Kageni-wq/kicad/README.md

# kicad
Kicad footprint and symbol library
