Kageni-wq/kicad/3dmodels/SDCL1V2010-1R0N-R.STEP

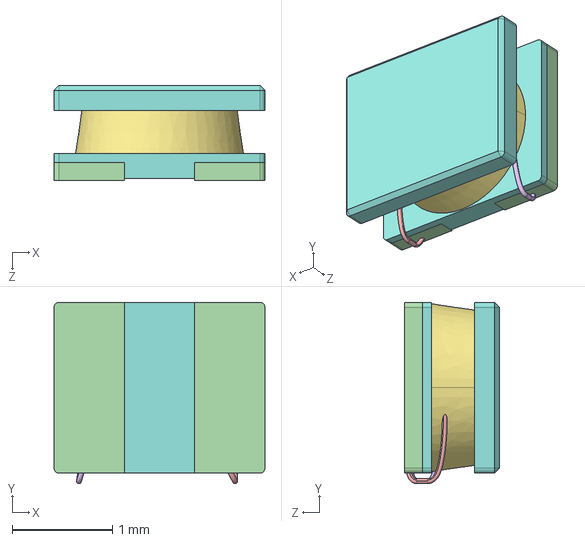
[picture p5: CAD file, 2026-09-29]
3dmodels/SDCL1V2010-1R0N-R.STEP
2.10 x 1.80 x 0.95 mm
