Kageni-wq/kicad/3dmodels/FH34SRJ-30S-0.5SH_50_.step

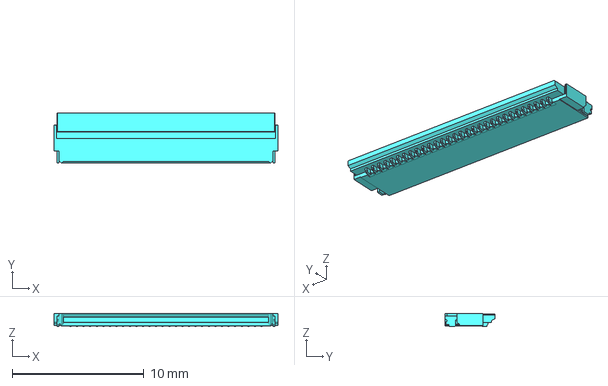
[picture p6: CAD file, 2026-08-24]
3dmodels/FH34SRJ-30S-0.5SH_50_.step
17.0 x 3.80 x 1.00 mm
