Kageni-wq/kicad/3dmodels/OK14F024.STEP

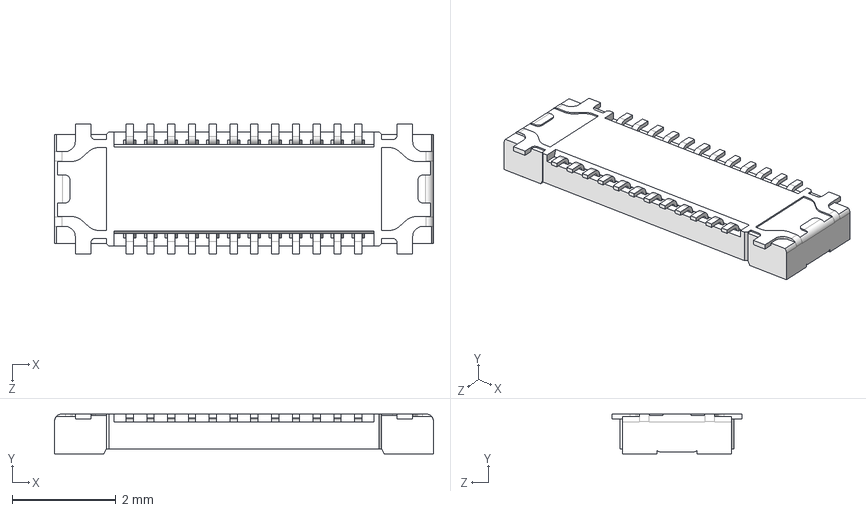
[picture p7: CAD file, 2026-08-16]
3dmodels/OK14F024.STEP
7.30 x 0.77 x 2.50 mm
