Kageni-wq/kicad/3dmodels/WS2812C_2020.STEP

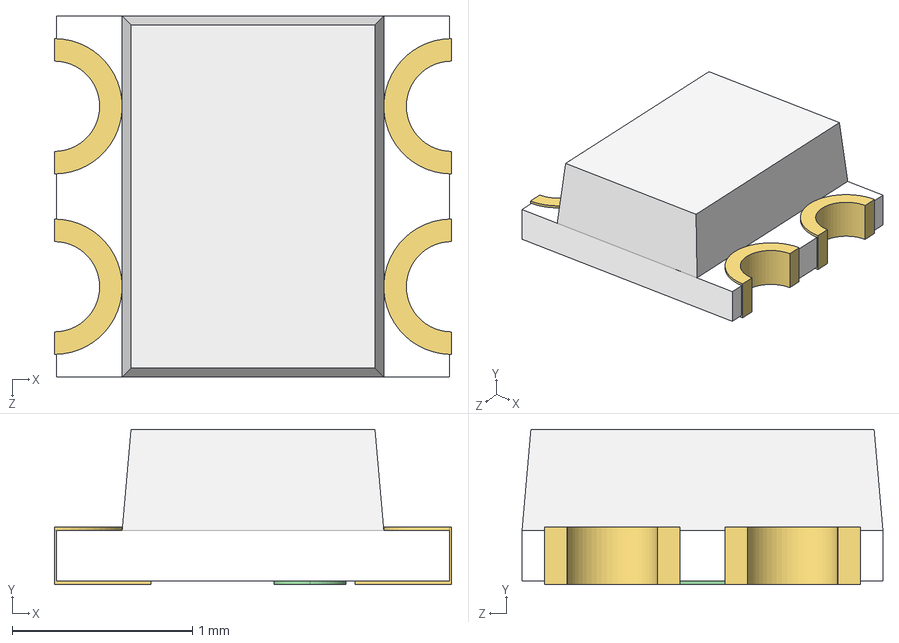
[picture p8: CAD file, 2026-08-13]
3dmodels/WS2812C_2020.STEP
2.20 x 0.86 x 2.00 mm
