Kageni-wq/kicad/3dmodels/C402_L.step

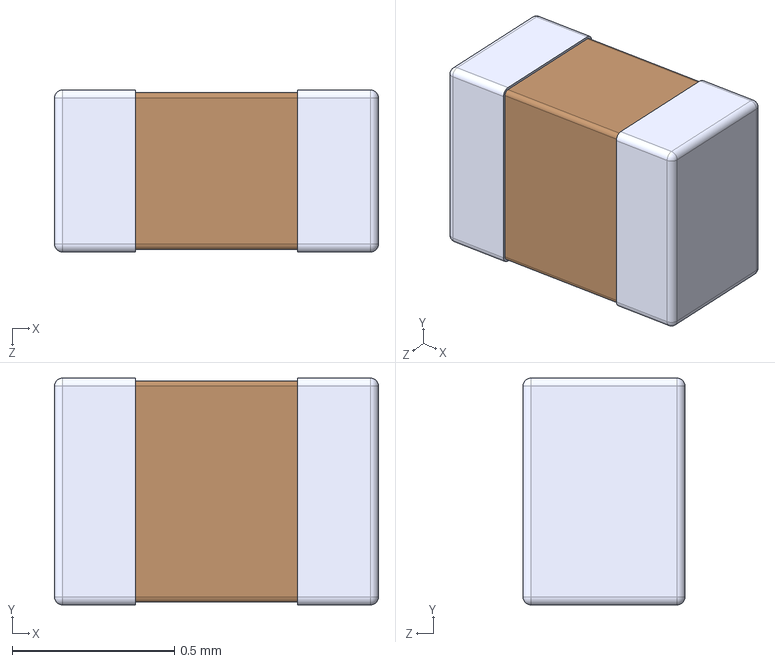
[picture p9: CAD file, 2026-08-11]
3dmodels/C402_L.step
1.00 x 0.7 x 0.5 mm
