Kageni-wq/kicad/3dmodels/C_0603_S.step

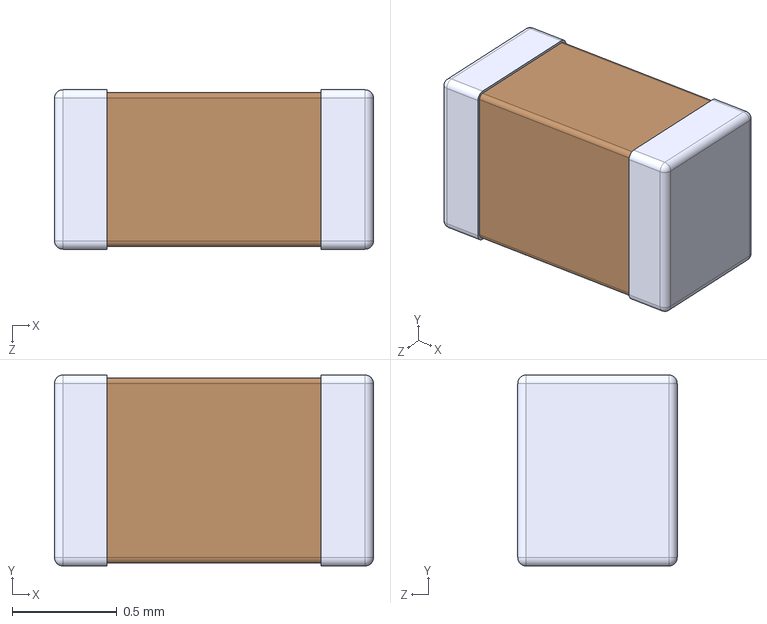
[picture p10: CAD file, 2026-08-11]
3dmodels/C_0603_S.step
1.52 x 0.91 x 0.76 mm
