Kageni-wq/kicad/3dmodels/TCK107AG_LF.step

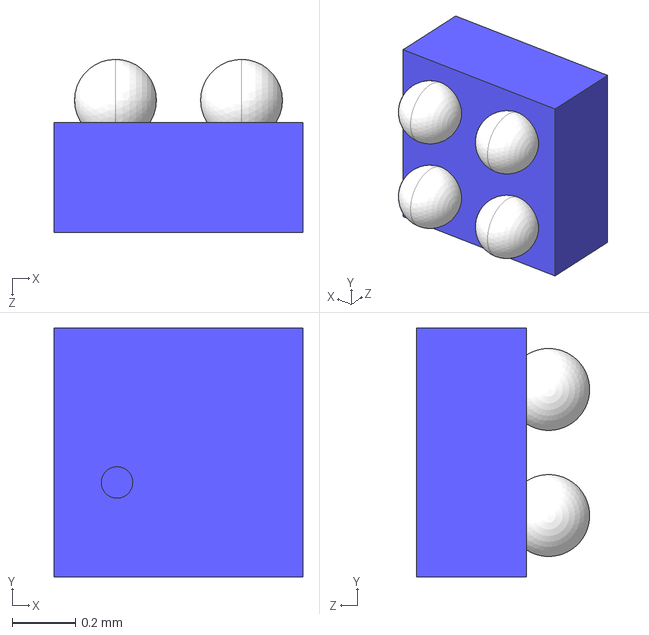
[picture p11: CAD file, 2026-08-06]
3dmodels/TCK107AG_LF.step
0.79 x 0.79 x 0.55 mm
