Kageni-wq/kicad/3dmodels/led_0603.STEP

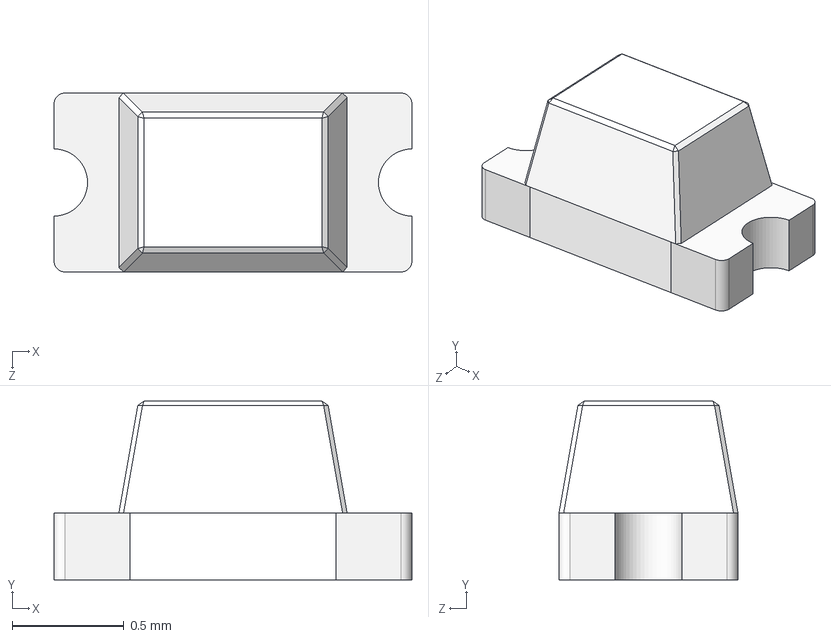
[picture p13: CAD file, 2026-07-25]
3dmodels/led_0603.STEP
1.60 x 0.8 x 0.8 mm
