Kageni-wq/kicad/3dmodels/DF40C-24DP-0.4V_51_.step

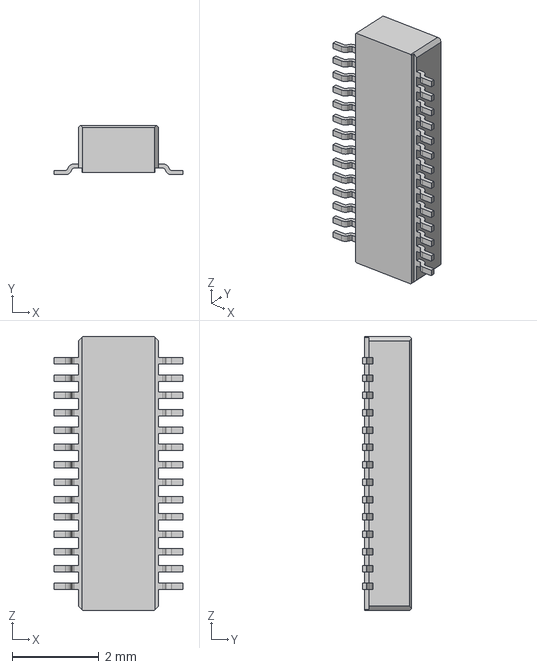
[picture p14: CAD file, 2026-07-19]
3dmodels/DF40C-24DP-0.4V_51_.step
2.97 x 1.14 x 6.32 mm
