Kageni-wq/kicad/3dmodels/810-22-003-40-001101.stp

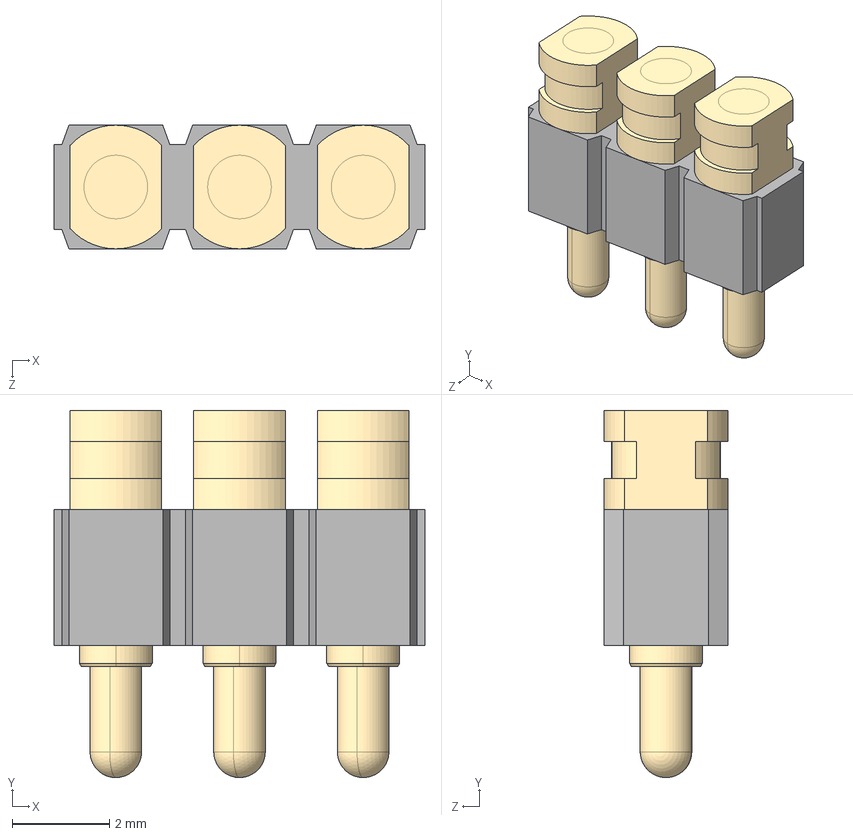
[picture p15: CAD file, 2026-07-19]
3dmodels/810-22-003-40-001101.stp
7.62 x 7.54 x 2.54 mm
P3XX-18-010-00-090000_P303-18-010-00-090000
0916_default x 3
