Kageni-wq/kicad/3dmodels/854-22-003-40-001101.stp

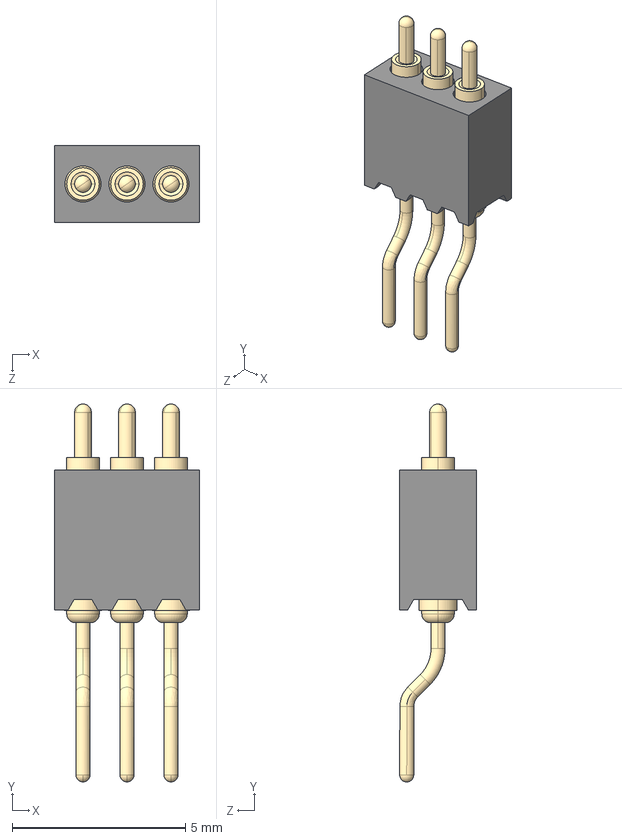
[picture p16: CAD file, 2026-07-19]
3dmodels/854-22-003-40-001101.stp
4.19 x 10.9 x 2.21 mm
P8XX-18-013-02-000000_P803-18-013-02-000000
0985-2_default x 3
