Kageni-wq/kicad/3dmodels/NVT4858_NXP.step

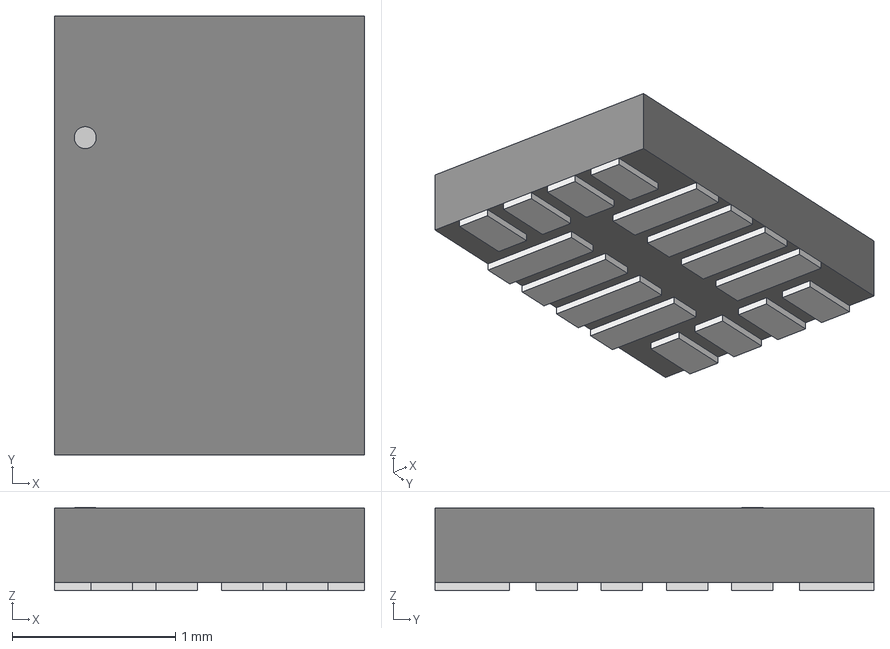
[picture p17: CAD file, 2026-07-13]
3dmodels/NVT4858_NXP.step
1.90 x 2.69 x 0.511 mm
