Kageni-wq/kicad/3dmodels/817-22-004-30-001101.step

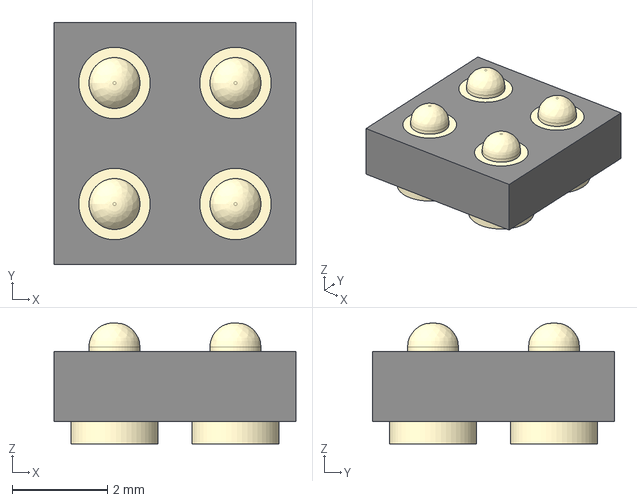
[picture p18: CAD file, 2026-07-09]
3dmodels/817-22-004-30-001101.step
5.08 x 5.08 x 2.54 mm
