Kageni-wq/kicad/3dmodels/DF40C-20DS-0.4V_51_.step

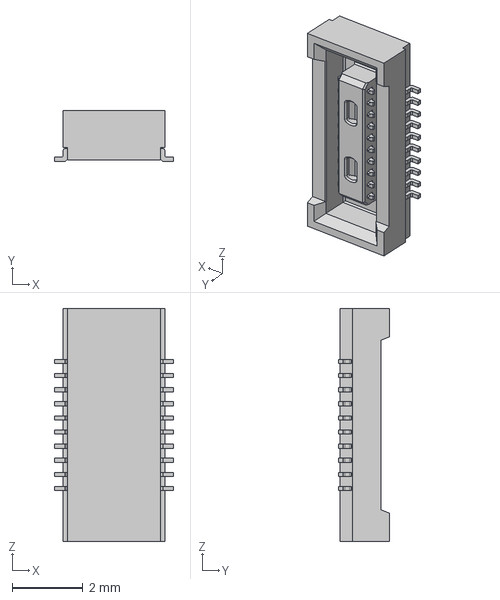
[picture p19: CAD file, 2026-07-08]
3dmodels/DF40C-20DS-0.4V_51_.step
3.38 x 1.45 x 6.60 mm
