Kageni-wq/kicad/3dmodels/DF40C-20DP-0.4V_51_.step

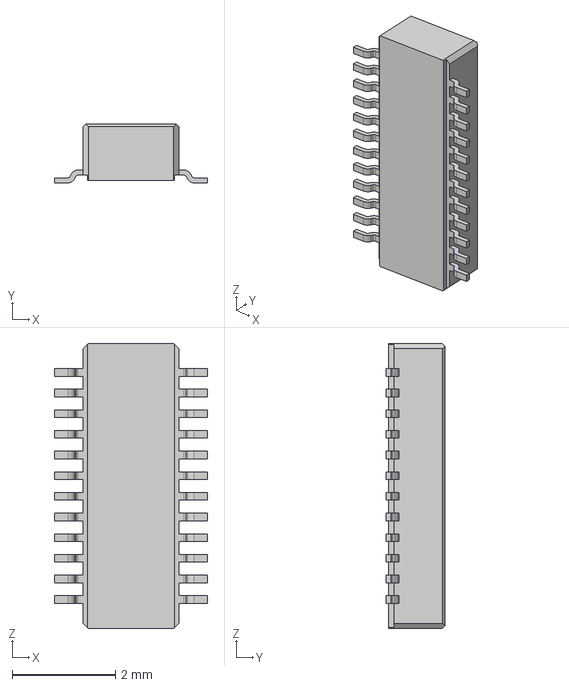
[picture p20: CAD file, 2026-07-08]
3dmodels/DF40C-20DP-0.4V_51_.step
2.97 x 1.14 x 5.52 mm
