Kageni-wq/kicad/3dmodels/WT02V40V.stp

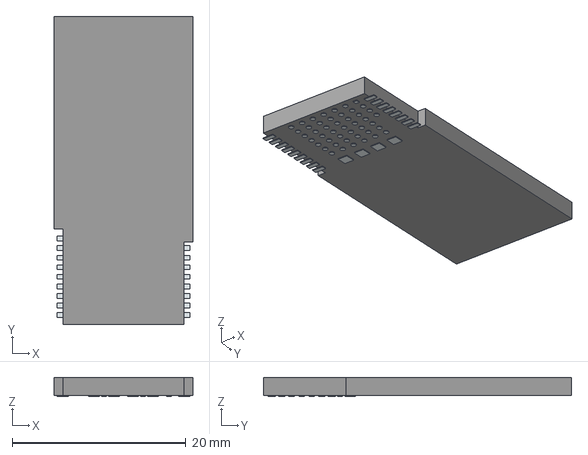
[picture p21: CAD file, 2026-07-07]
3dmodels/WT02V40V.stp
16.0 x 35.5 x 2.20 mm
Pins
