Kageni-wq/kicad/3dmodels/LQM2MPN2R2NG0L.step

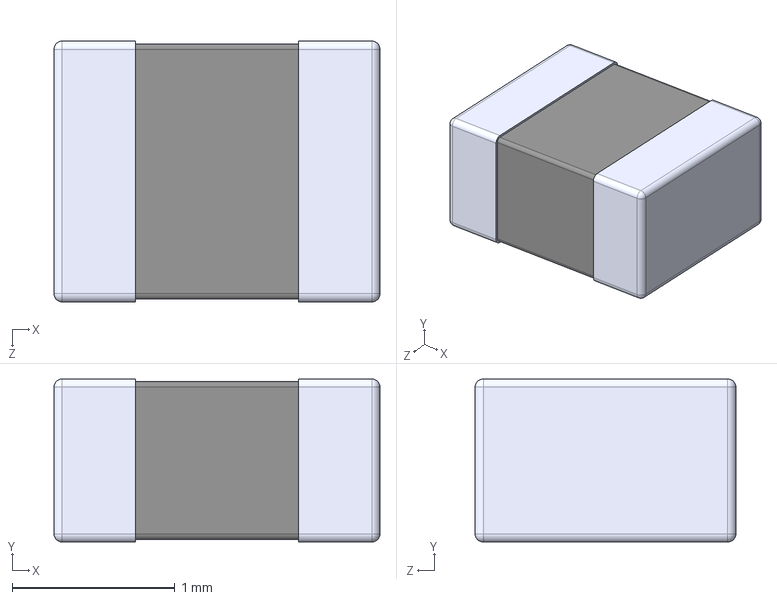
[picture p22: CAD file, 2026-07-03]
3dmodels/LQM2MPN2R2NG0L.step
2.00 x 1.00 x 1.60 mm
