Kageni-wq/kicad/3dmodels/SIT1532AC-J5-DCC-32.768E.step

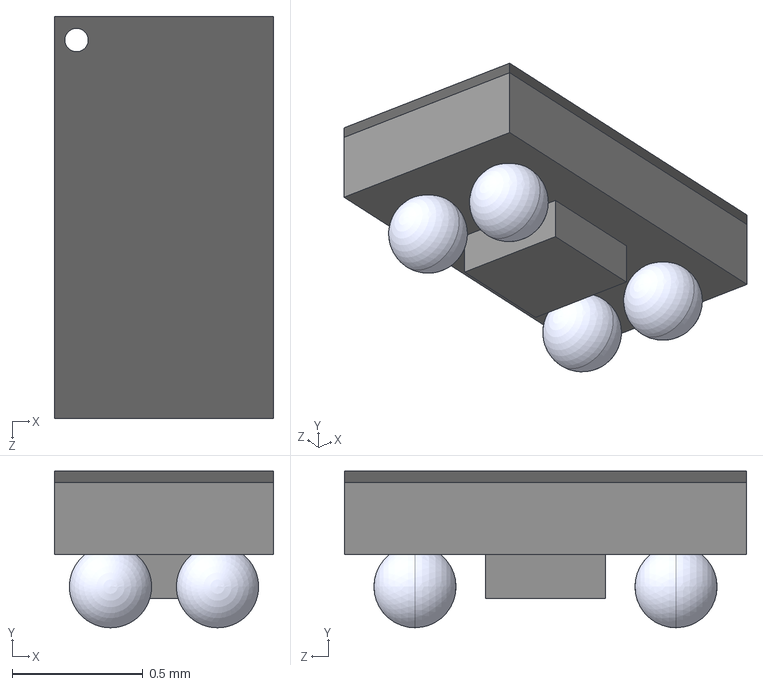
[picture p23: CAD file, 2026-07-03]
3dmodels/SIT1532AC-J5-DCC-32.768E.step
0.84 x 0.6 x 1.54 mm
