Kageni-wq/kicad/3dmodels/IS25WP128-RHLE.stp

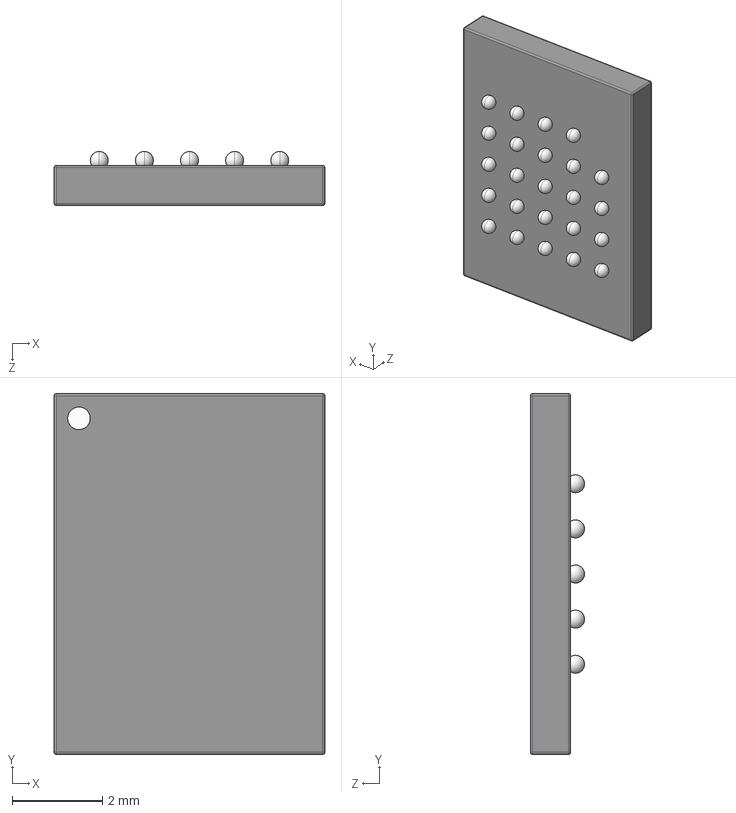
[picture p24: CAD file, 2026-06-29]
3dmodels/IS25WP128-RHLE.stp
6.00 x 8.00 x 1.20 mm
