Kageni-wq/kicad/3dmodels/AE302F80F55D5LE-Y.stp

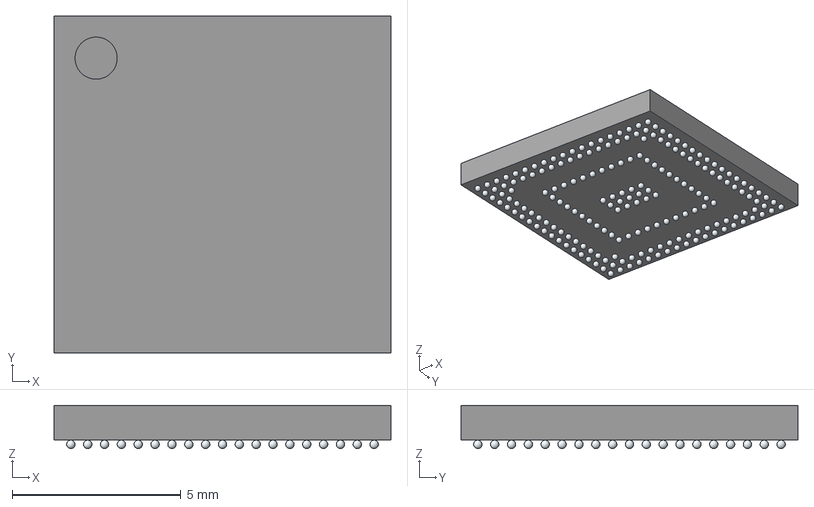
[picture p25: CAD file, 2026-06-29]
3dmodels/AE302F80F55D5LE-Y.stp
10.0 x 10.0 x 1.28 mm
A1
A2
A3
A4
A5
A6
A7
A8
A9
A10
A11
A12
A13
A14
A15
A16
A17
A18
A19
B1
B2
B3
B4
B5
B6
B7
B8
B9
B10
B11
B12
B13
B14
B15
B16
B17
B18
B19
C1
C2
C3
C18
C19
D1
D2
D18
D19
E1
E2
E5
E6
E7
E8
E9
E10
E11
E12
E13
E14
E15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
