Kageni-wq/kicad/3dmodels/NPM1300-CAAA-R.step

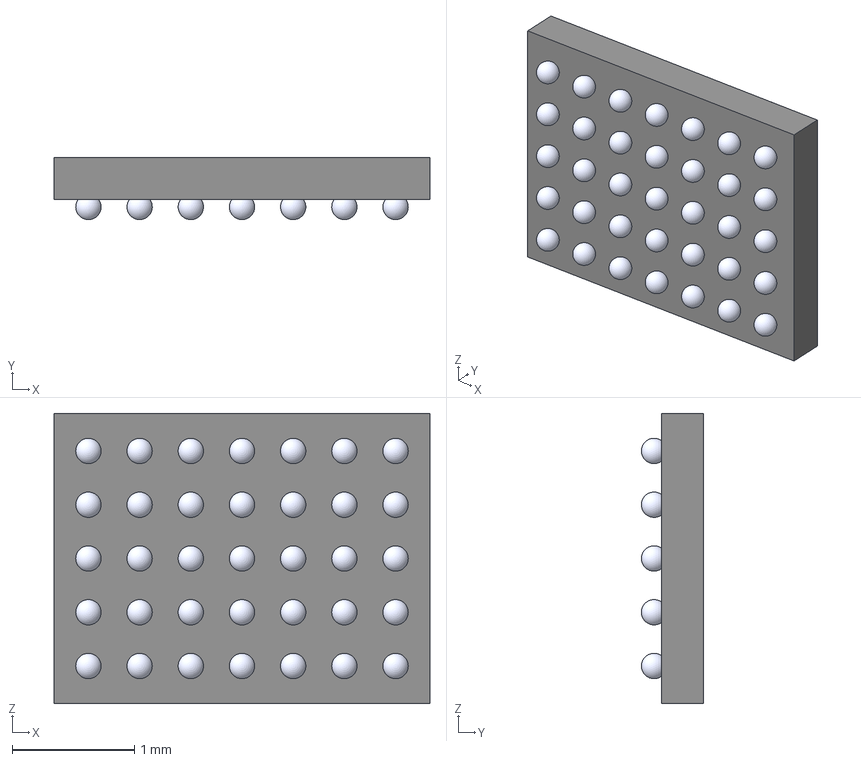
[picture p26: CAD file, 2026-06-27]
3dmodels/NPM1300-CAAA-R.step
3.08 x 0.51 x 2.38 mm
Body_Solid1
Body002_Solid1
BALL_0001
BALL_0002
BALL_0003
BALL_0004
BALL_0005
BALL_0006
BALL_0007
BALL_0008
BALL_0009
BALL_0010
BALL_0011
BALL_0012
BALL_0013
BALL_0014
BALL_0015
BALL_0016
BALL_0017
BALL_0018
BALL_0019
BALL_0020
BALL_0021
BALL_0022
BALL_0023
BALL_0024
BALL_0025
BALL_0026
BALL_0027
BALL_0028
BALL_0029
BALL_0030
BALL_0031
BALL_0032
BALL_0033
BALL_0034
BALL_0035
