Kageni-wq/kicad/3dmodels/PCMD3180QRGERQ1.step

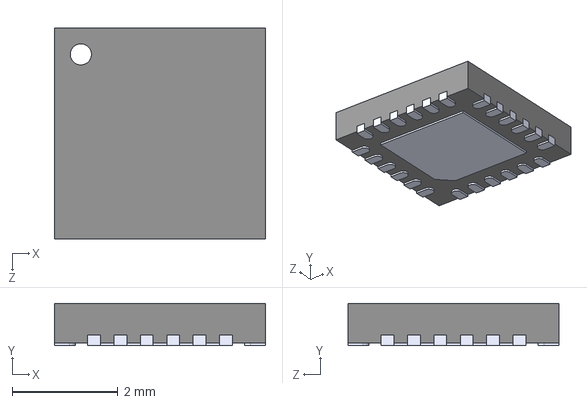
[picture p27: CAD file, 2026-06-21]
3dmodels/PCMD3180QRGERQ1.step
4.00 x 0.8 x 4.00 mm
