Kageni-wq/kicad/3dmodels/WSON8L_8X6X0_8_EP3_4X4_3_MAC.step

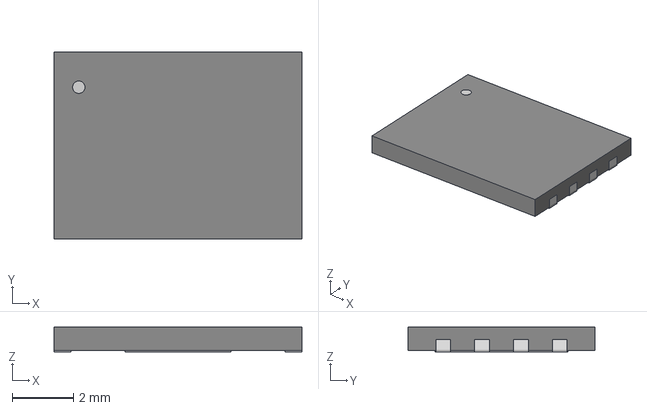
[picture p28: CAD file, 2026-06-21]
3dmodels/WSON8L_8X6X0_8_EP3_4X4_3_MAC.step
8.10 x 6.10 x 0.815 mm
