Kageni-wq/kicad/3dmodels/FH34SRJ-24S-0.5SH_50_.step

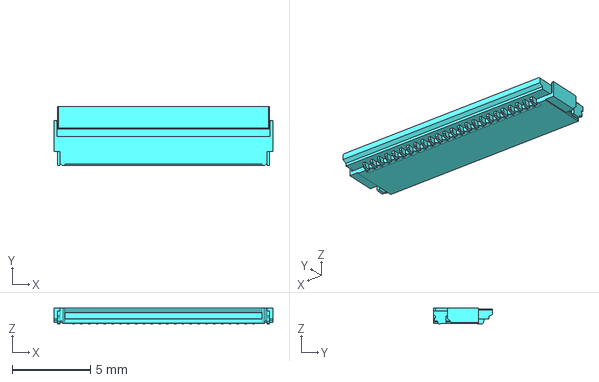
[picture p29: CAD file, 2026-06-19]
3dmodels/FH34SRJ-24S-0.5SH_50_.step
14.0 x 3.80 x 1.00 mm
