Kageni-wq/kicad/3dmodels/FH34SRJ-40S-0.5SH_50_.step

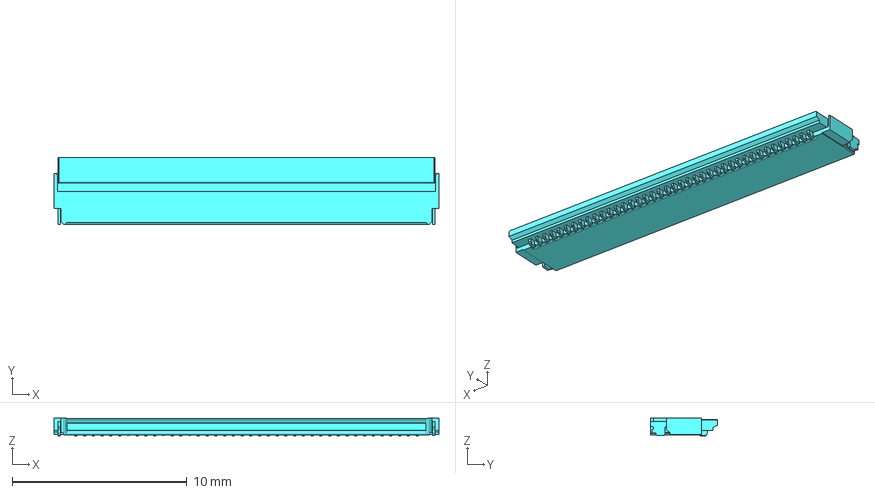
[picture p30: CAD file, 2026-06-19]
3dmodels/FH34SRJ-40S-0.5SH_50_.step
22.0 x 3.80 x 1.00 mm
