Kageni-wq/kicad/3dmodels/R7KA8D2KFLCAB.stp

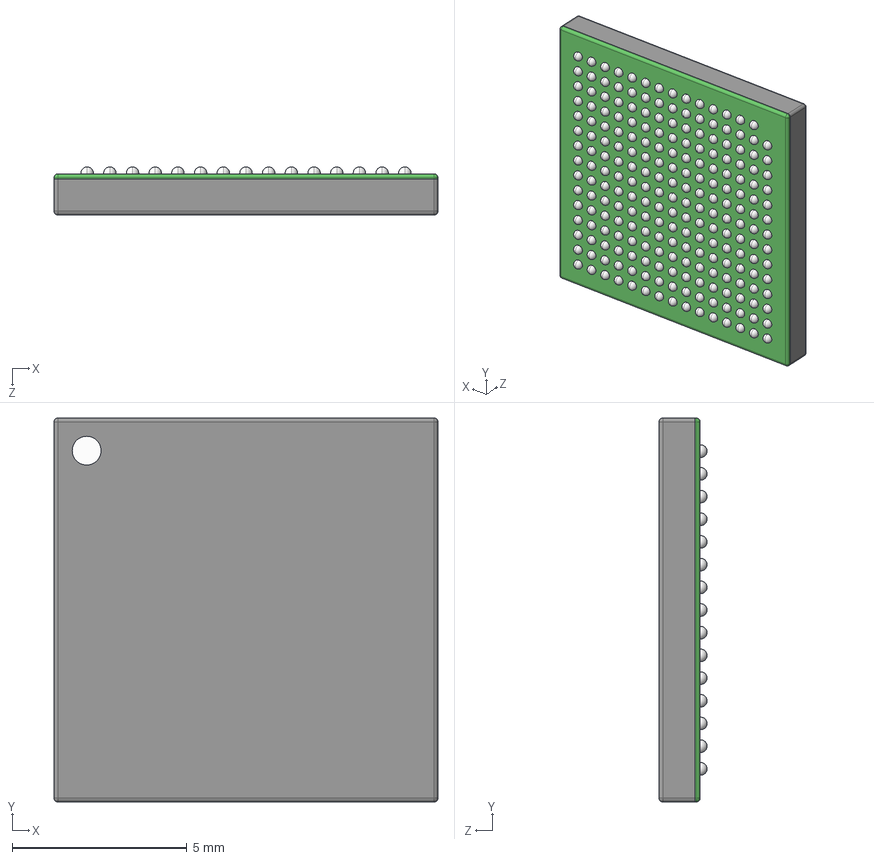
[picture p31: CAD file, 2026-06-17]
3dmodels/R7KA8D2KFLCAB.stp
11.0 x 11.0 x 1.38 mm
