Kageni-wq/kicad/3dmodels/S25FL128SAGNFI001.step

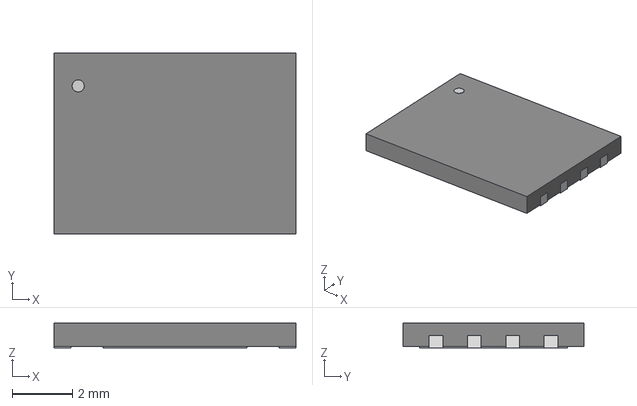
[picture p32: CAD file, 2026-06-08]
3dmodels/S25FL128SAGNFI001.step
8.00 x 5.99 x 0.815 mm
