Kageni-wq/kicad/3dmodels/LSF0102DQER.step

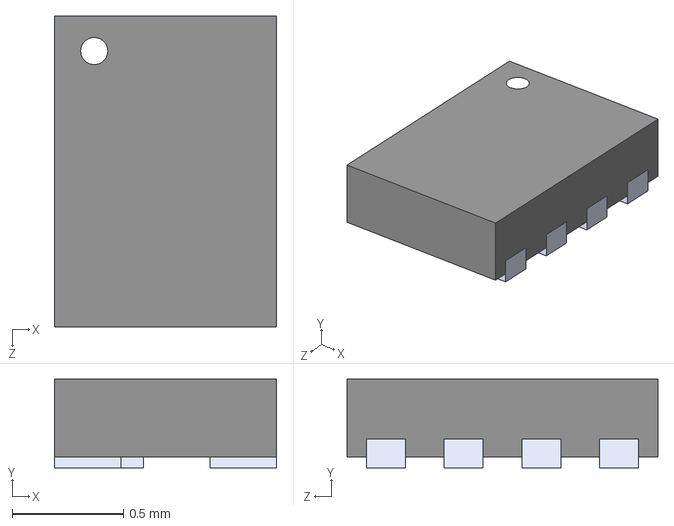
[picture p33: CAD file, 2026-06-05]
3dmodels/LSF0102DQER.step
1.00 x 0.4 x 1.40 mm
