Kageni-wq/kicad/3dmodels/74AVCH2T45GT,115.step

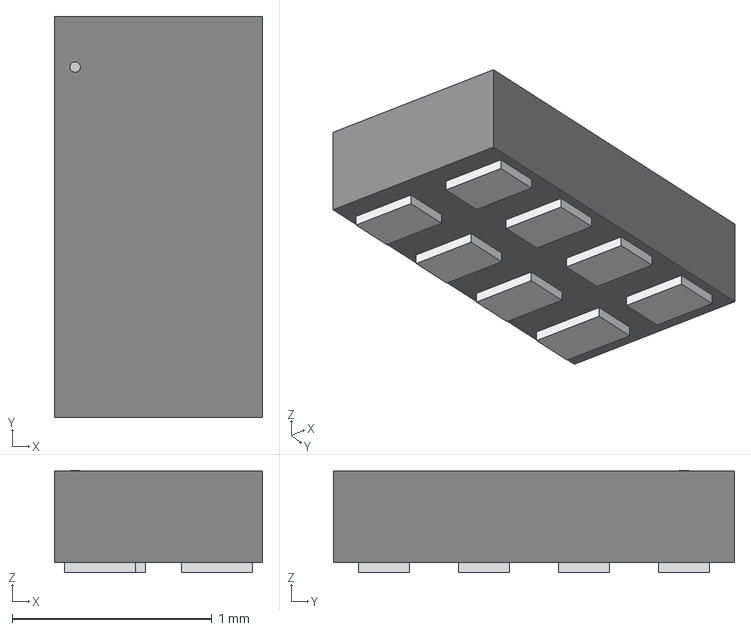
[picture p34: CAD file, 2026-06-05]
3dmodels/74AVCH2T45GT,115.step
1.04 x 2.01 x 0.511 mm
