Kageni-wq/kicad/3dmodels/R-668048.stp

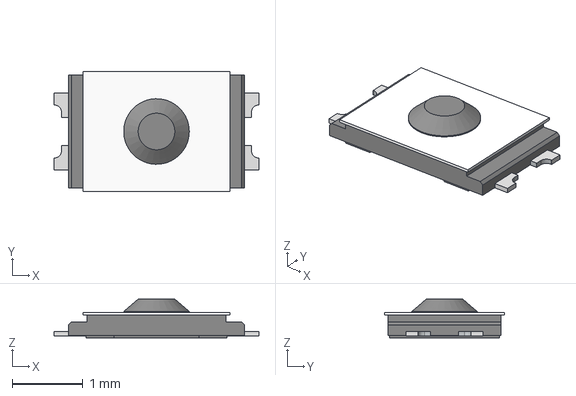
[picture p35: CAD file, 2026-05-15]
3dmodels/R-668048.stp
2.90 x 1.69 x 0.551 mm
