Kageni-wq/kicad/3dmodels/DF37NC-24DS-0.4V_51_.step

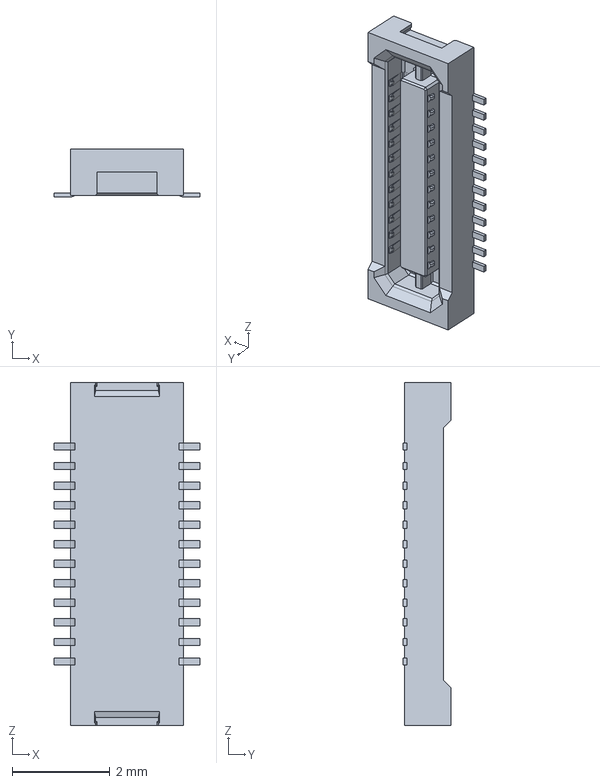
[picture p36: CAD file, 2026-05-15]
3dmodels/DF37NC-24DS-0.4V_51_.step
2.98 x 0.98 x 7.02 mm
