Kageni-wq/kicad/3dmodels/BMI270.step

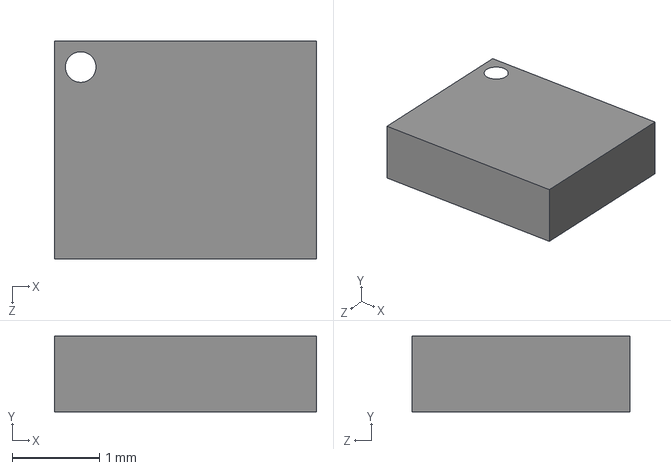
[picture p37: CAD file, 2026-05-13]
3dmodels/BMI270.step
3.00 x 0.87 x 2.50 mm
