Kageni-wq/kicad/3dmodels/NTS0104GU12_115.step

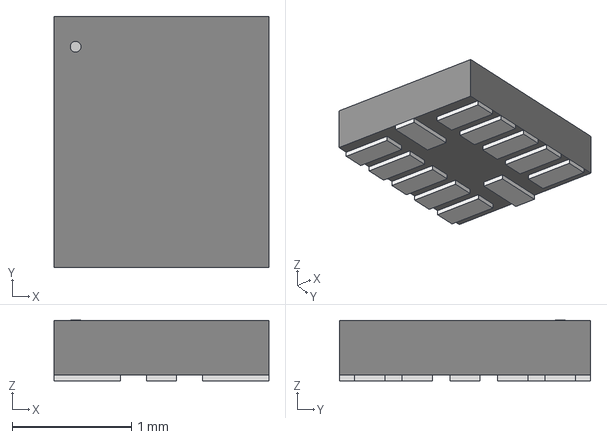
[picture p38: CAD file, 2026-05-11]
3dmodels/NTS0104GU12_115.step
1.80 x 2.11 x 0.511 mm
