Kageni-wq/kicad/3dmodels/855-22-010-30-004101.STEP

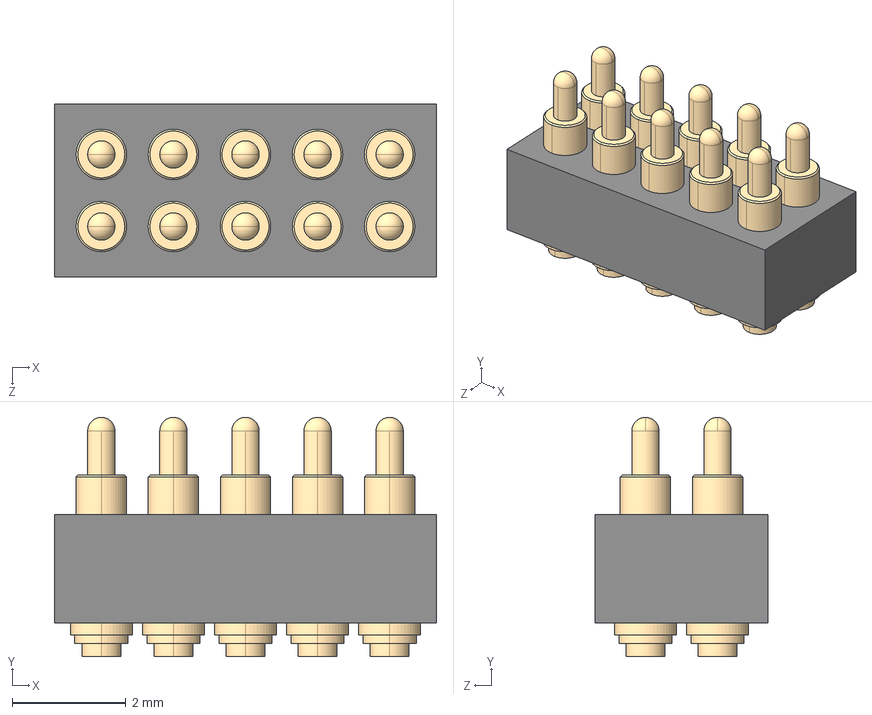
[picture p39: CAD file, 2026-05-11]
3dmodels/855-22-010-30-004101.STEP
6.73 x 4.22 x 3.05 mm
