Kageni-wq/kicad/3dmodels/usb2534.step

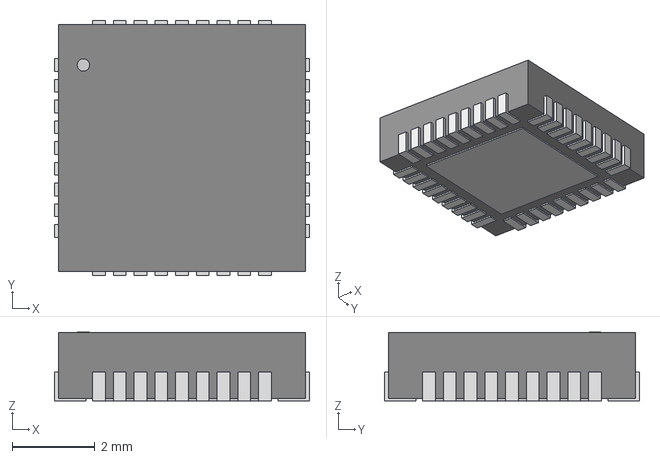
[picture p40: CAD file, 2026-04-28]
3dmodels/usb2534.step
6.15 x 6.15 x 1.65 mm
