Kageni-wq/kicad/3dmodels/MIMXRT735SGAWB.stp

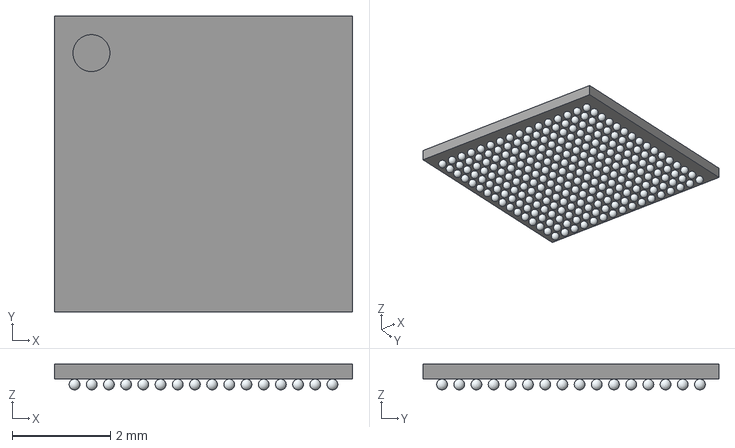
[picture p41: CAD file, 2026-04-07]
3dmodels/MIMXRT735SGAWB.stp
6.07 x 6.02 x 0.525 mm
