Kageni-wq/kicad/3dmodels/CDBU0520.step

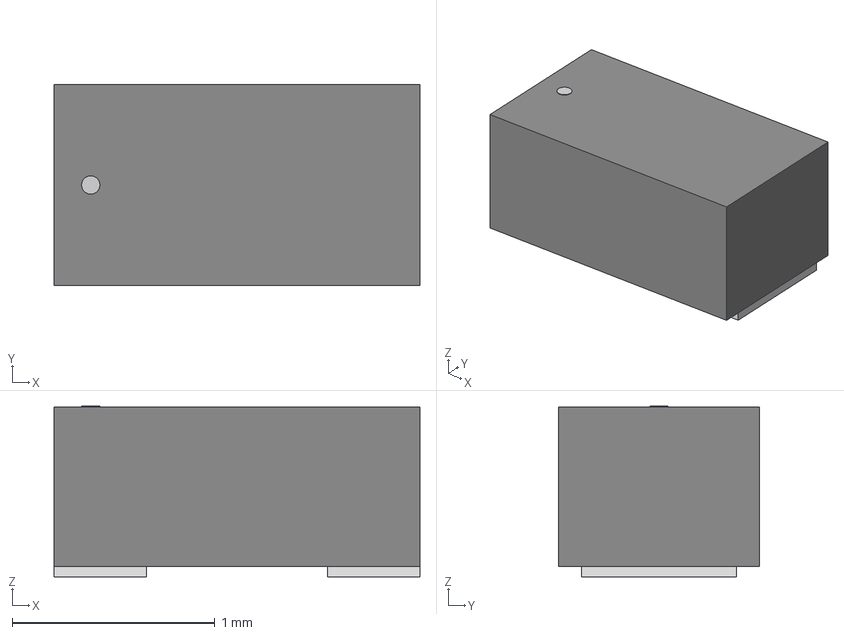
[picture p42: CAD file, 2026-04-07]
3dmodels/CDBU0520.step
1.80 x 0.99 x 0.841 mm
