Kageni-wq/kicad/3dmodels/TCK106AF_LF.step

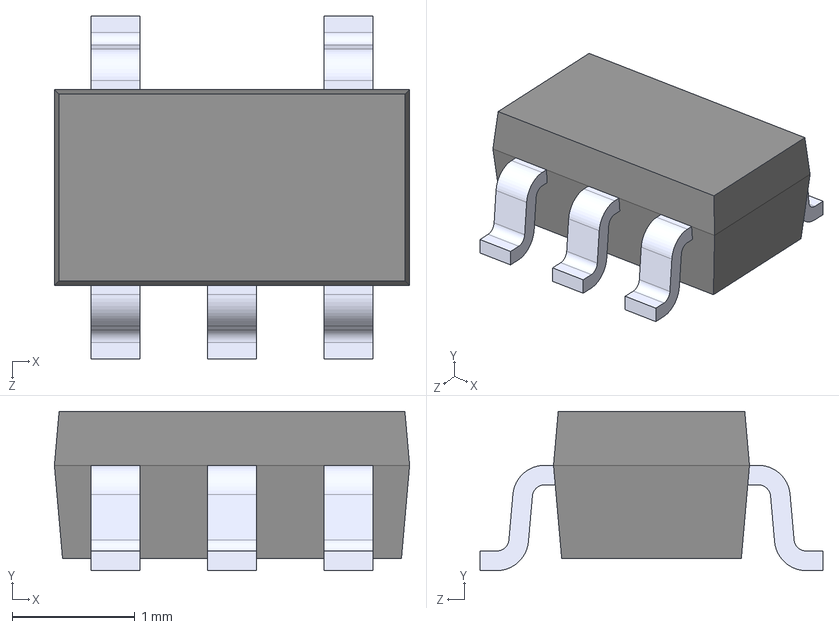
[picture p43: CAD file, 2026-04-07]
3dmodels/TCK106AF_LF.step
2.90 x 1.30 x 2.80 mm
