Kageni-wq/kicad/3dmodels/821-s1-004-30-013101.stp

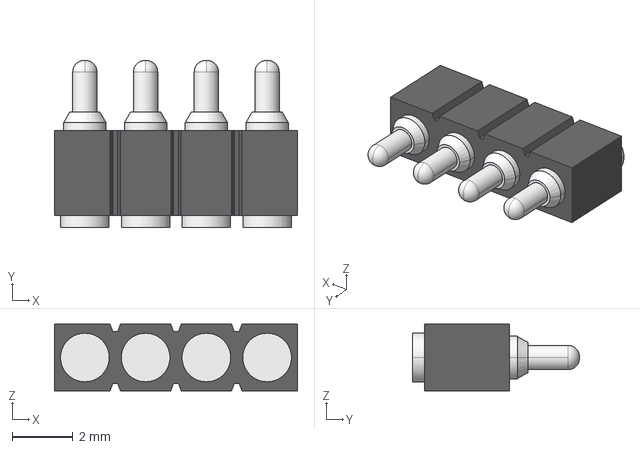
[picture p44: CAD file, 2026-04-07]
3dmodels/821-s1-004-30-013101.stp
8.00 x 5.50 x 2.20 mm
