Kageni-wq/kicad/3dmodels/TLV320ADC6140IRTWR.stp

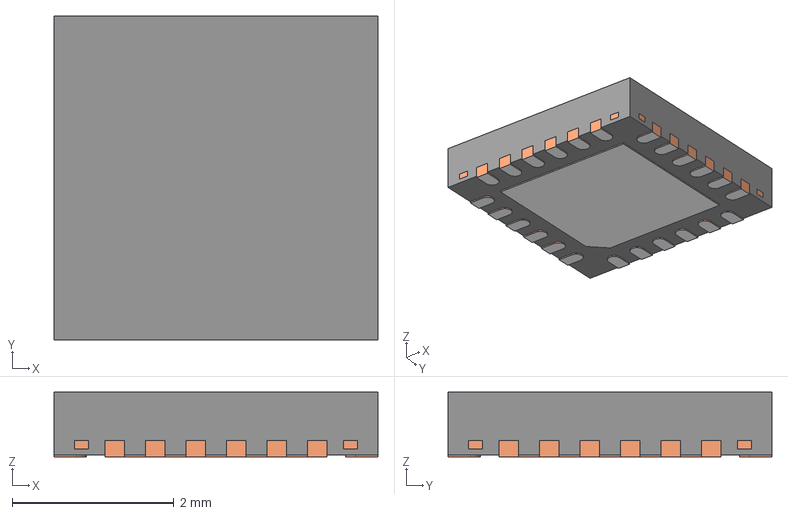
[picture p45: CAD file, 2026-04-07]
3dmodels/TLV320ADC6140IRTWR.stp
4.00 x 4.00 x 0.8 mm
BODY-QFN
FRAME-RTW0024H
PIN1-ID
