Kageni-wq/kicad/3dmodels/CP2102N-A02-GQFN28.step

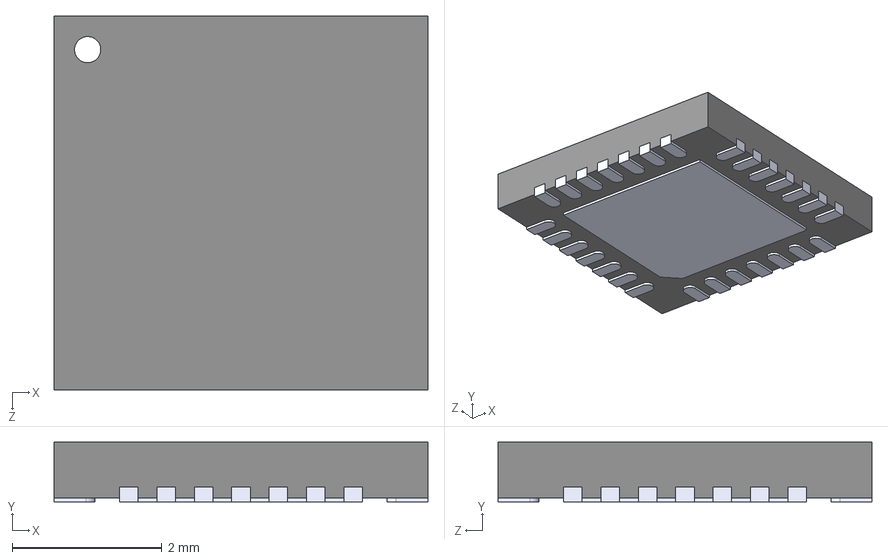
[picture p46: CAD file, 2026-04-07]
3dmodels/CP2102N-A02-GQFN28.step
5.00 x 0.8 x 5.00 mm
