Kageni-wq/kicad/3dmodels/3SM121MZT1UA.step

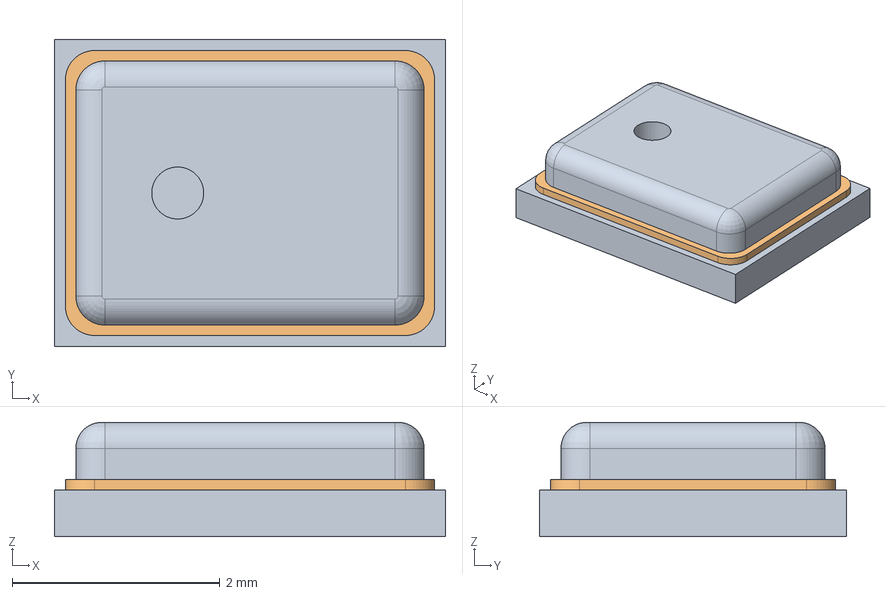
[picture p47: CAD file, 2026-04-07]
3dmodels/3SM121MZT1UA.step
3.76 x 2.95 x 1.10 mm
