Kageni-wq/kicad/3dmodels/MIMXRT685SFVKB.step

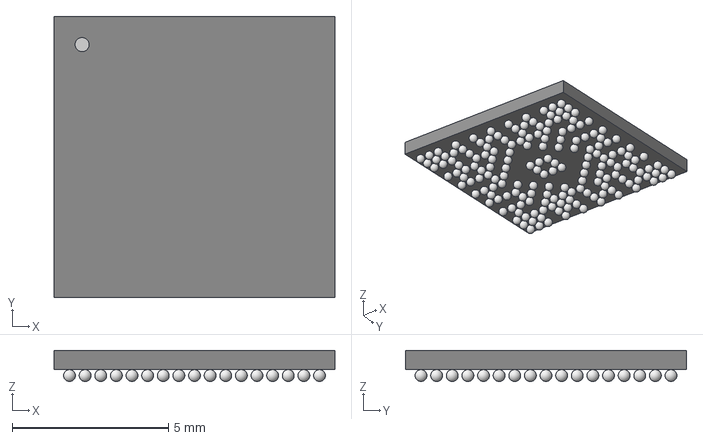
[picture p48: CAD file, 2026-04-07]
3dmodels/MIMXRT685SFVKB.step
8.99 x 8.99 x 0.994 mm
