Kageni-wq/kicad/3dmodels/FAN5622SX.step

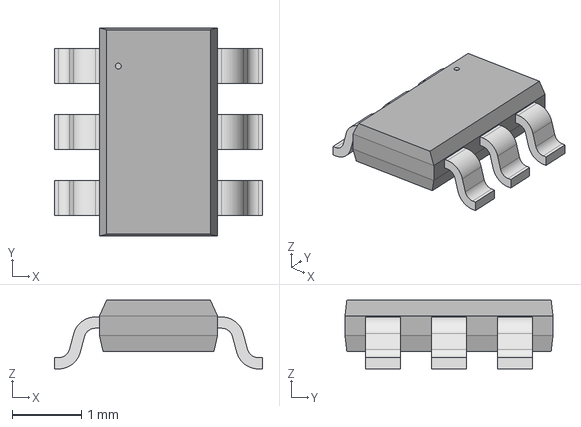
[picture p49: CAD file, 2026-04-07]
3dmodels/FAN5622SX.step
3.00 x 3.00 x 0.993 mm
