Kageni-wq/kicad/3dmodels/ABM8G-12.288MHZ-18-D2Y-T.step

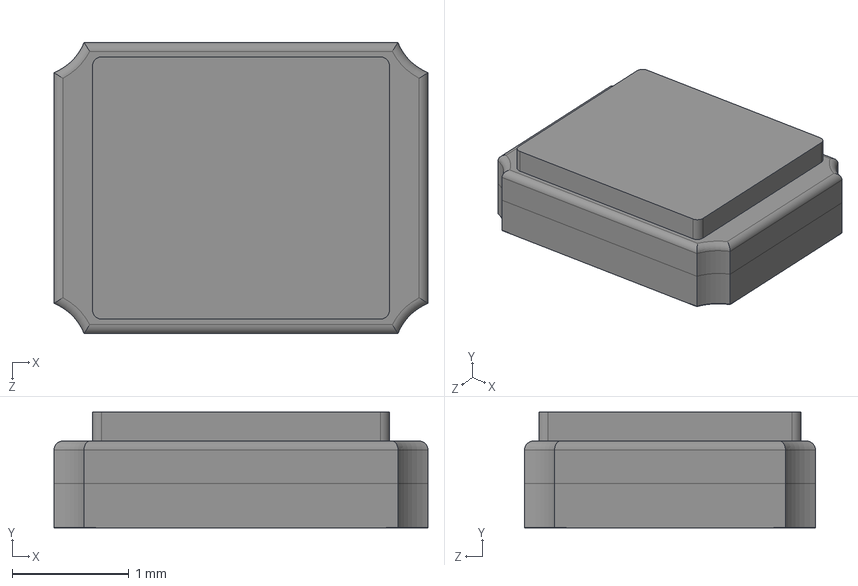
[picture p50: CAD file, 2026-04-07]
3dmodels/ABM8G-12.288MHZ-18-D2Y-T.step
3.20 x 0.991 x 2.49 mm
