Kageni-wq/kicad/3dmodels/AD8627AKSZ.step

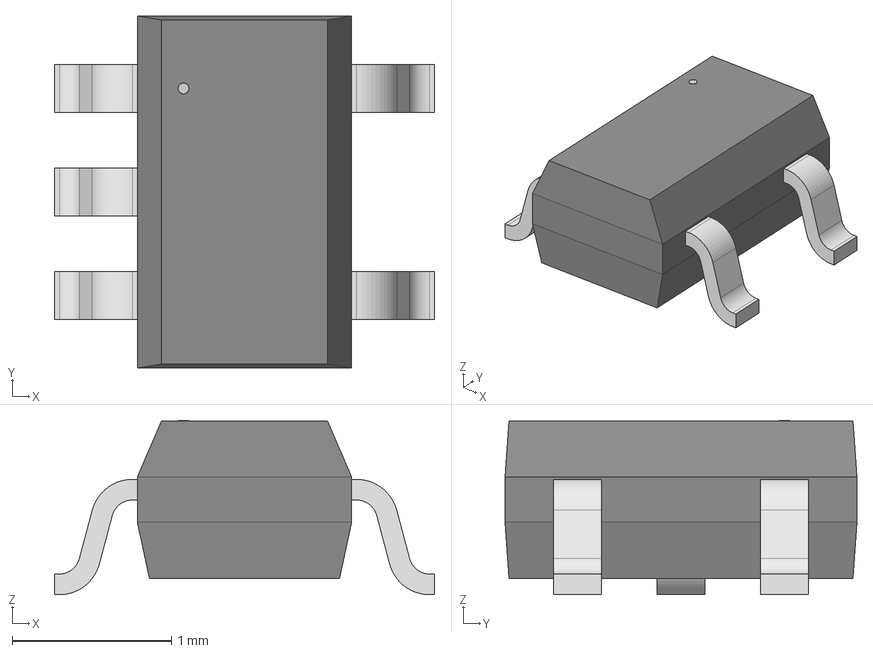
[picture p51: CAD file, 2026-04-07]
3dmodels/AD8627AKSZ.step
2.39 x 2.21 x 1.09 mm
