Kageni-wq/kicad/3dmodels/NJW4616U2_TE1.step

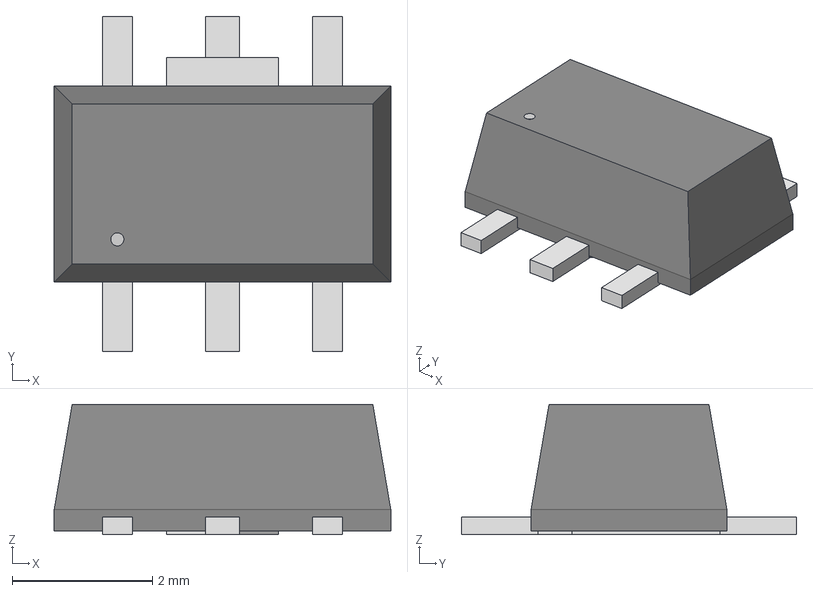
[picture p52: CAD file, 2026-04-07]
3dmodels/NJW4616U2_TE1.step
4.80 x 4.78 x 1.86 mm
