Kageni-wq/kicad/3dmodels/PCA9422BUKZ.step

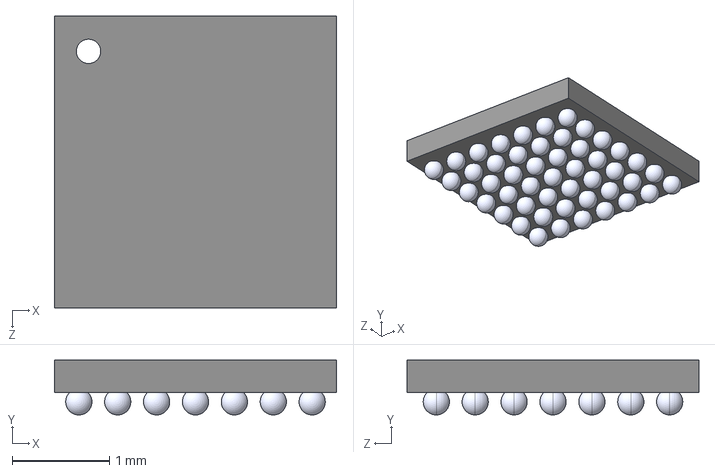
[picture p53: CAD file, 2026-04-07]
3dmodels/PCA9422BUKZ.step
2.90 x 0.565 x 3.00 mm
