Kageni-wq/kicad/3dmodels/WM8962BECSNR.step

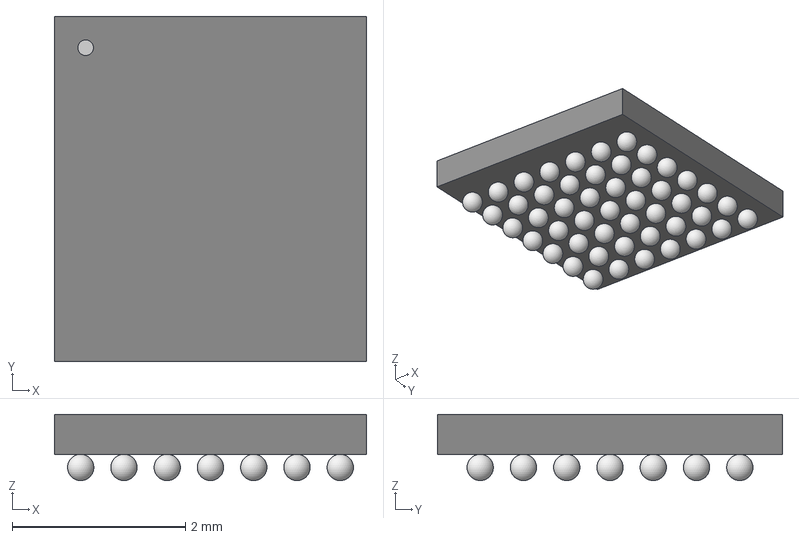
[picture p54: CAD file, 2026-04-07]
3dmodels/WM8962BECSNR.step
3.61 x 3.99 x 0.765 mm
