Kageni-wq/kicad/3dmodels/LM3644TTYFFR.step

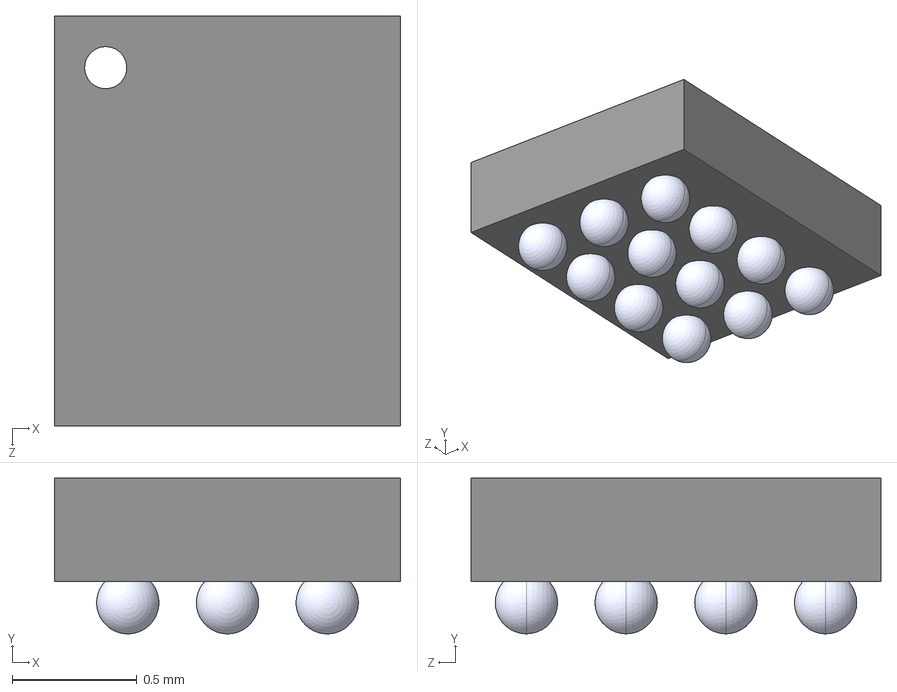
[picture p55: CAD file, 2026-04-07]
3dmodels/LM3644TTYFFR.step
1.39 x 0.625 x 1.64 mm
