Kageni-wq/kicad/3dmodels/855-22-008-30-004101.STEP

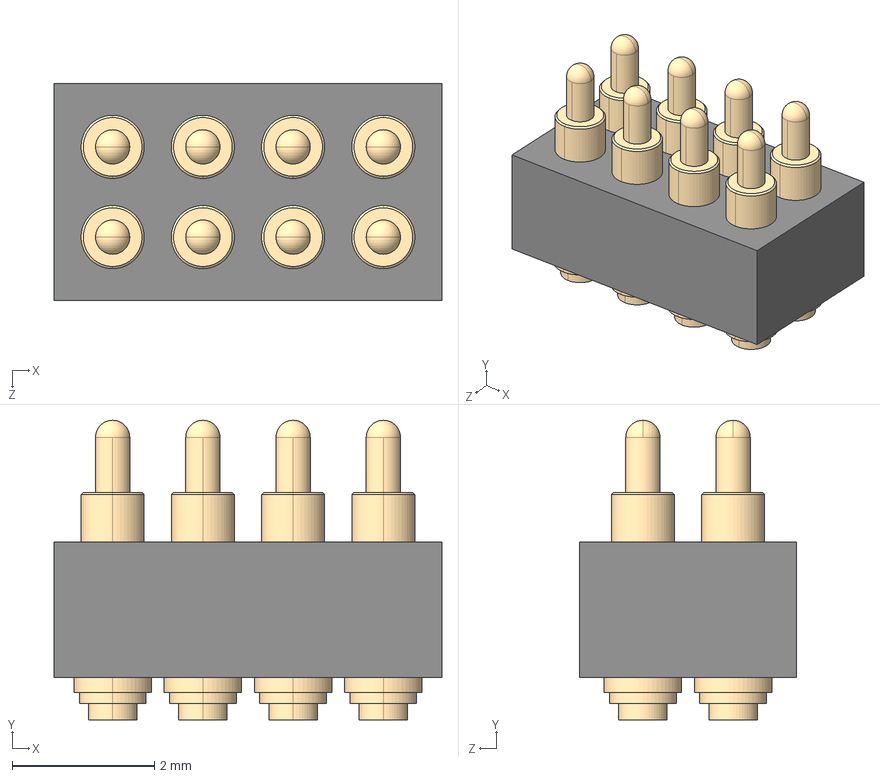
[picture p56: CAD file, 2026-04-07]
3dmodels/855-22-008-30-004101.STEP
5.46 x 4.22 x 3.05 mm
