Kageni-wq/kicad/3dmodels/MAYA-W276-00B.stp

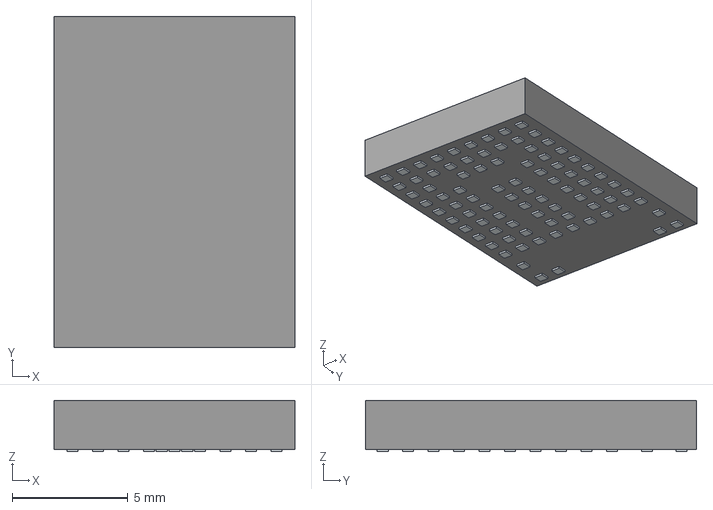
[picture p57: CAD file, 2026-04-07]
3dmodels/MAYA-W276-00B.stp
10.4 x 14.3 x 2.22 mm
Pins
