Kageni-wq/kicad/3dmodels/MIC2860_2DYC6_TR.step

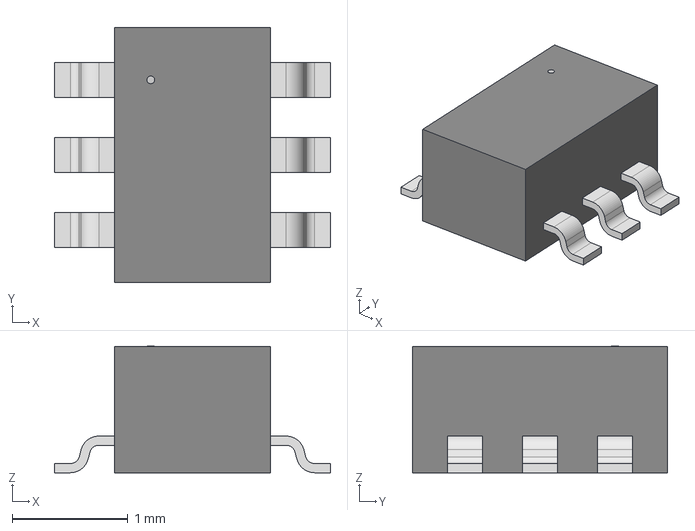
[picture p58: CAD file, 2026-04-07]
3dmodels/MIC2860_2DYC6_TR.step
2.39 x 2.21 x 1.09 mm
