Kageni-wq/kicad/3dmodels/STM32H747XIH6.step

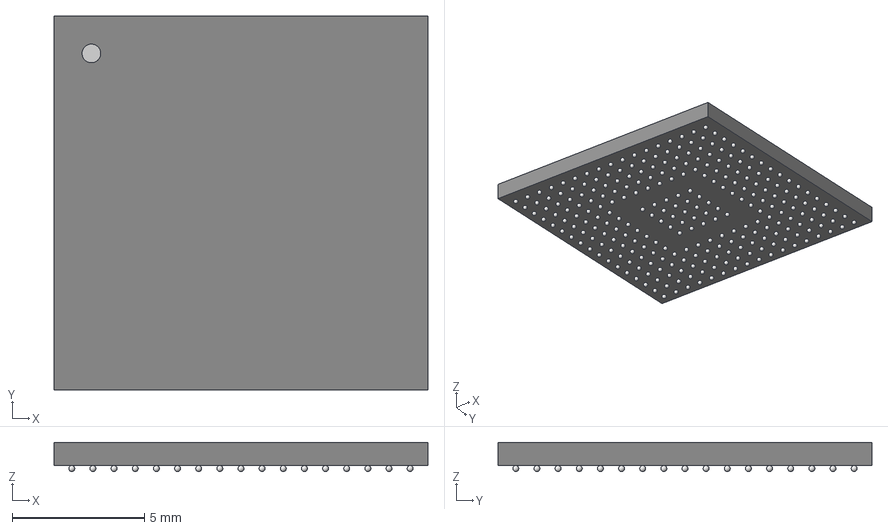
[picture p59: CAD file, 2026-04-07]
3dmodels/STM32H747XIH6.step
14.1 x 14.1 x 1.10 mm
