Kageni-wq/kicad/3dmodels/AMM-3537-B.step

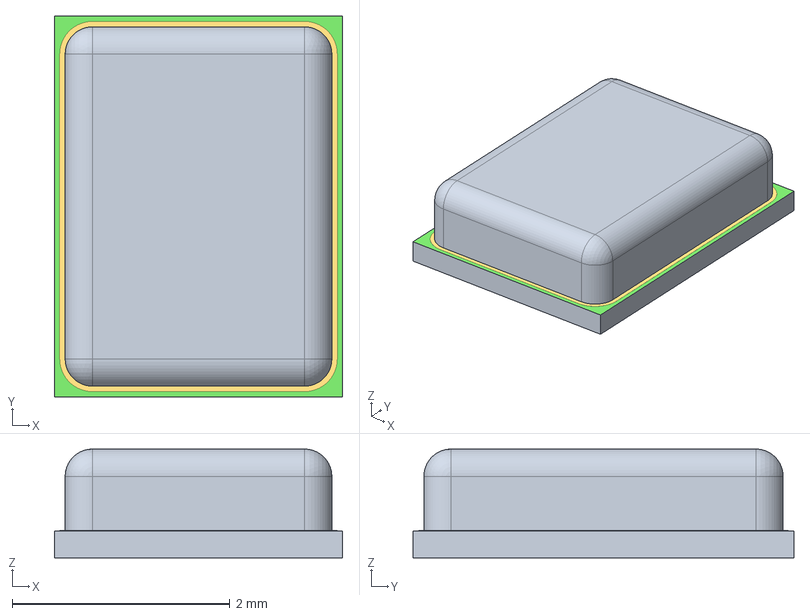
[picture p60: CAD file, 2026-04-07]
3dmodels/AMM-3537-B.step
2.65 x 3.50 x 1.00 mm
MSBR-2
MSBR-1
