Kageni-wq/kicad/3dmodels/NORA-B2x6.step

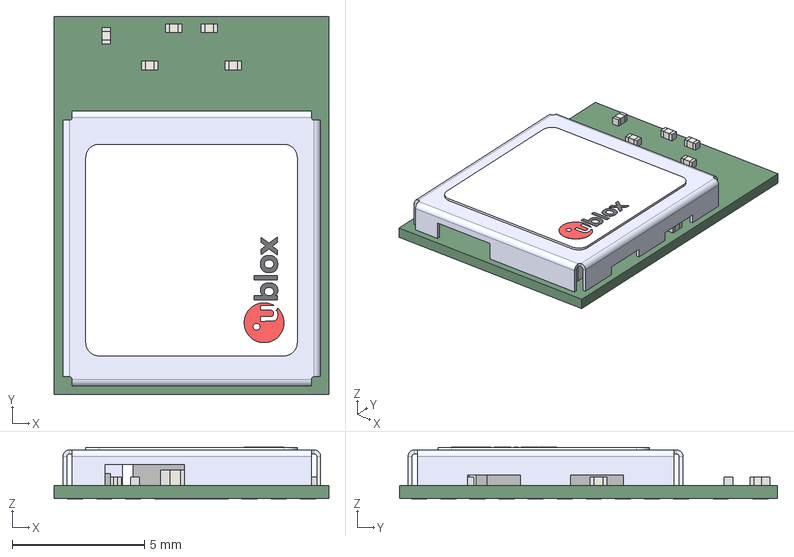
[picture p61: CAD file, 2026-04-07]
3dmodels/NORA-B2x6.step
10.4 x 14.3 x 1.97 mm
Extruded x 159
MAYA_W1_Shield_UBXH04-0000683
label_8x8
logo_x_4mm
logo_o_4mm
logo_l_4mm
logo_b_4mm
logo_u_4mm
