Kageni-wq/kicad/3dmodels/TPSM828302ARDSR.step

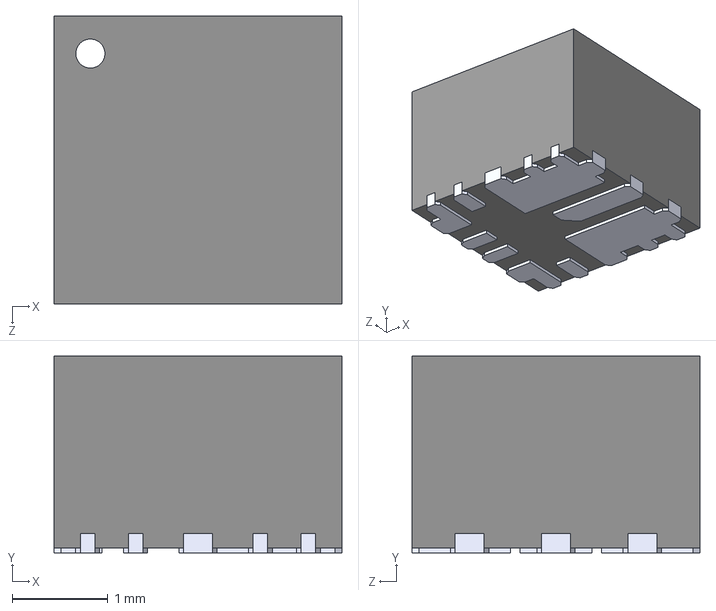
[picture p62: CAD file, 2026-04-07]
3dmodels/TPSM828302ARDSR.step
3.00 x 2.05 x 3.00 mm
