Kageni-wq/kicad/3dmodels/PCA9421BS.stp

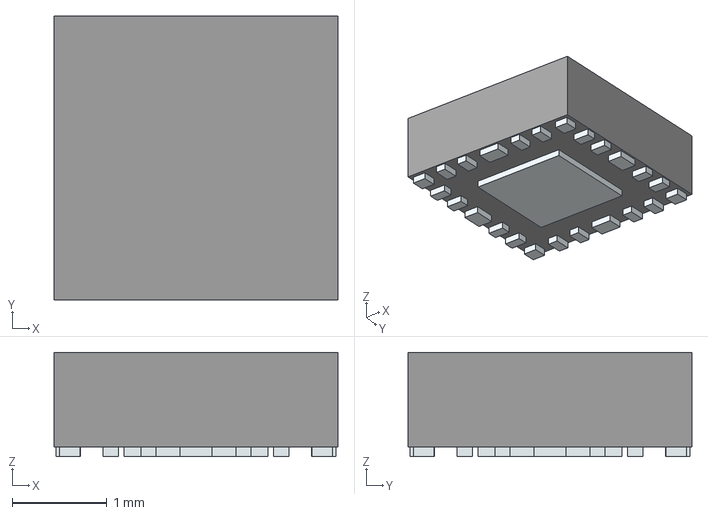
[picture p63: CAD file, 2026-04-07]
3dmodels/PCA9421BS.stp
3.00 x 3.00 x 1.10 mm
Pins
