Kageni-wq/kicad/3dmodels/WM8904CGEFL_RV.step

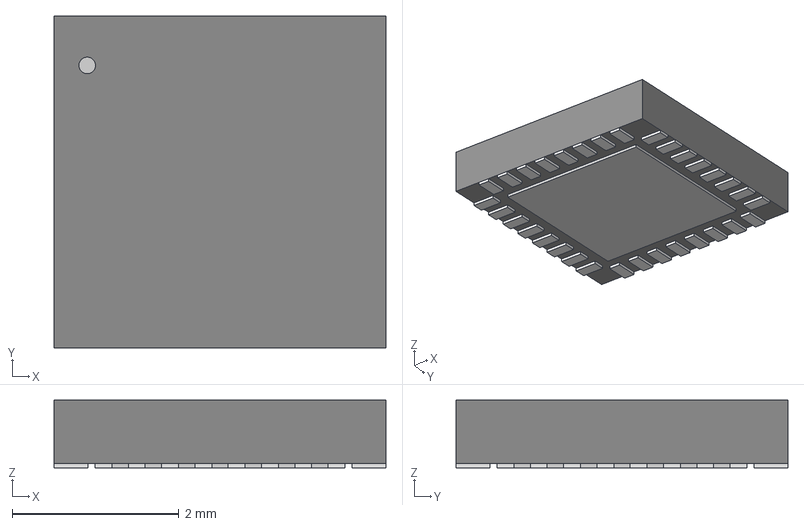
[picture p64: CAD file, 2026-04-07]
3dmodels/WM8904CGEFL_RV.step
3.99 x 3.99 x 0.815 mm
