Kageni-wq/kicad/3dmodels/OPA1692IDGKR.step

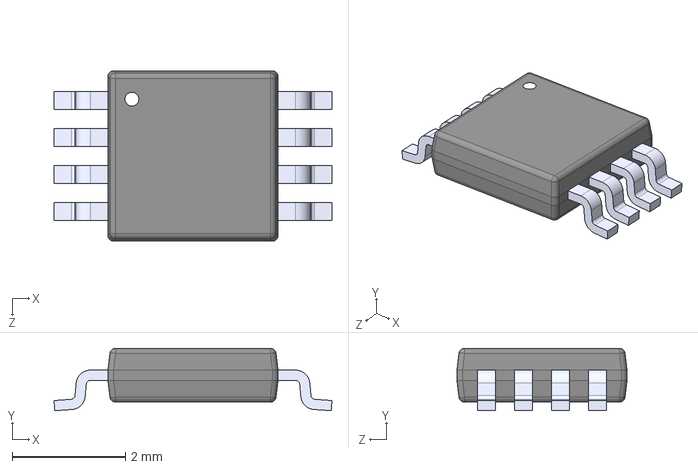
[picture p65: CAD file, 2026-04-07]
3dmodels/OPA1692IDGKR.step
4.90 x 1.10 x 3.00 mm
