Kageni-wq/kicad/3dmodels/USB4105-GF-A.step

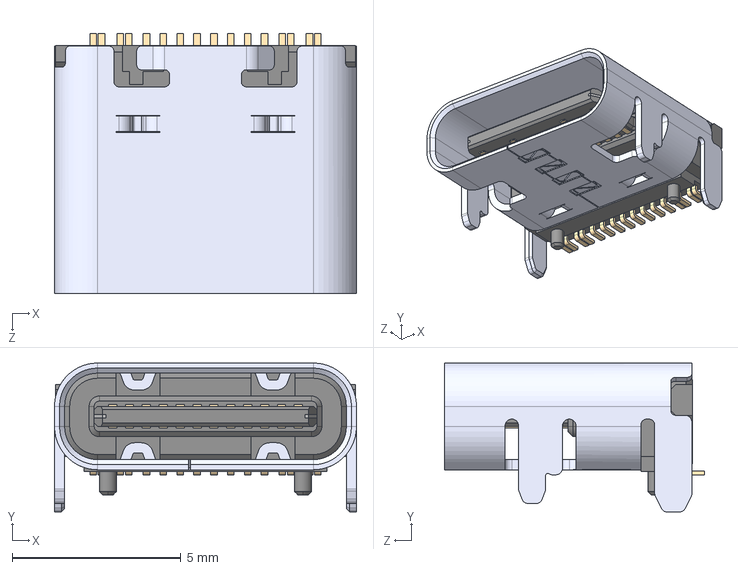
[picture p66: CAD file, 2026-04-07]
3dmodels/USB4105-GF-A.step
8.94 x 4.41 x 7.71 mm
