Kageni-wq/kicad/3dmodels/FH34SRJ-4S-0.5SH_50_.step

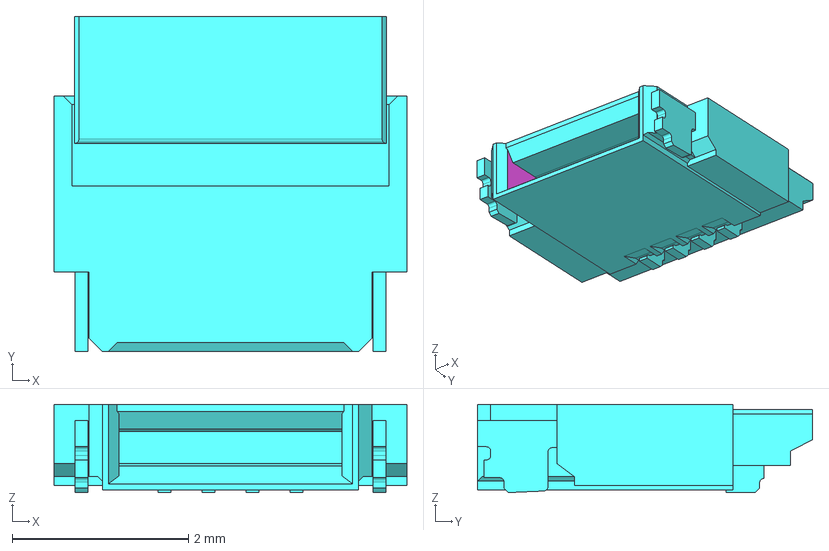
[picture p67: CAD file, 2026-04-07]
3dmodels/FH34SRJ-4S-0.5SH_50_.step
4.00 x 3.80 x 1.00 mm
