Kageni-wq/kicad/3dmodels/NCP186AMX330TAG.step

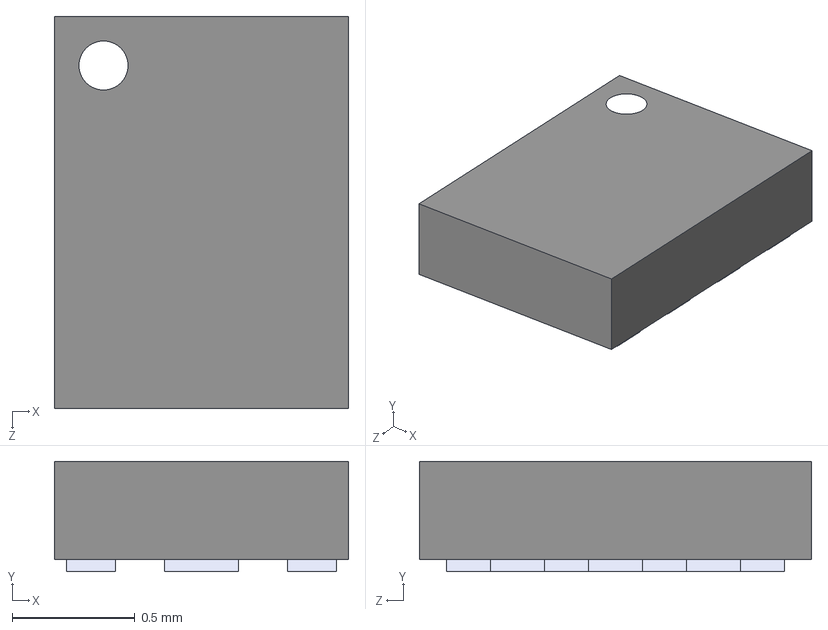
[picture p68: CAD file, 2026-04-07]
3dmodels/NCP186AMX330TAG.step
1.20 x 0.45 x 1.60 mm
