Kageni-wq/kicad/3dmodels/NINA-W106-10B.STEP

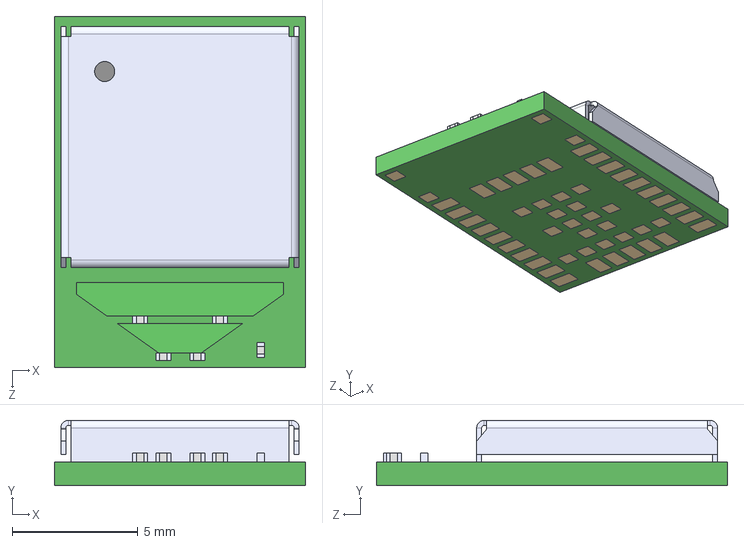
[picture p69: CAD file, 2026-04-07]
3dmodels/NINA-W106-10B.STEP
10.0 x 2.60 x 14.0 mm
