Kageni-wq/kicad/3dmodels/STM32H735IGK6.step

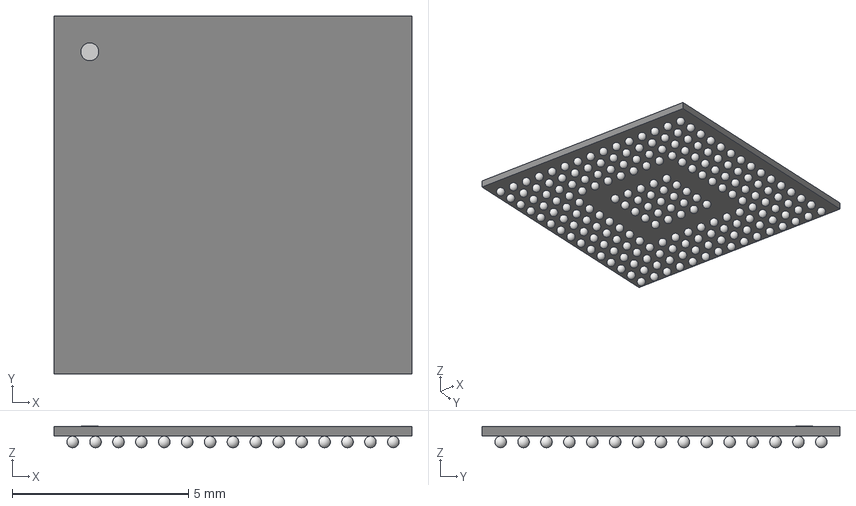
[picture p70: CAD file, 2026-04-07]
3dmodels/STM32H735IGK6.step
10.2 x 10.2 x 0.612 mm
