Kageni-wq/kicad/3dmodels/R603.step

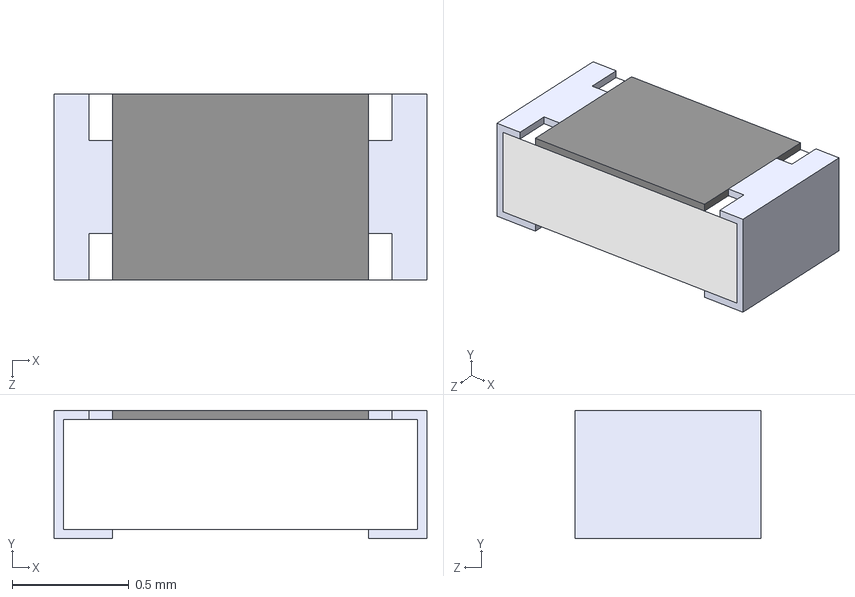
[picture p71: CAD file, 2026-01-03]
3dmodels/R603.step
1.60 x 0.55 x 0.8 mm
