Kageni-wq/kicad/3dmodels/c603.step

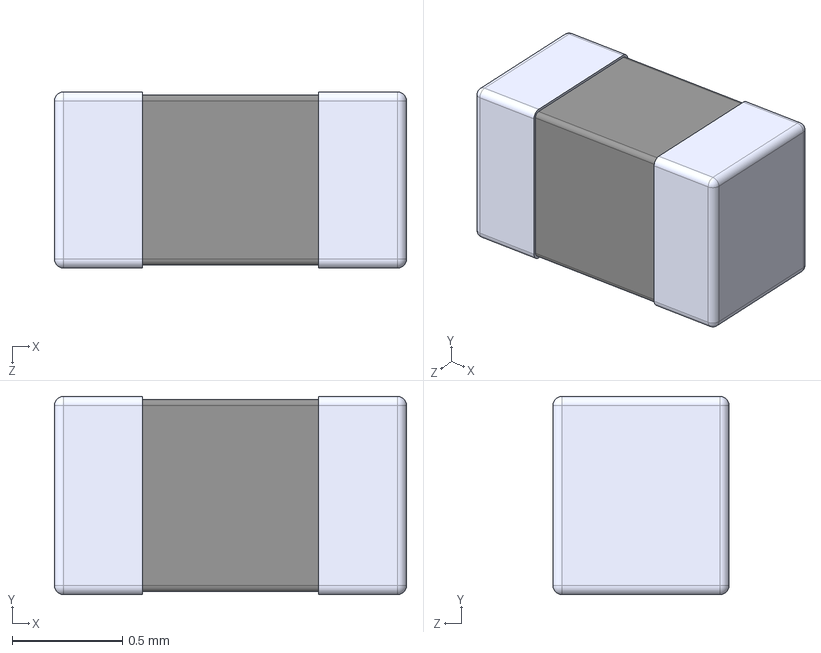
[picture p72: CAD file, 2026-01-03]
3dmodels/c603.step
1.60 x 0.9 x 0.8 mm
