Kageni-wq/kicad/3dmodels/AP2112K-3.3TRG1.STEP

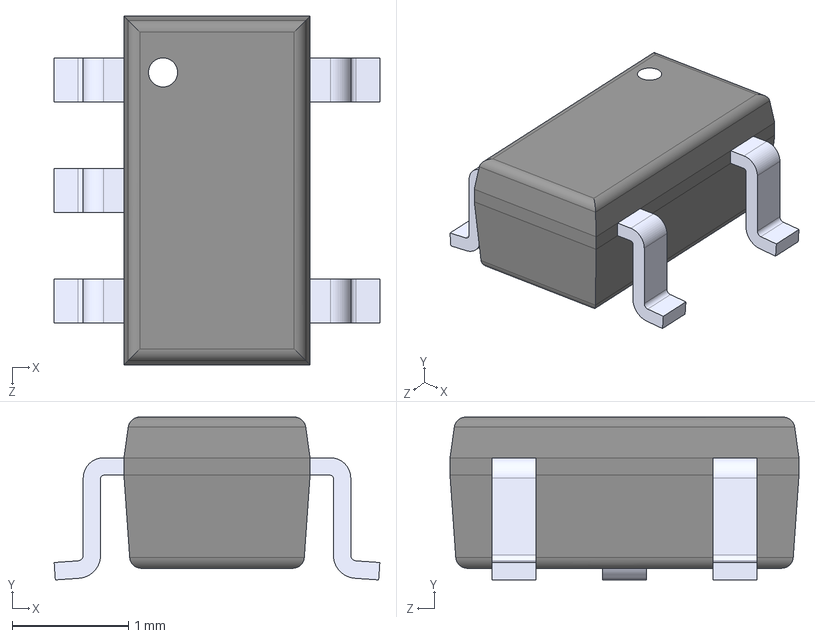
[picture p73: CAD file, 2026-01-03]
3dmodels/AP2112K-3.3TRG1.STEP
2.80 x 1.40 x 3.00 mm
