Kageni-wq/kicad/3dmodels/c805.step

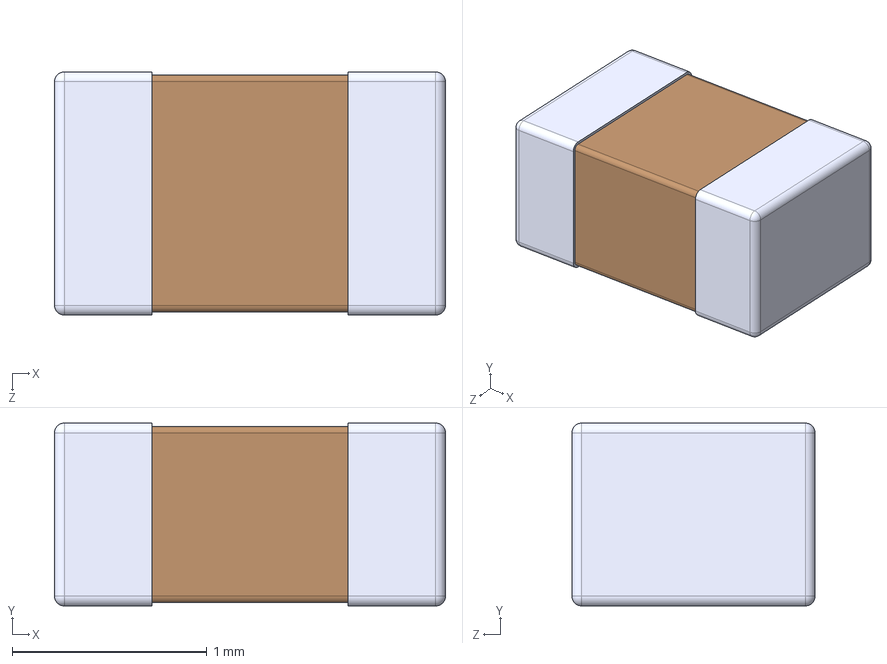
[picture p74: CAD file, 2026-01-03]
3dmodels/c805.step
2.01 x 0.94 x 1.25 mm
