Kageni-wq/kicad/3dmodels/IDC767v2A.step

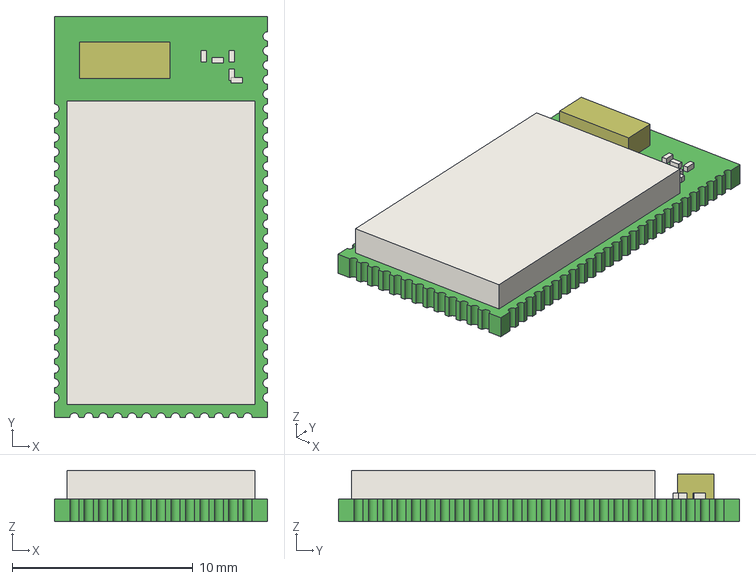
[picture p75: CAD file, 2026-01-03]
3dmodels/IDC767v2A.step
11.8 x 22.2 x 2.85 mm
Extruded x 32
