Kageni-wq/kicad/3dmodels/PTS815 SJG 250 SMTR LFS.STEP

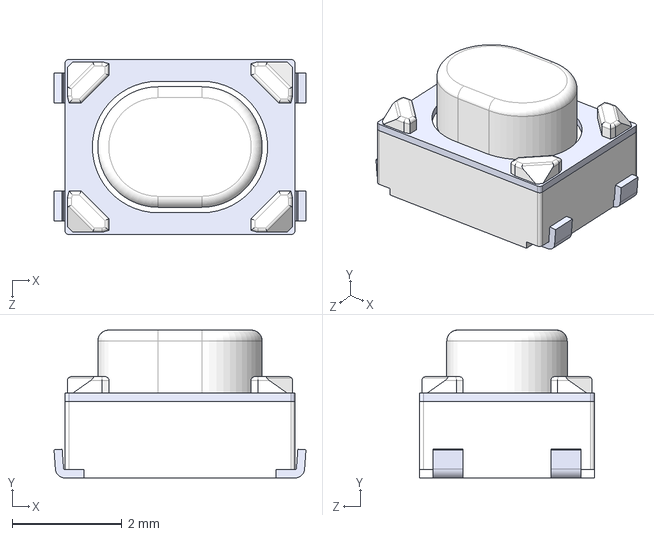
[picture p76: CAD file, 2026-01-03]
3dmodels/PTS815 SJG 250 SMTR LFS.STEP
4.60 x 2.70 x 3.20 mm
