Kageni-wq/kicad/3dmodels/c402.step

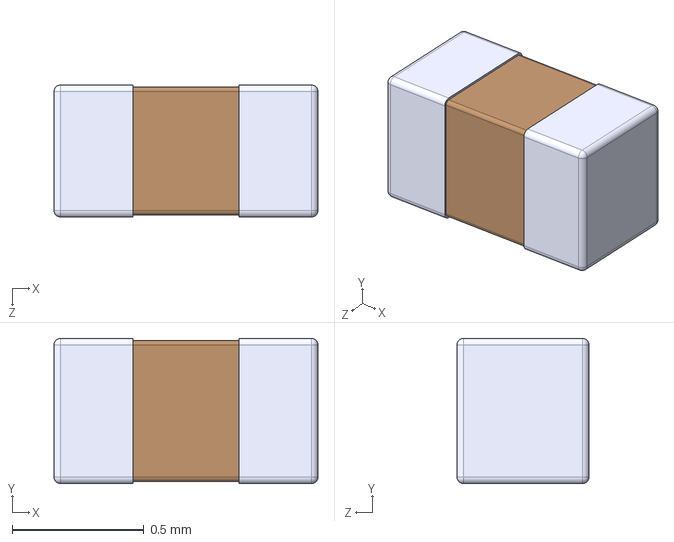
[picture p77: CAD file, 2026-01-03]
3dmodels/c402.step
1.00 x 0.55 x 0.5 mm
