Kageni-wq/kicad/3dmodels/r402.step

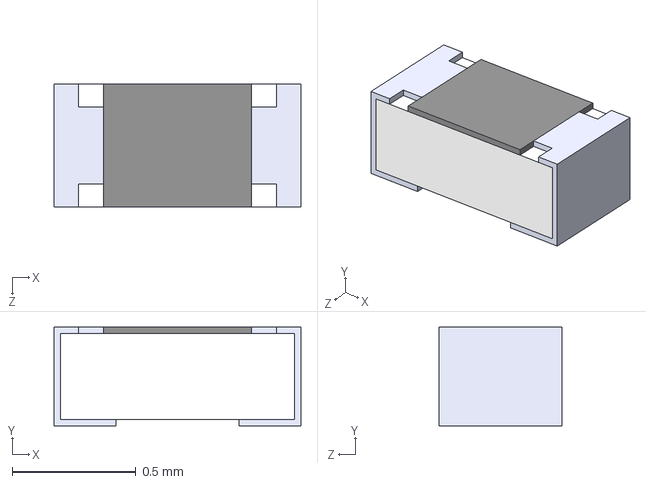
[picture p78: CAD file, 2026-01-03]
3dmodels/r402.step
1.00 x 0.4 x 0.5 mm
