Kageni-wq/kicad/3dmodels/CYBT-413061-02.stp

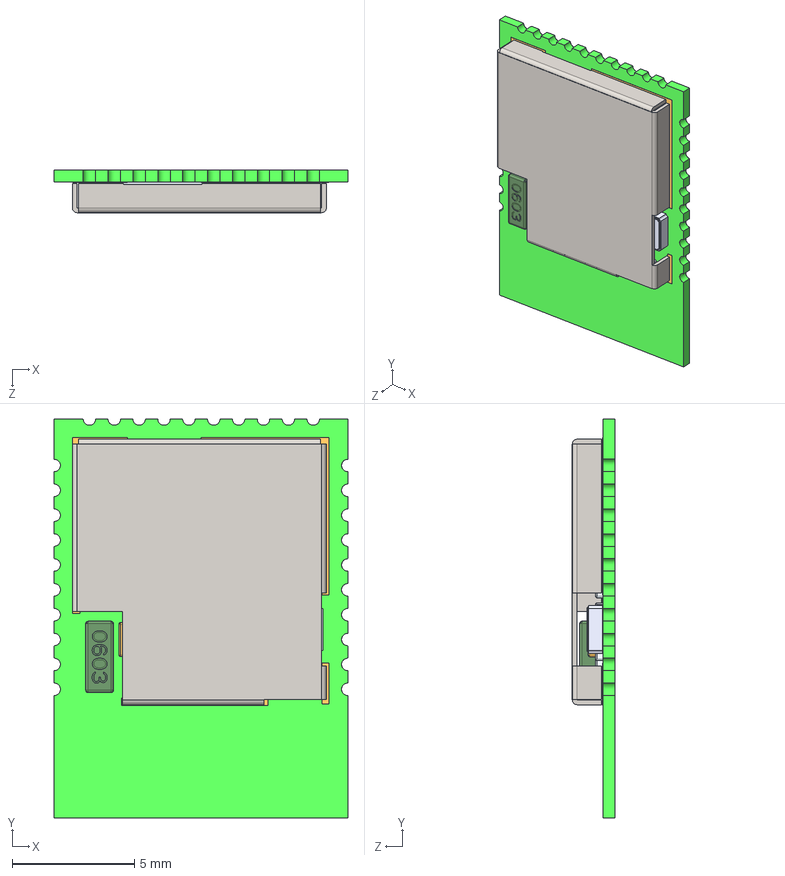
[picture p79: CAD file, 2025-12-29]
3dmodels/CYBT-413061-02.stp
12.0 x 16.3 x 1.77 mm
600-20117-01REV1
QFN_40
L0603
TP26X34 x 30
CAPC1005_IS0402Q x 3
XTALS4_2M0X1M6
413034_SHIELD-PAD
413034_SHIELD_COVER
