Kageni-wq/kicad/3dmodels/FH34SRJ-8S-0.5SH_50_.step

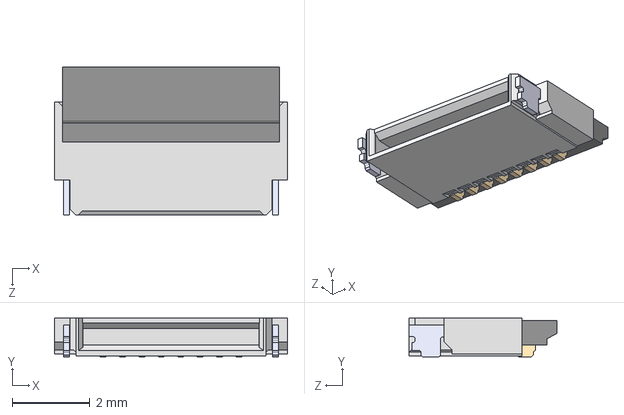
[picture p80: CAD file, 2025-12-19]
3dmodels/FH34SRJ-8S-0.5SH_50_.step
6.00 x 1.00 x 3.80 mm
