Kageni-wq/kicad/3dmodels/MIMXRT1062DVJ6B.step

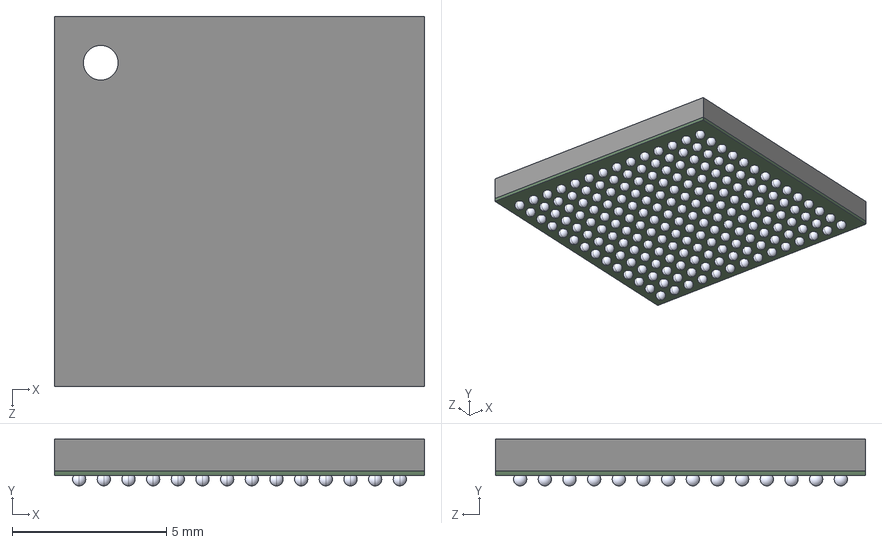
[picture p81: CAD file, 2025-12-05]
3dmodels/MIMXRT1062DVJ6B.step
12.0 x 1.52 x 12.0 mm
