Kageni-wq/kicad/3dmodels/MIMXRT1062CVJ5BR.step

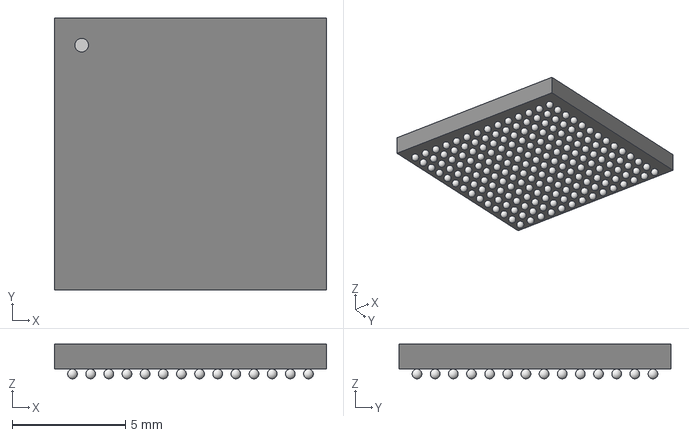
[picture p83: CAD file, 2025-10-19]
3dmodels/MIMXRT1062CVJ5BR.step
12.0 x 12.0 x 1.53 mm
