Kageni-wq/kicad/3dmodels/ISP2053-AX-RS.STEP

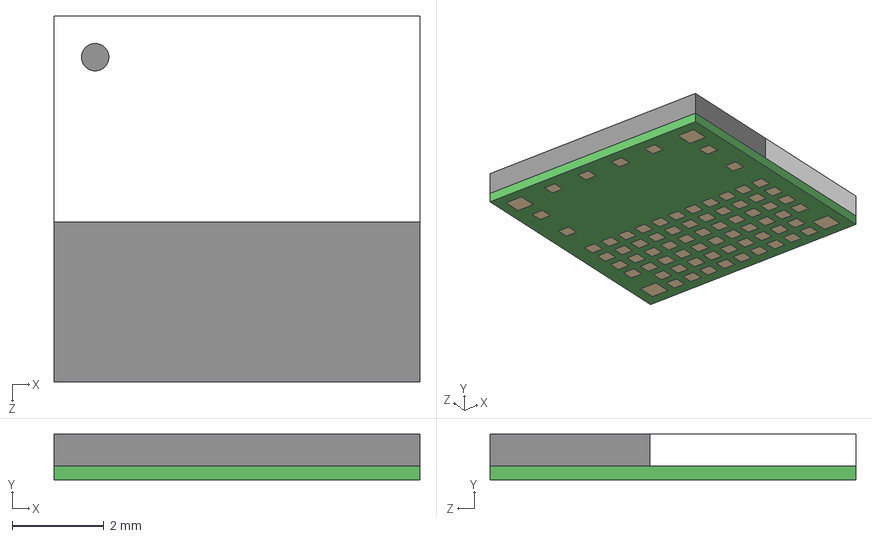
[picture p84: CAD file, 2025-10-18]
3dmodels/ISP2053-AX-RS.STEP
8.00 x 1 x 8.00 mm
