Kageni-wq/kicad/3dmodels/HFW4R-1STE1H1LF.step

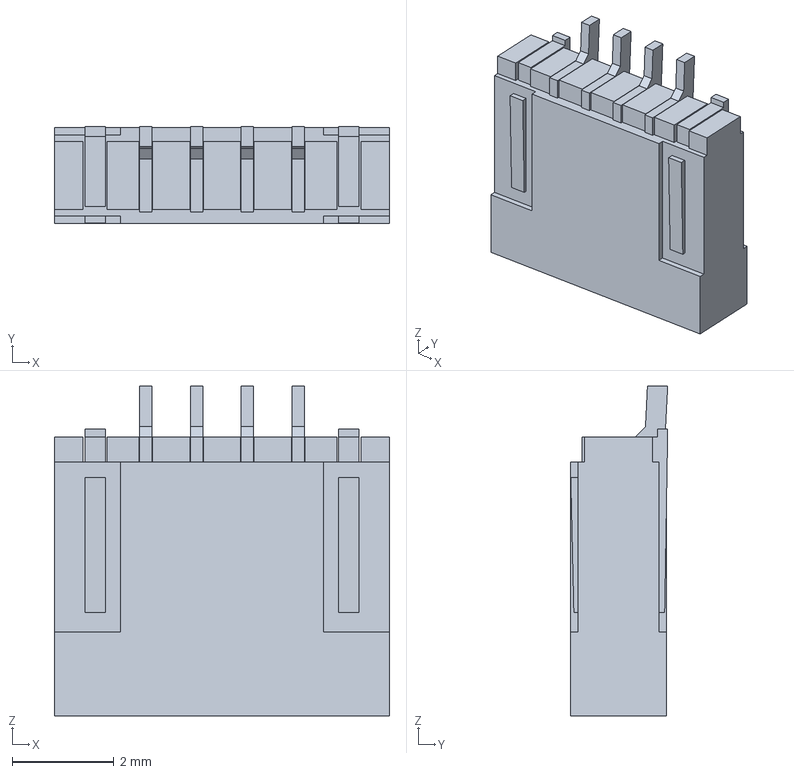
[picture p85: CAD file, 2025-10-13]
3dmodels/HFW4R-1STE1H1LF.step
6.60 x 1.92 x 6.50 mm
