Kageni-wq/kicad/3dmodels/ANT-2.4-MSA-TH1.step

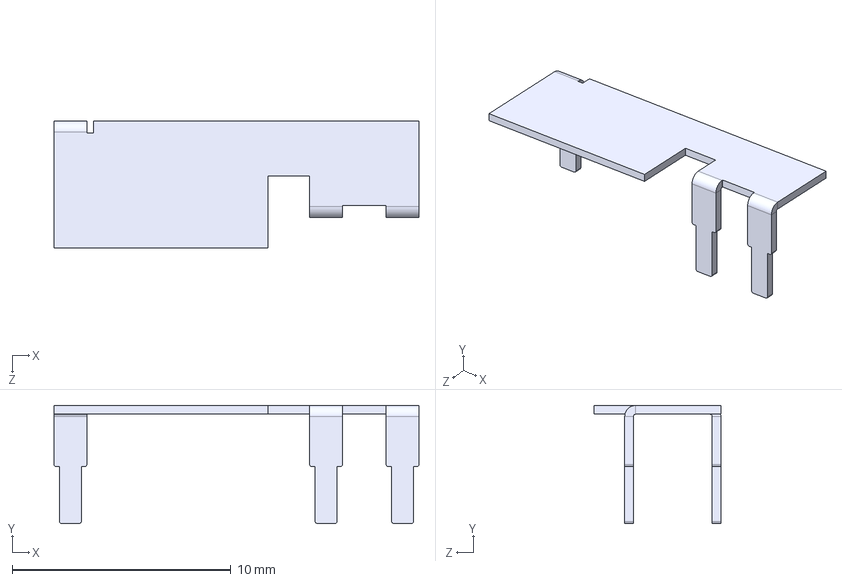
[picture p86: CAD file, 2025-10-13]
3dmodels/ANT-2.4-MSA-TH1.step
16.7 x 5.40 x 5.80 mm
