Kageni-wq/kicad/3dmodels/MIC5528-3.3YMT-TR.step

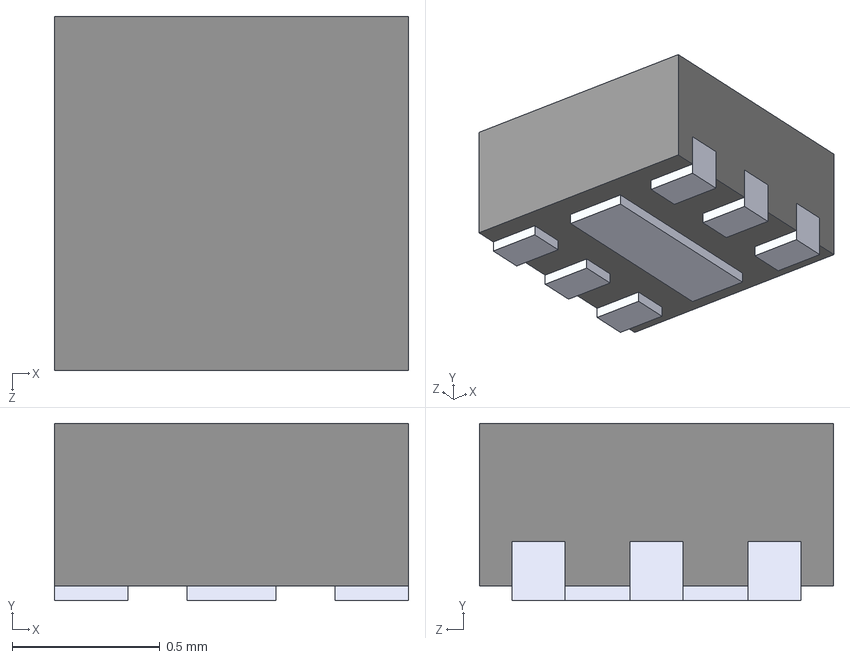
[picture p87: CAD file, 2025-10-13]
3dmodels/MIC5528-3.3YMT-TR.step
1.20 x 0.6 x 1.20 mm
