Kageni-wq/kicad/3dmodels/ESP32-U4WDH.step

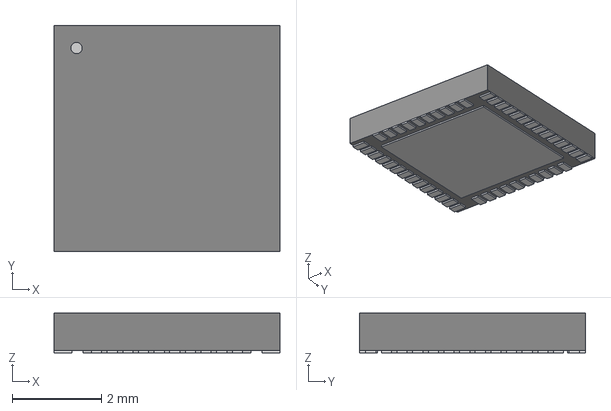
[picture p88: CAD file, 2025-10-13]
3dmodels/ESP32-U4WDH.step
5.05 x 5.05 x 0.892 mm
