Kageni-wq/kicad/3dmodels/RV-8263-C7-32.768KHZ-20PPM-TA-QC.step

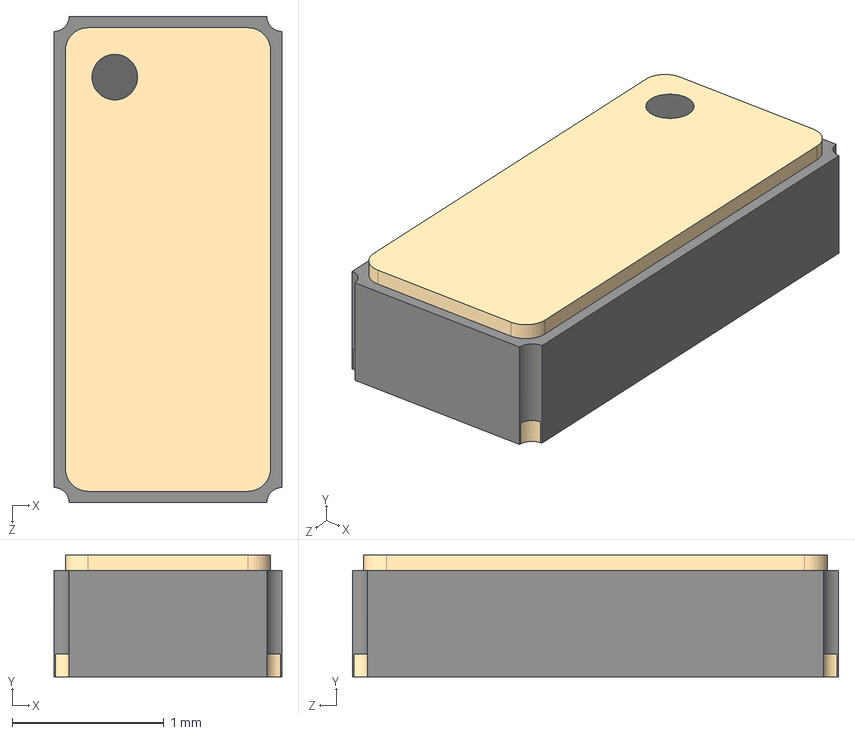
[picture p89: CAD file, 2025-10-13]
3dmodels/RV-8263-C7-32.768KHZ-20PPM-TA-QC.step
1.50 x 0.8 x 3.20 mm
