Kageni-wq/kicad/3dmodels/CX2016DB40000D0FLJCC.step

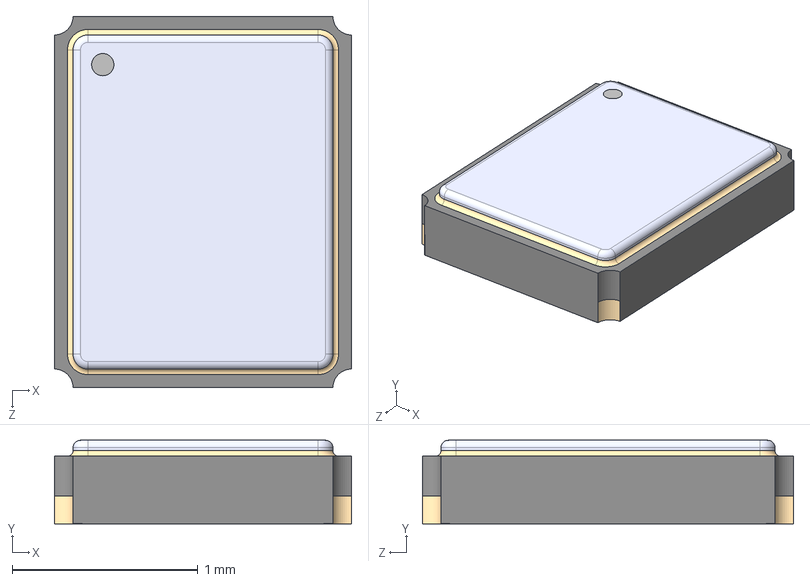
[picture p90: CAD file, 2025-10-13]
3dmodels/CX2016DB40000D0FLJCC.step
1.60 x 0.45 x 2.00 mm
