Kageni-wq/kicad/3dmodels/FH34SRJ-7S-0.5SH_50_.step

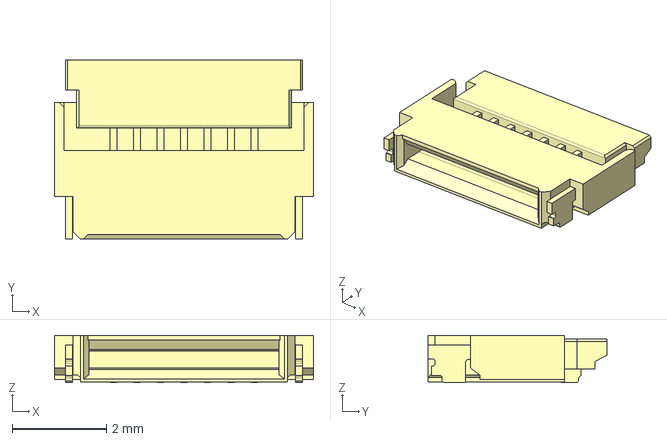
[picture p91: CAD file, 2025-10-13]
3dmodels/FH34SRJ-7S-0.5SH_50_.step
5.50 x 3.80 x 1.00 mm
