Kageni-wq/kicad/3dmodels/OPA334AIDBVR.step

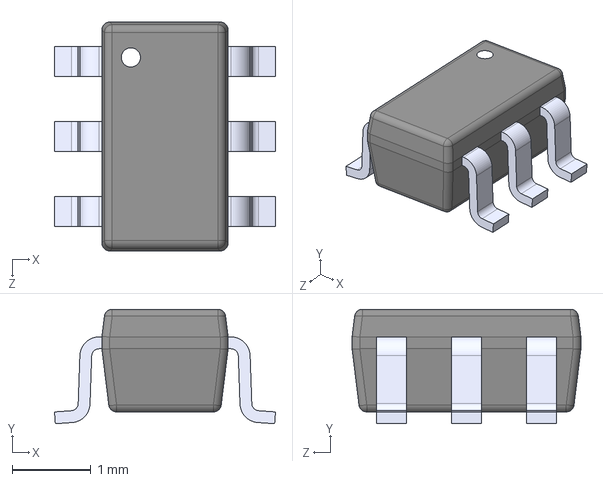
[picture p92: CAD file, 2025-10-13]
3dmodels/OPA334AIDBVR.step
2.80 x 1.45 x 2.90 mm
