Kageni-wq/kicad/3dmodels/ER-OLED015-1C Curled.step

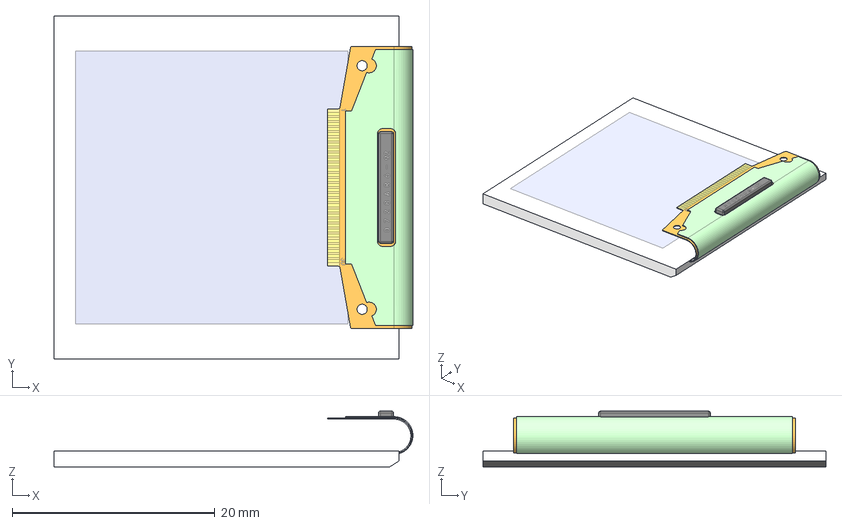
[picture p93: CAD file, 2025-08-14]
3dmodels/ER-OLED015-1C Curled.step
35.4 x 33.8 x 5.52 mm
ER-OLED015-1C
ER-OLED015-1C (1)
ER-OLED015-1C (2)
