Kageni-wq/kicad/3dmodels/CLP-112-02-S-D-A-K-TR.stp

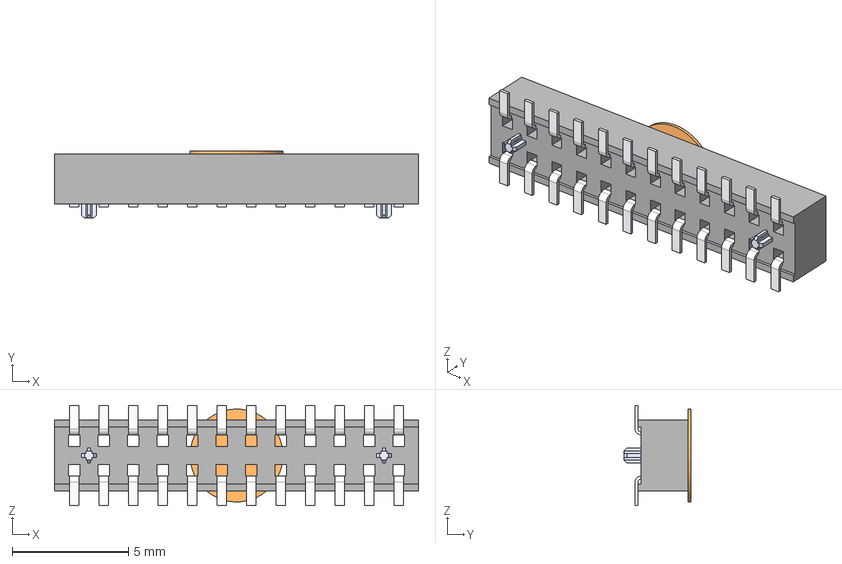
[picture p94: CAD file, 2025-08-14]
3dmodels/CLP-112-02-S-D-A-K-TR.stp
15.7 x 2.90 x 4.32 mm
CLP-112-2-F-D-A-K-TRTRM
C-106-22-1-S-12_Pin x 2
CLP_ap x 2
K-DOT-.157-.250-.005_pfp
