Kageni-wq/kicad/3dmodels/BG300-05-A-L-A.step

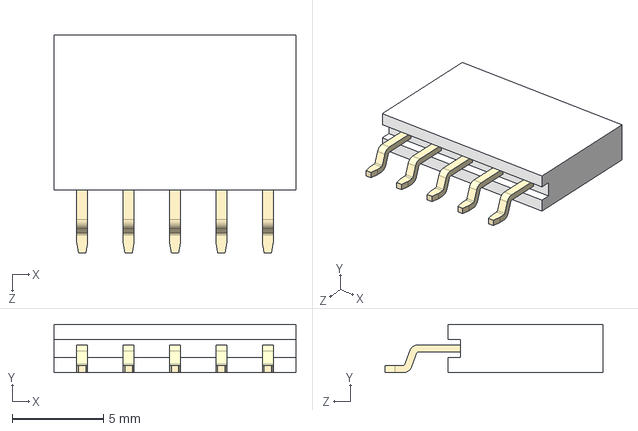
[picture p95: CAD file, 2025-08-14]
3dmodels/BG300-05-A-L-A.step
13.2 x 2.65 x 12.0 mm
body^BG301-xxx
pin^BG301-xxx x 5
