Kageni-wq/kicad/3dmodels/ESP32-PICO-MINI-02.step

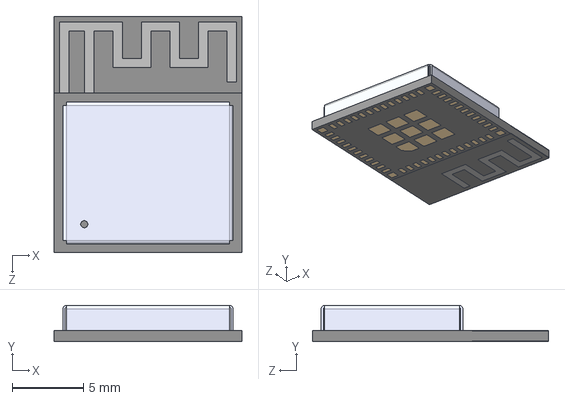
[picture p96: CAD file, 2025-08-14]
3dmodels/ESP32-PICO-MINI-02.step
13.2 x 2.55 x 16.6 mm
