Kageni-wq/kicad/3dmodels/FTS-111-01-L-DV.stp

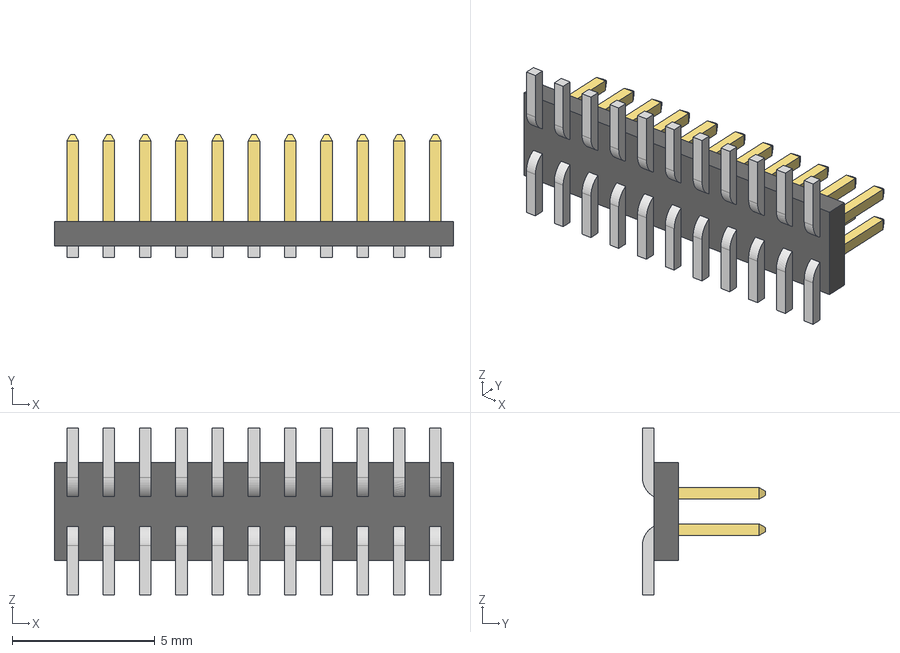
[picture p97: CAD file, 2025-08-14]
3dmodels/FTS-111-01-L-DV.stp
14.0 x 4.32 x 5.84 mm
FTS-111-01-L-DV_body
FTS-111-01-L-DV_pins1
FTS-111-01-L-DV_pins2
