Kageni-wq/kicad/3dmodels/STC3115AIJT.step

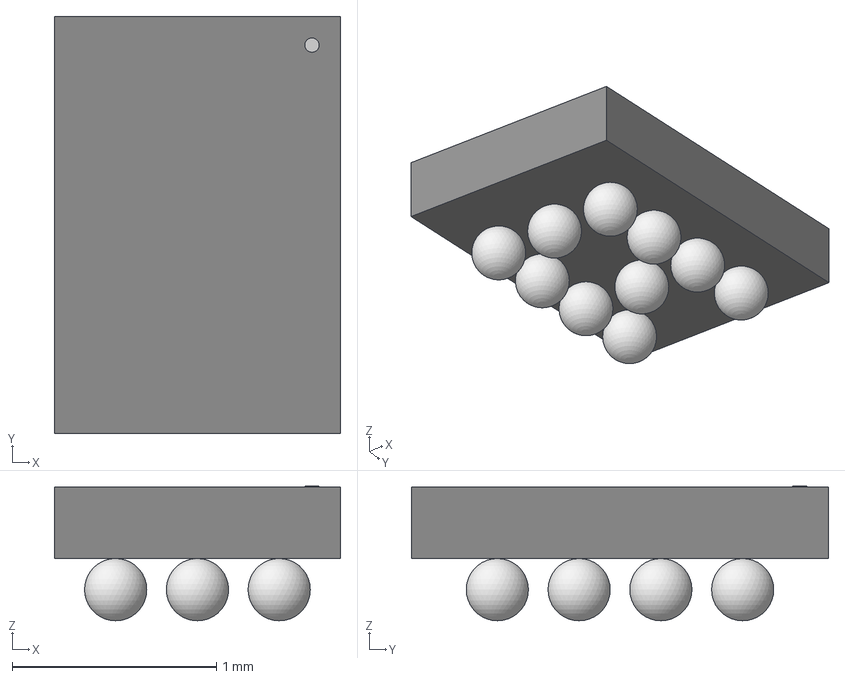
[picture p98: CAD file, 2025-08-14]
3dmodels/STC3115AIJT.step
1.40 x 2.04 x 0.658 mm
