Kageni-wq/kicad/3dmodels/TF13BSA-20S-0.4SH_800_.step

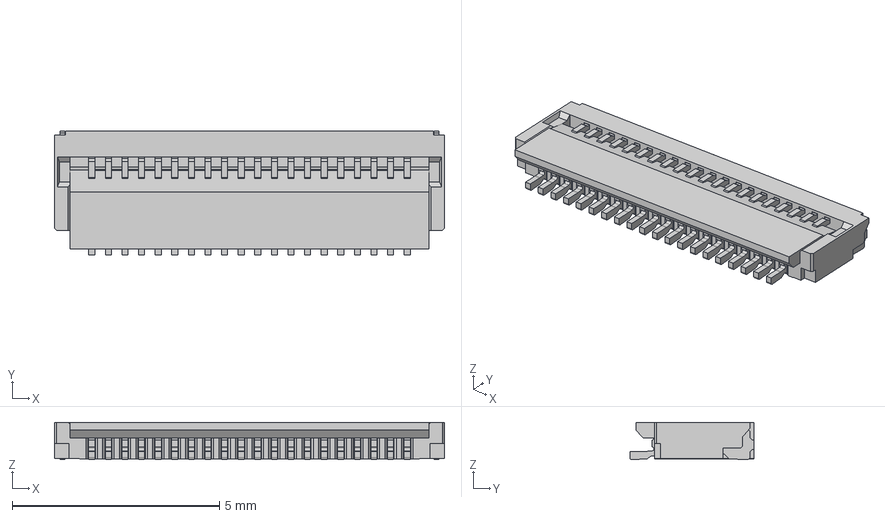
[picture p99: CAD file, 2025-08-14]
3dmodels/TF13BSA-20S-0.4SH_800_.step
9.40 x 3.00 x 0.9 mm
