Kageni-wq/kicad/3dmodels/ER-OLED015-1C v1.step

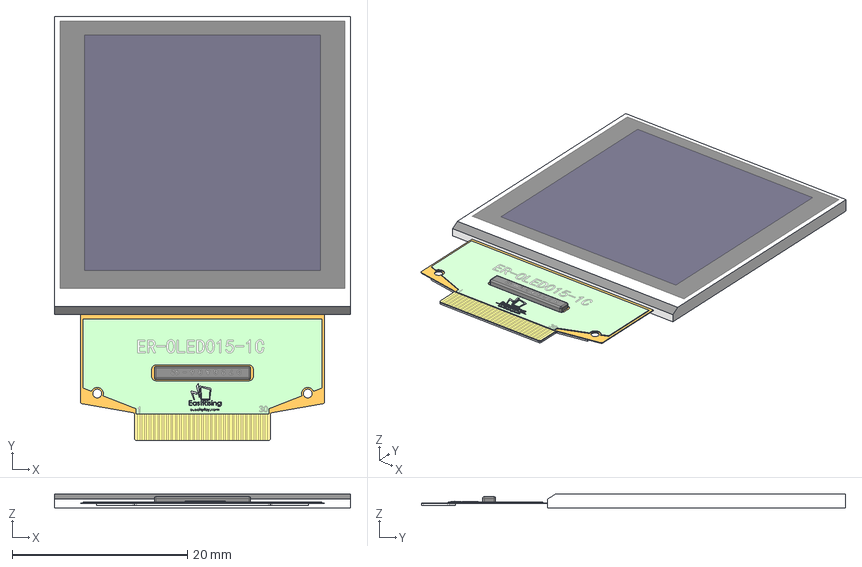
[picture p101: CAD file, 2025-08-14]
3dmodels/ER-OLED015-1C v1.step
33.8 x 48.4 x 1.60 mm
ER-OLED015-1C_1
ER-OLED015-1C (1)
ER-OLED015-1C (2)
ER-OLED015-1C (3)
2no_5logo
2no_5logo (1)
2no_5logo (2)
2no_5logo (3)
2no_5logo (4)
2no_5logo (5)
2no_5logo (6)
2no_5logo (7)
2no_5logo (8)
2no_5logo (9)
2no_5logo (10)
2no_5logo (11)
2no_5logo (12)
2no_5logo (13)
2no_5logo (14)
2no_5logo (15)
2no_5logo (16)
2no_5logo (17)
2no_5logo (18)
2no_5logo (19)
2no_5logo (20)
2no_5logo (21)
2no_5logo (22)
2no_5logo (23)
2no_5logo (24)
2no_5logo (25)
2no_5logo (26)
2no_5logo (27)
2no_5logo (28)
2no_5logo (29)
2no_5logo (30)
