Kageni-wq/kicad/3dmodels/STM32H725REV6.step

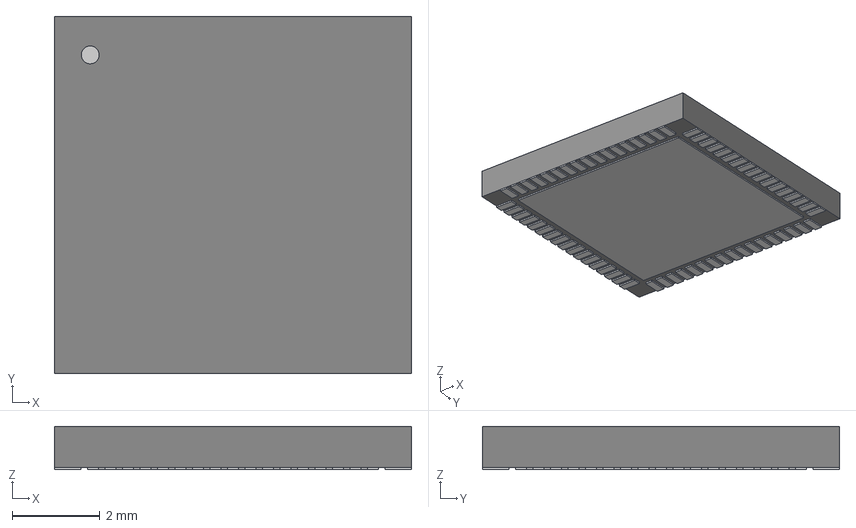
[picture p102: CAD file, 2025-08-14]
3dmodels/STM32H725REV6.step
8.15 x 8.15 x 0.993 mm
