Kageni-wq/kicad/3dmodels/CX90MW8-16P1.step

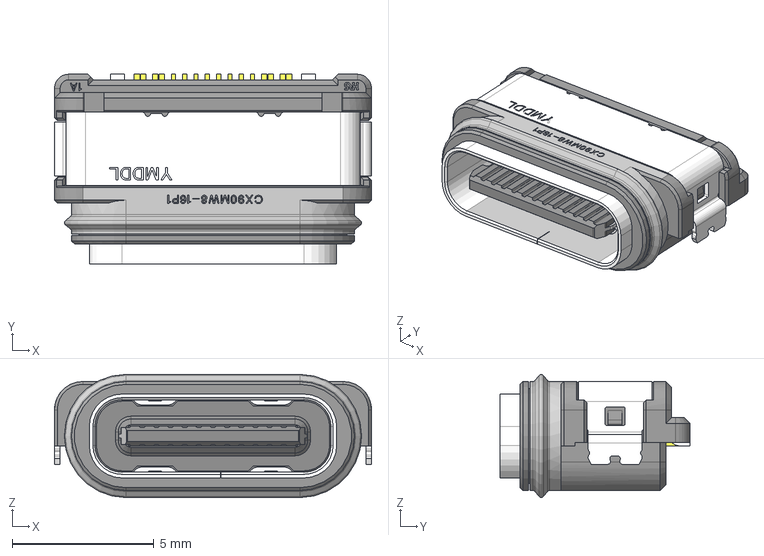
[picture p103: CAD file, 2025-08-14]
3dmodels/CX90MW8-16P1.step
11.2 x 6.70 x 4.35 mm
