Kageni-wq/kicad/3dmodels/USB4730-GF-A_REVA.step

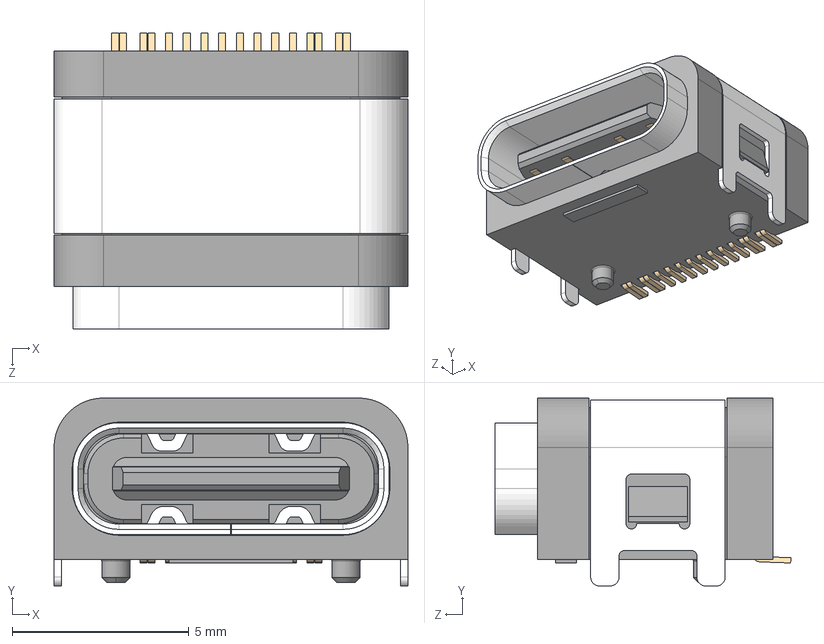
[picture p104: CAD file, 2025-08-14]
3dmodels/USB4730-GF-A_REVA.step
10.0 x 5.31 x 8.36 mm
