Kageni-wq/kicad/3dmodels/HMC197BE.step

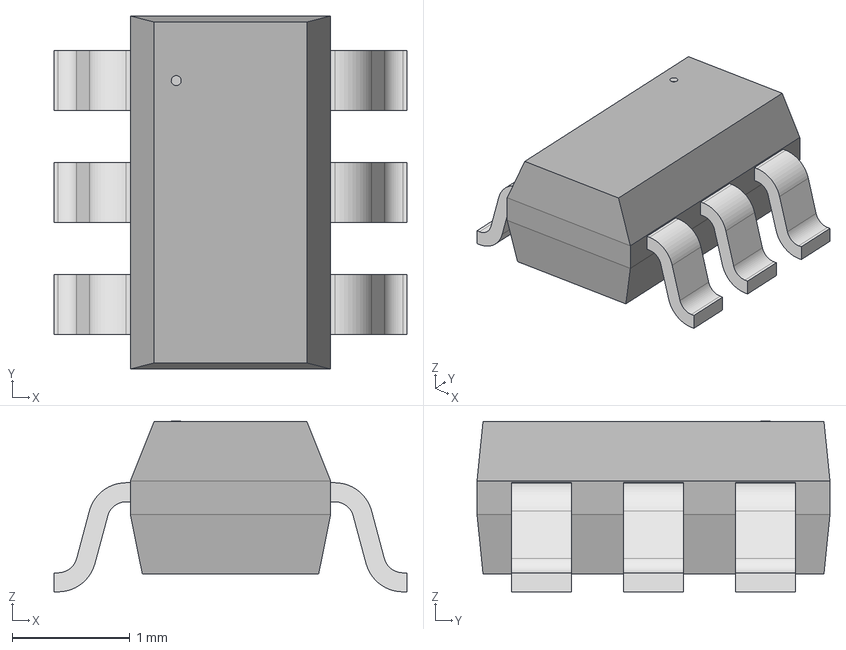
[picture p105: CAD file, 2025-08-14]
3dmodels/HMC197BE.step
3.00 x 3.00 x 1.45 mm
