Kageni-wq/kicad/3dmodels/TL6340AF160Q.step

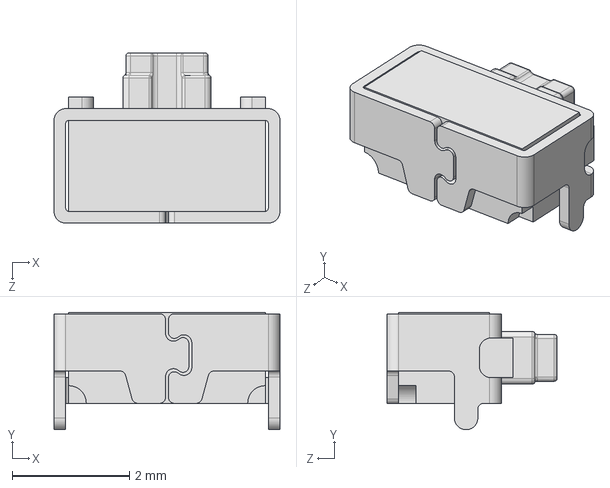
[picture p106: CAD file, 2025-08-14]
3dmodels/TL6340AF160Q.step
3.85 x 2.00 x 2.90 mm
