Kageni-wq/kicad/3dmodels/FH34SRJ-20S-0.5SH_50_.step

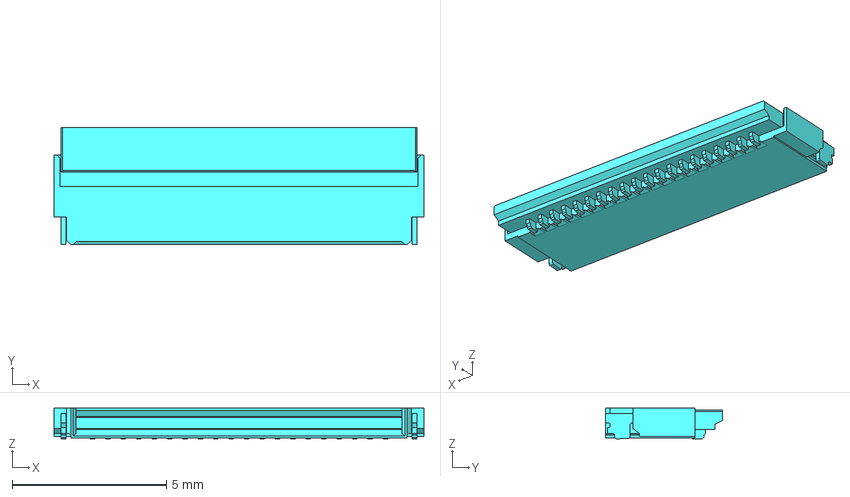
[picture p107: CAD file, 2025-08-14]
3dmodels/FH34SRJ-20S-0.5SH_50_.step
12.0 x 3.80 x 1.00 mm
