Kageni-wq/kicad/3dmodels/SOD523_DIO.step

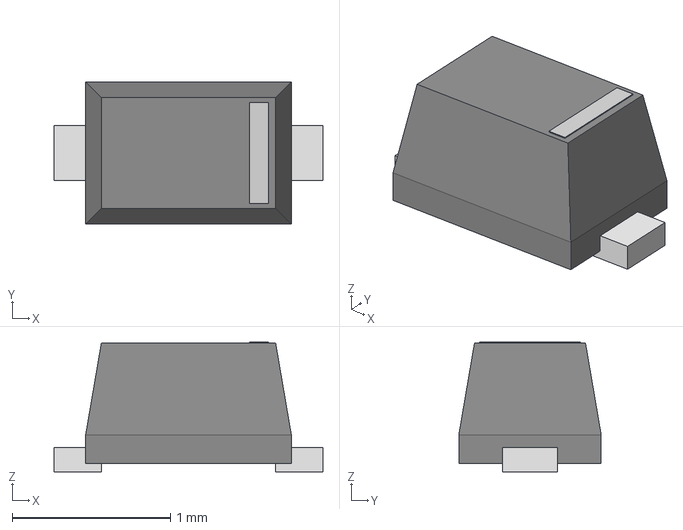
[picture p108: CAD file, 2025-08-14]
3dmodels/SOD523_DIO.step
1.70 x 0.9 x 0.819 mm
