Kageni-wq/kicad/3dmodels/CLP-104-02-F-D-BE-TR.stp

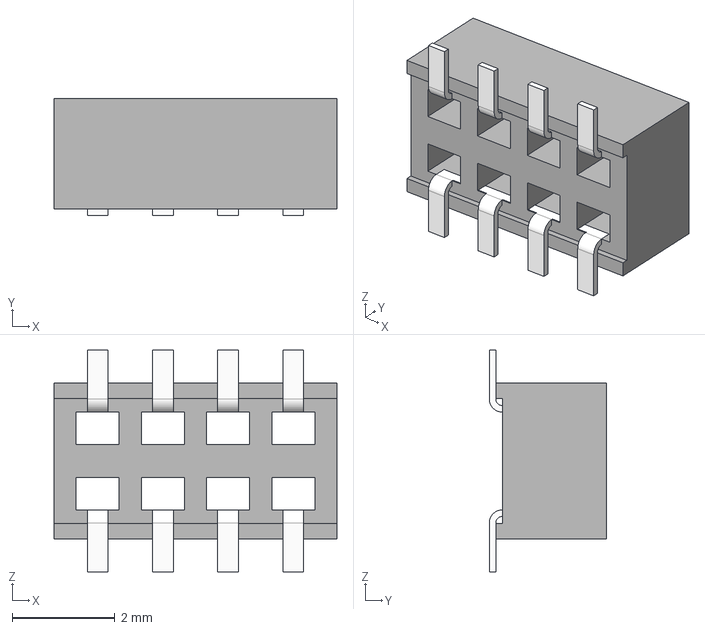
[picture p109: CAD file, 2025-08-14]
3dmodels/CLP-104-02-F-D-BE-TR.stp
5.51 x 2.29 x 4.32 mm
CLP-104-2-F-D-BE-TRTRM
C-106-22-1-F-04-BE_Pin x 2
