Kageni-wq/kicad/3dmodels/usb4720-03-a.stp

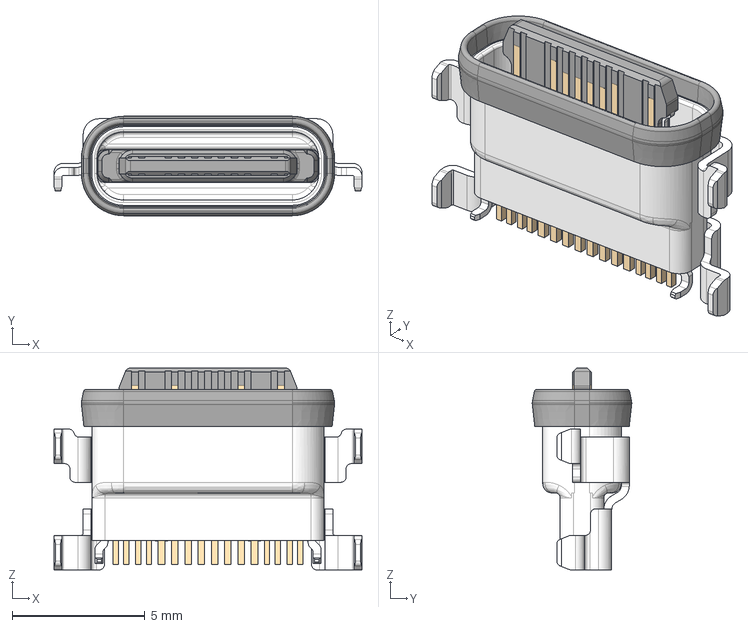
[picture p110: CAD file, 2025-08-14]
3dmodels/usb4720-03-a.stp
11.6 x 3.75 x 7.60 mm
