Kageni-wq/kicad/3dmodels/JS1300AQ.step

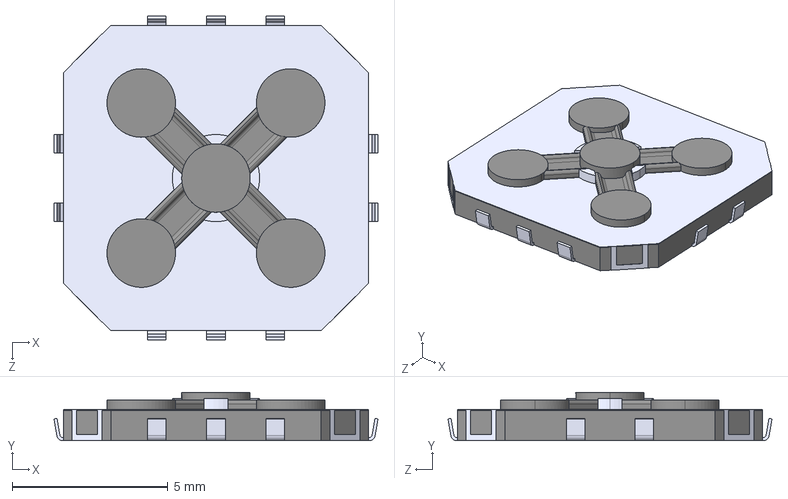
[picture p112: CAD file, 2025-08-14]
3dmodels/JS1300AQ.step
10.4 x 1.56 x 10.4 mm
