Kageni-wq/kicad/3dmodels/F3311A7H121030E200.step

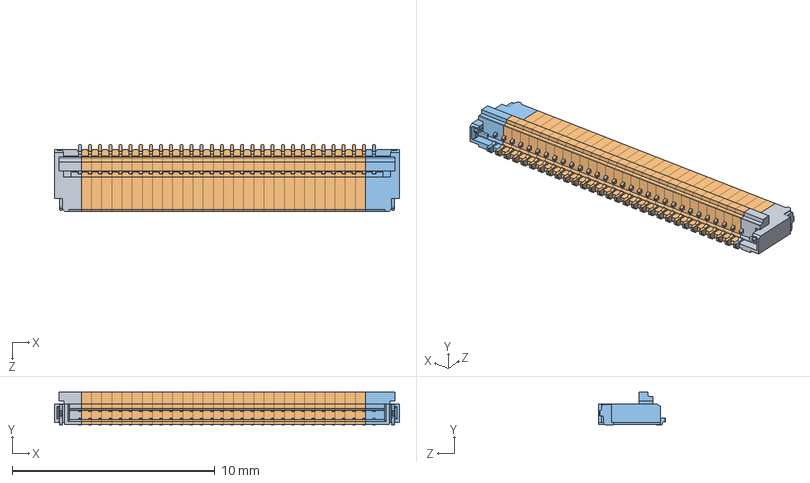
[picture p113: CAD file, 2025-08-14]
3dmodels/F3311A7H121030E200.step
17.0 x 1.62 x 3.30 mm
F331_L^F3311A7H121030E200--3DModel-STEP-533217(2)_F3311A7H121030E200
F331_M^F3311A7H121030E200--3DModel-STEP-533217(2)_F3311A7H121030E200 x 28
F331_R^F3311A7H121030E200--3DModel-STEP-533217(2)_F3311A7H121030E200
