Kageni-wq/kicad/3dmodels/EXB-28V510JX.step

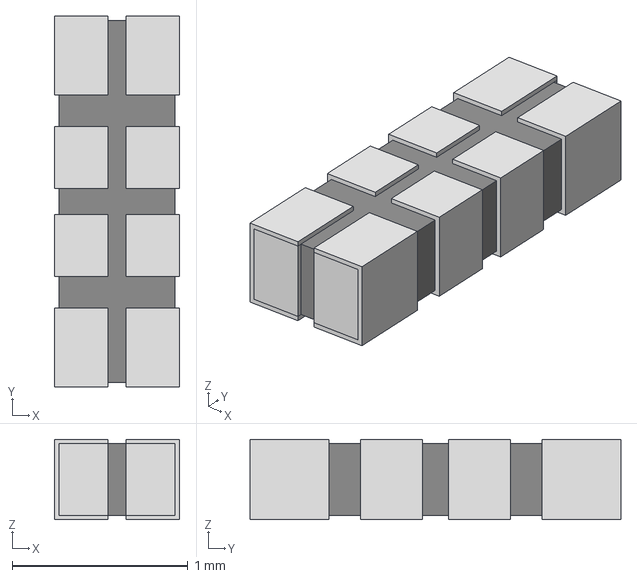
[picture p114: CAD file, 2025-08-14]
3dmodels/EXB-28V510JX.step
0.712 x 2.11 x 0.457 mm
