Kageni-wq/kicad/3dmodels/skrmaae010.stp

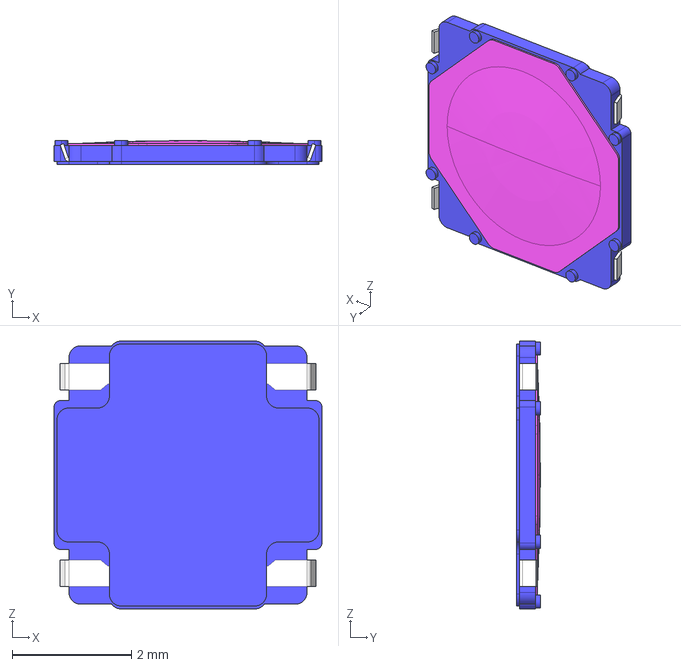
[picture p115: CAD file, 2025-08-14]
3dmodels/skrmaae010.stp
4.50 x 0.4 x 4.50 mm
