Kageni-wq/kicad/3dmodels/BM24-20DS2-0.35V(53).STEP

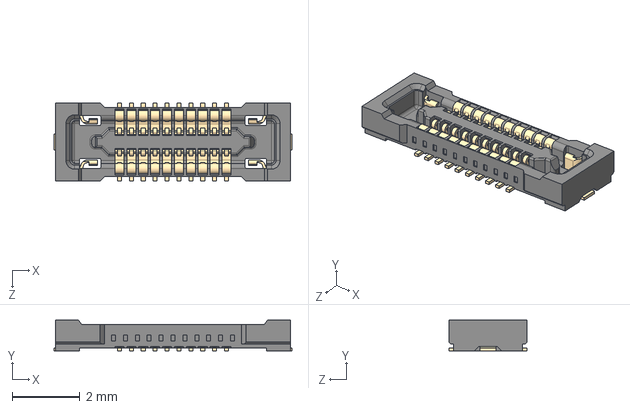
[picture p116: CAD file, 2025-08-14]
3dmodels/BM24-20DS2-0.35V(53).STEP
7.00 x 0.9 x 2.30 mm
