Kageni-wq/kicad/3dmodels/SR4L002.step

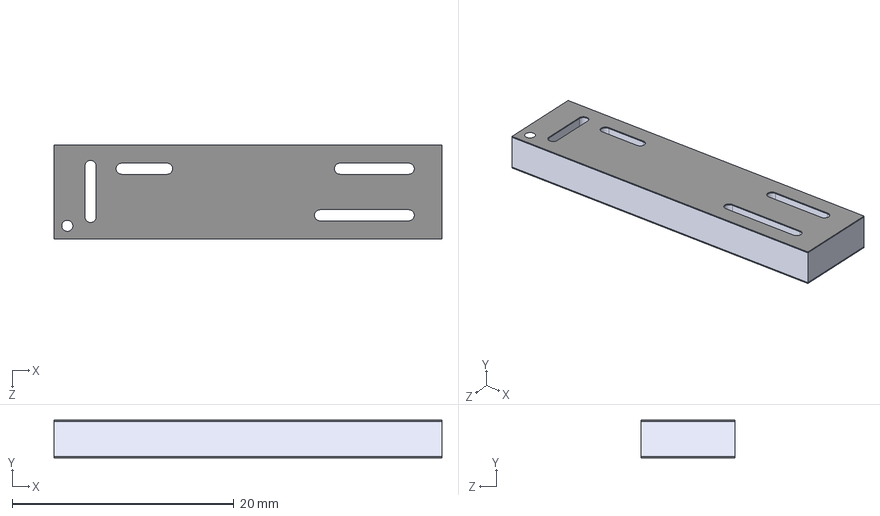
[picture p117: CAD file, 2025-08-14]
3dmodels/SR4L002.step
35.0 x 3.40 x 8.50 mm
