Kageni-wq/kicad/3dmodels/MLPF-WB-04D3.step

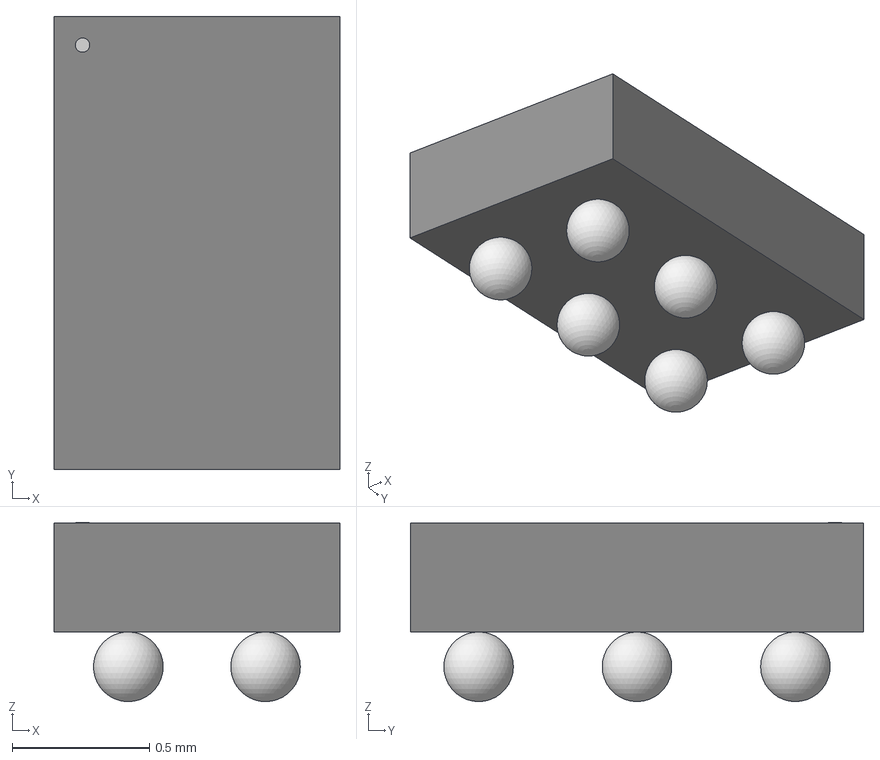
[picture p118: CAD file, 2025-08-14]
3dmodels/MLPF-WB-04D3.step
1.04 x 1.65 x 0.653 mm
