Kageni-wq/kicad/3dmodels/CR0402-FX-1602GLF.step

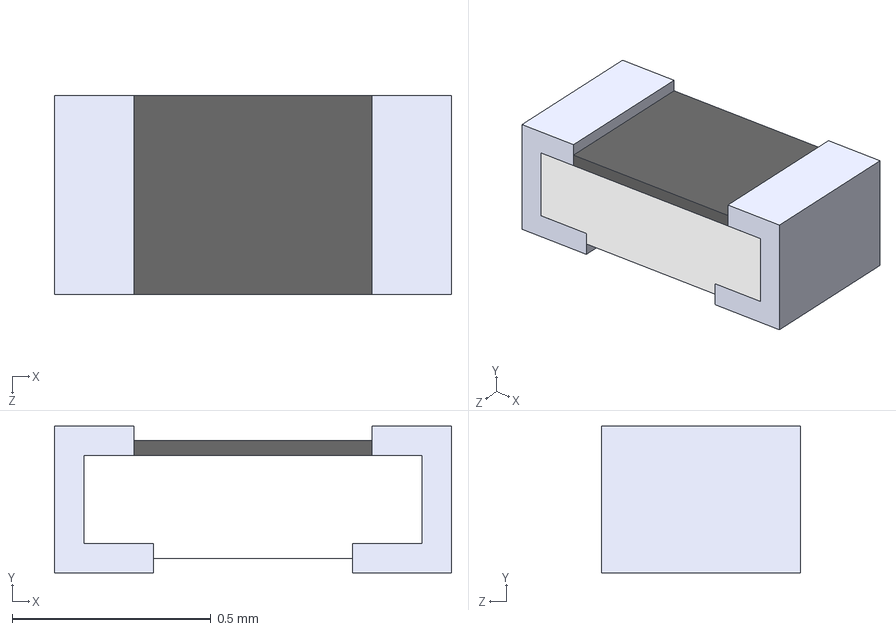
[picture p119: CAD file, 2025-08-14]
3dmodels/CR0402-FX-1602GLF.step
1.00 x 0.37 x 0.5 mm
