Kageni-wq/kicad/3dmodels/SBH11-NBPC-D12-SM-BK.step

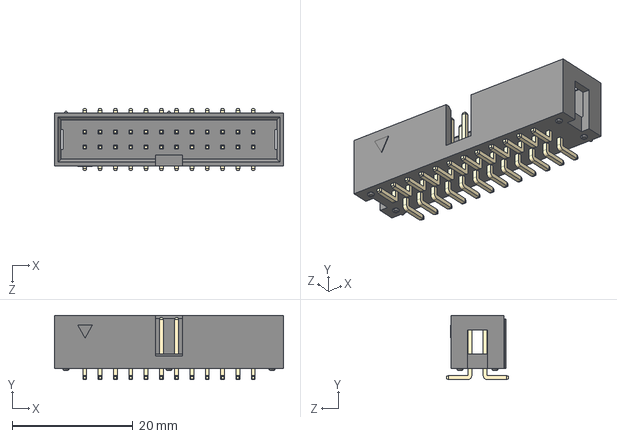
[picture p120: CAD file, 2025-08-14]
3dmodels/SBH11-NBPC-D12-SM-BK.step
38.0 x 10.6 x 10.3 mm
