Kageni-wq/kicad/3dmodels/CLP-108-02-F-D-A.stp

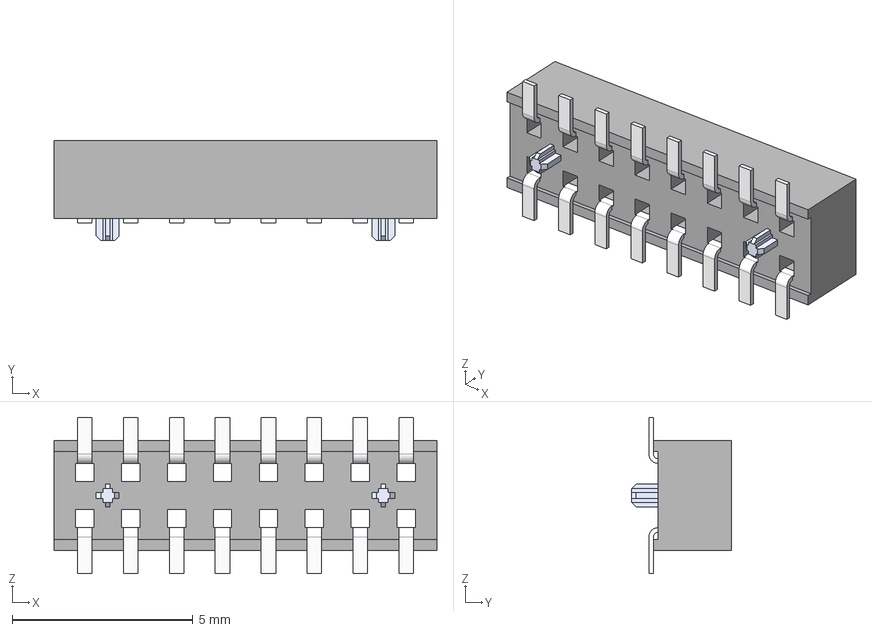
[picture p122: CAD file, 2025-08-14]
3dmodels/CLP-108-02-F-D-A.stp
10.6 x 2.77 x 4.32 mm
CLP-108-2-F-D-ATRM
C-106-22-1-F-08_Pin x 2
CLP_ap x 2
