Kageni-wq/kicad/3dmodels/FFC2B28-24-G.step

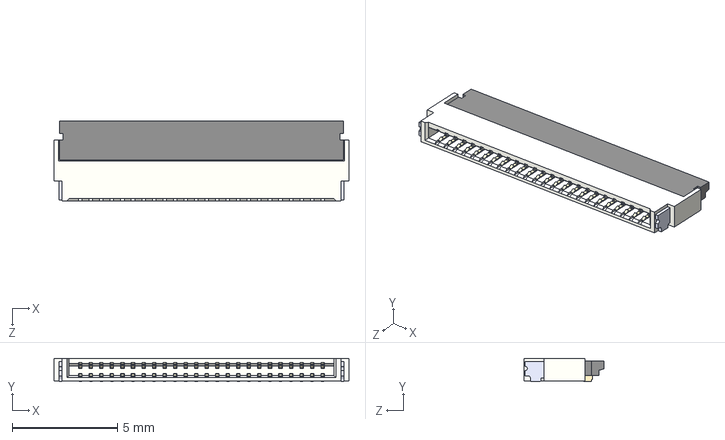
[picture p123: CAD file, 2025-08-14]
3dmodels/FFC2B28-24-G.step
14.0 x 1.10 x 3.80 mm
