Kageni-wq/kicad/3dmodels/TSM-111-01-L-DV.step

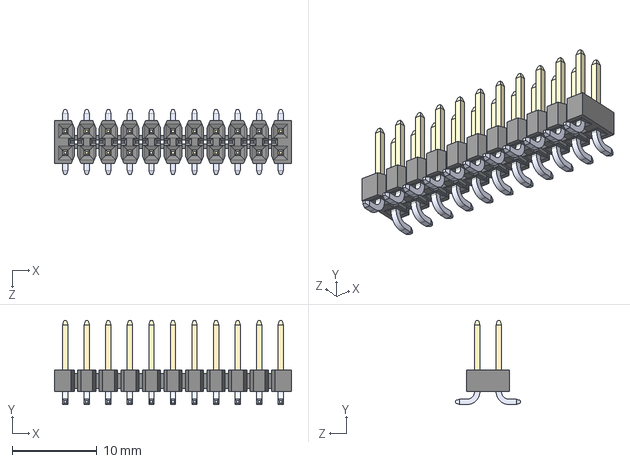
[picture p124: CAD file, 2025-08-14]
3dmodels/TSM-111-01-L-DV.step
27.9 x 9.91 x 7.70 mm
