Kageni-wq/kicad/3dmodels/BF030-12A-B1-0360-0277-0600-LB.STEP

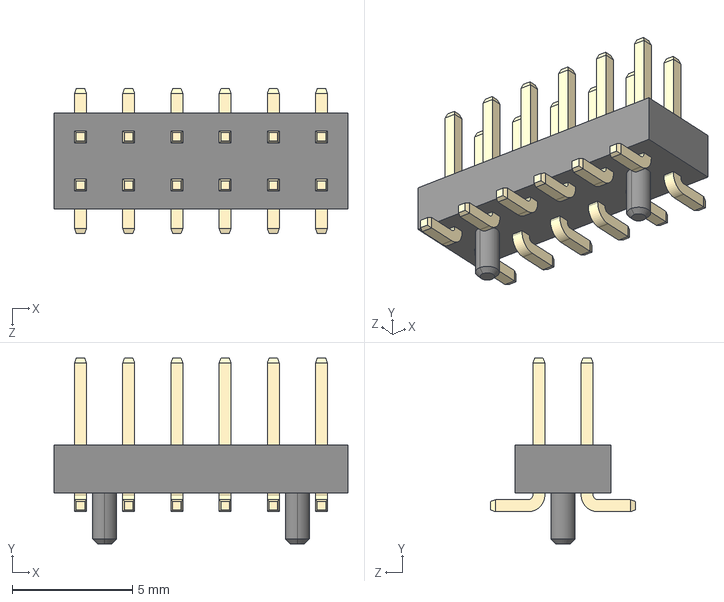
[picture p125: CAD file, 2025-08-14]
3dmodels/BF030-12A-B1-0360-0277-0600-LB.STEP
12.2 x 7.70 x 6.00 mm
body^BF030-xxxx_12
pin^BF030-xxxx x 6
