Kageni-wq/kicad/3dmodels/STM32H753VIH6.step

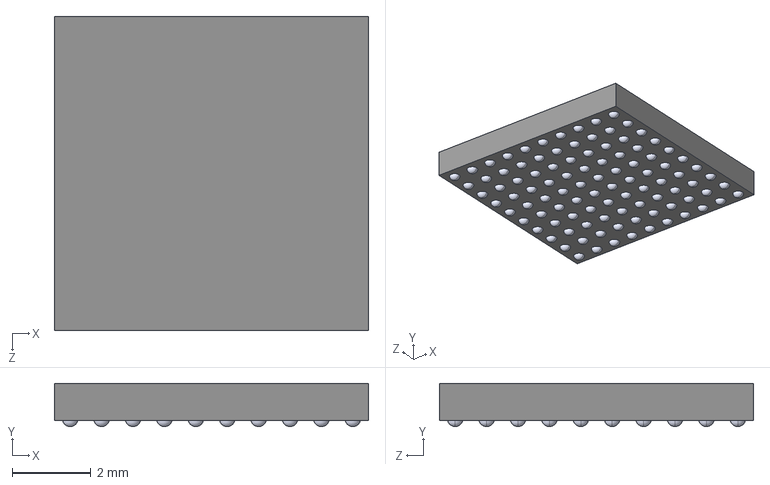
[picture p126: CAD file, 2025-08-14]
3dmodels/STM32H753VIH6.step
8.00 x 1.10 x 8.00 mm
