Kageni-wq/kicad/3dmodels/C201.step

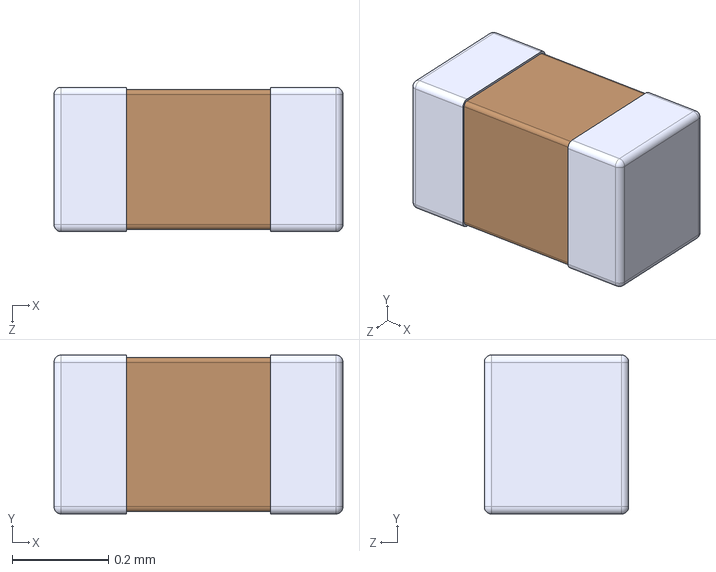
[picture p127: CAD file, 2025-08-14]
3dmodels/C201.step
0.6 x 0.33 x 0.3 mm
