Kageni-wq/kicad/3dmodels/STM32H7R3V8H6.step

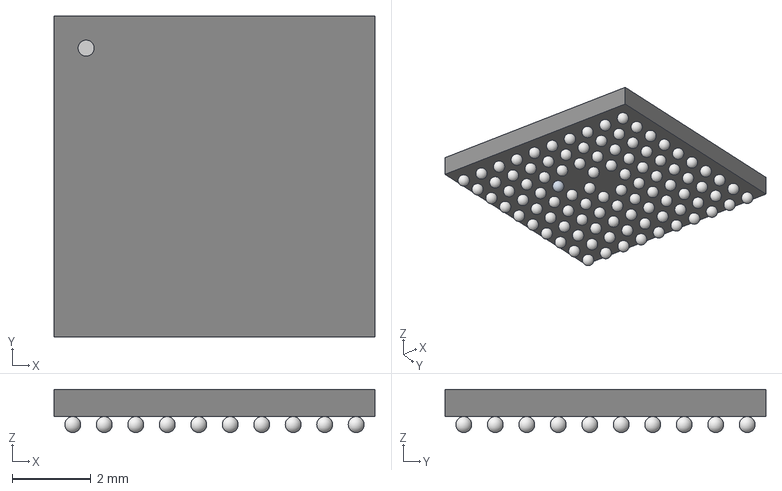
[picture p128: CAD file, 2025-08-14]
3dmodels/STM32H7R3V8H6.step
8.15 x 8.15 x 1.10 mm
