Kageni-wq/kicad/3dmodels/STM32H725VGH6.step

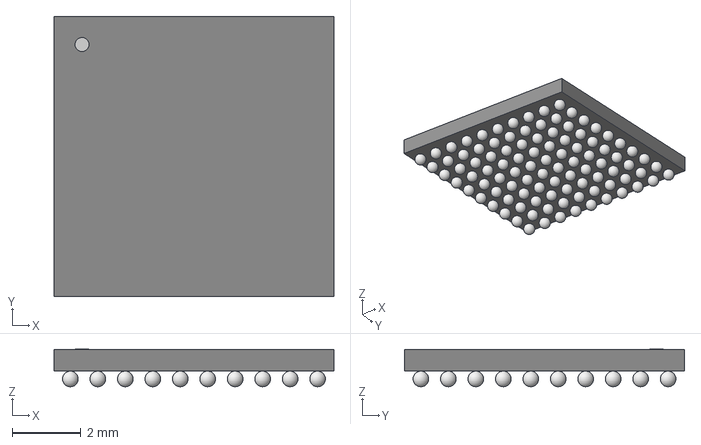
[picture p129: CAD file, 2025-08-14]
3dmodels/STM32H725VGH6.step
8.15 x 8.15 x 1.09 mm
