Kageni-wq/kicad/3dmodels/STC3115IQT.step

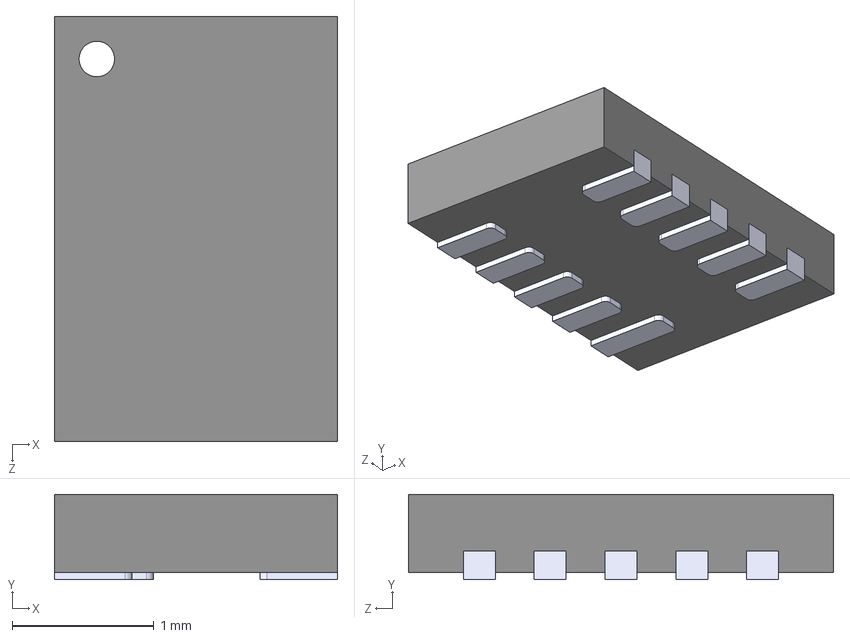
[picture p130: CAD file, 2025-08-14]
3dmodels/STC3115IQT.step
2.00 x 0.6 x 3.00 mm
