Kageni-wq/kicad/3dmodels/NPPN031FGGN_RC.step

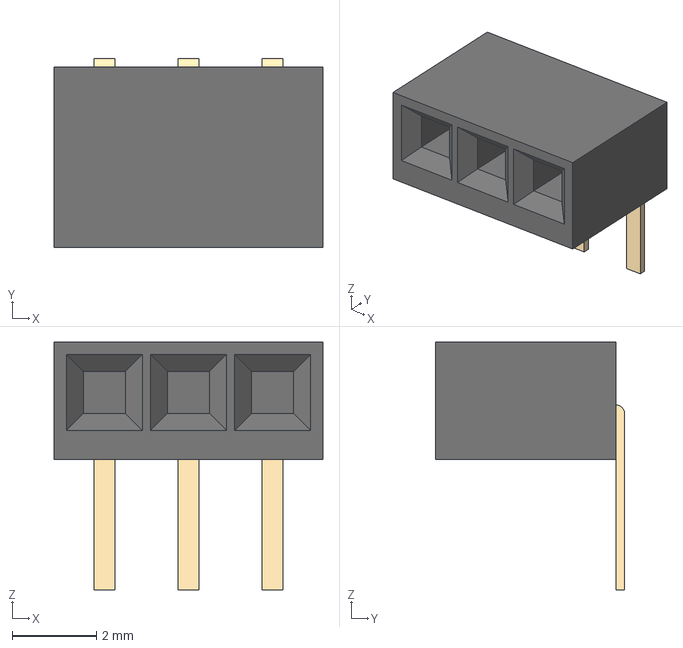
[picture p131: CAD file, 2025-08-14]
3dmodels/NPPN031FGGN_RC.step
6.40 x 4.50 x 5.90 mm
