Kageni-wq/kicad/3dmodels/BM24-20DP2-0.35V(53).stp

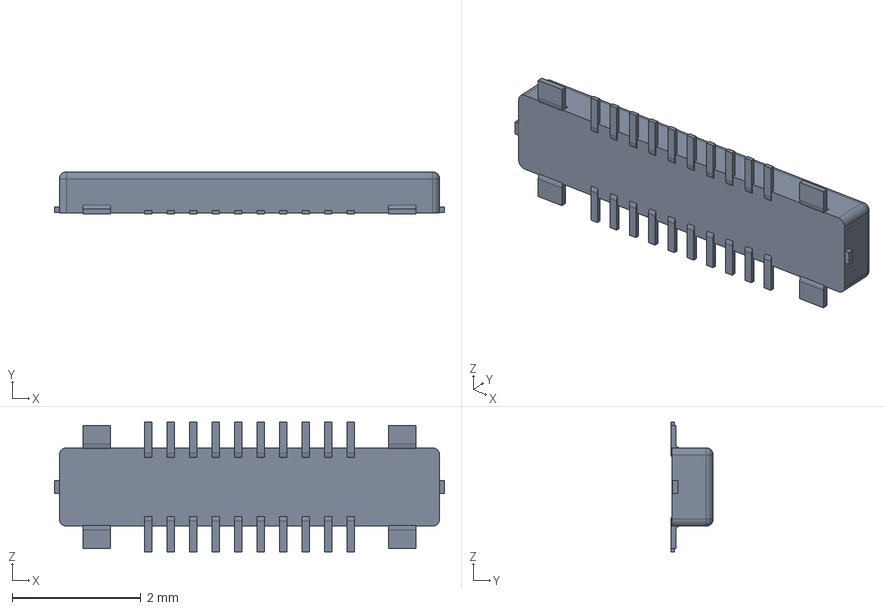
[picture p132: CAD file, 2025-08-14]
3dmodels/BM24-20DP2-0.35V(53).stp
6.07 x 0.66 x 2.02 mm
