Kageni-wq/kicad/3dmodels/MMS-103-01-X-SH.step

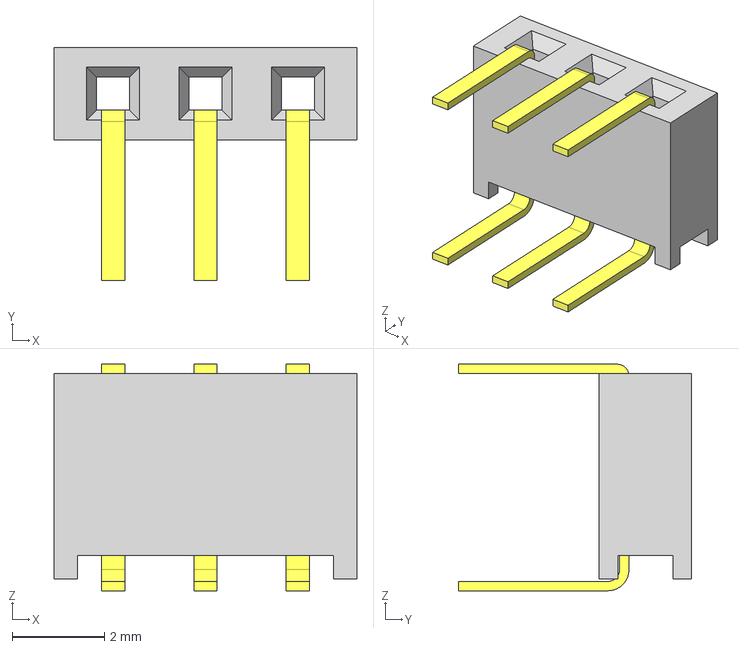
[picture p133: CAD file, 2025-08-14]
3dmodels/MMS-103-01-X-SH.step
6.56 x 5.05 x 4.90 mm
MMS-103-01-SH_socket
C-63-01-03-SH
