Kageni-wq/kicad/3dmodels/TS3USB221RSER.step

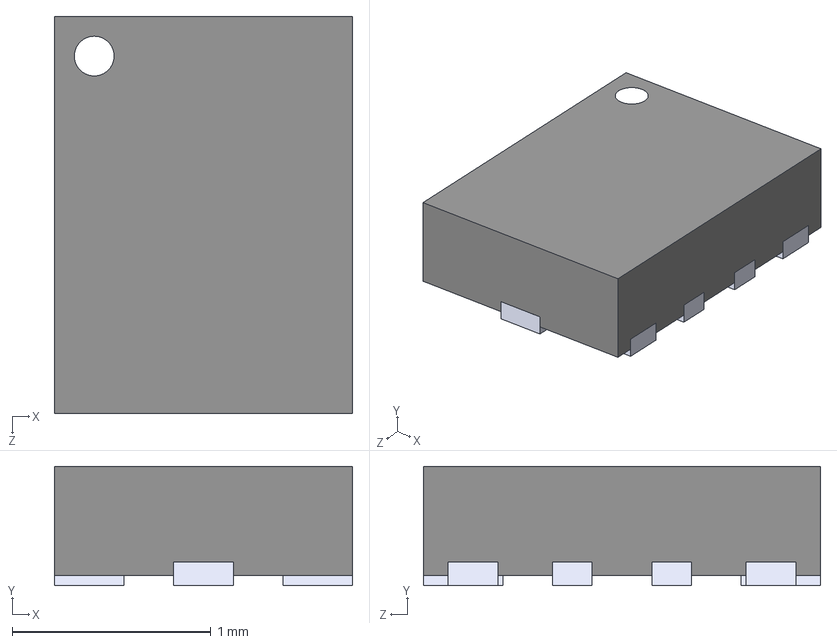
[picture p134: CAD file, 2025-08-14]
3dmodels/TS3USB221RSER.step
1.50 x 0.6 x 2.00 mm
