Kageni-wq/kicad/3dmodels/BF080-12-A-1-L-C.STEP

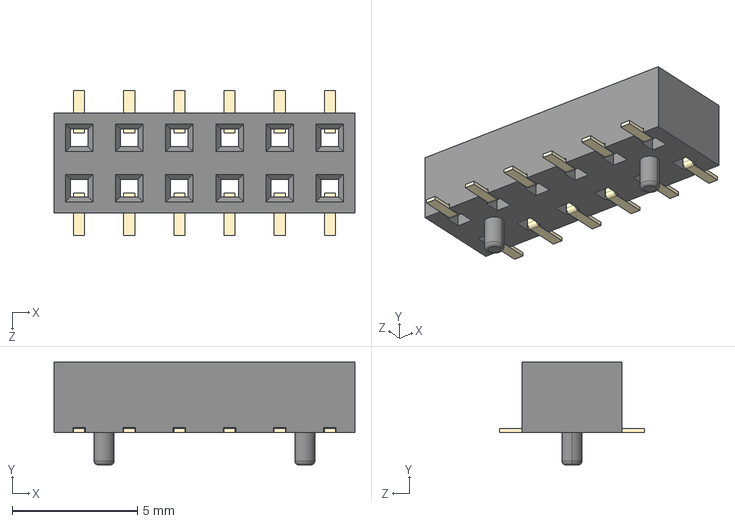
[picture p135: CAD file, 2025-08-14]
3dmodels/BF080-12-A-1-L-C.STEP
12.0 x 4.10 x 5.80 mm
Pin gold x 6
