Kageni-wq/kicad/3dmodels/XF3M_1_0415_1B.stp

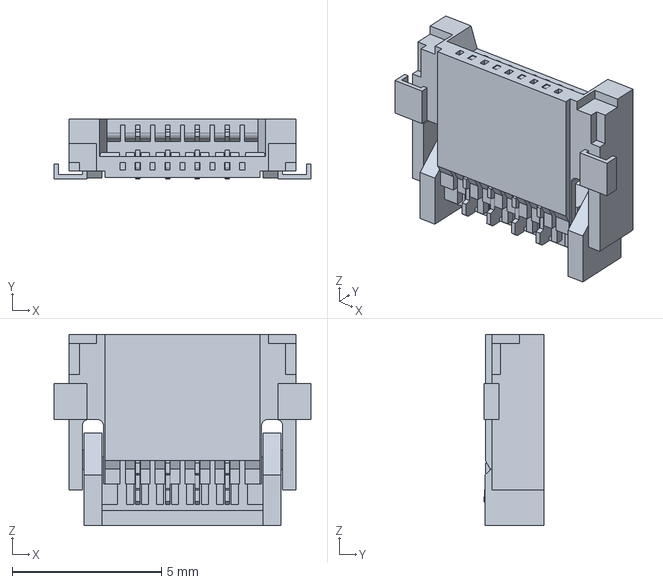
[picture p136: CAD file, 2025-08-14]
3dmodels/XF3M_1_0415_1B.stp
8.60 x 2.00 x 6.40 mm
