Kageni-wq/kicad/3dmodels/CX90BW-16P_001_.step

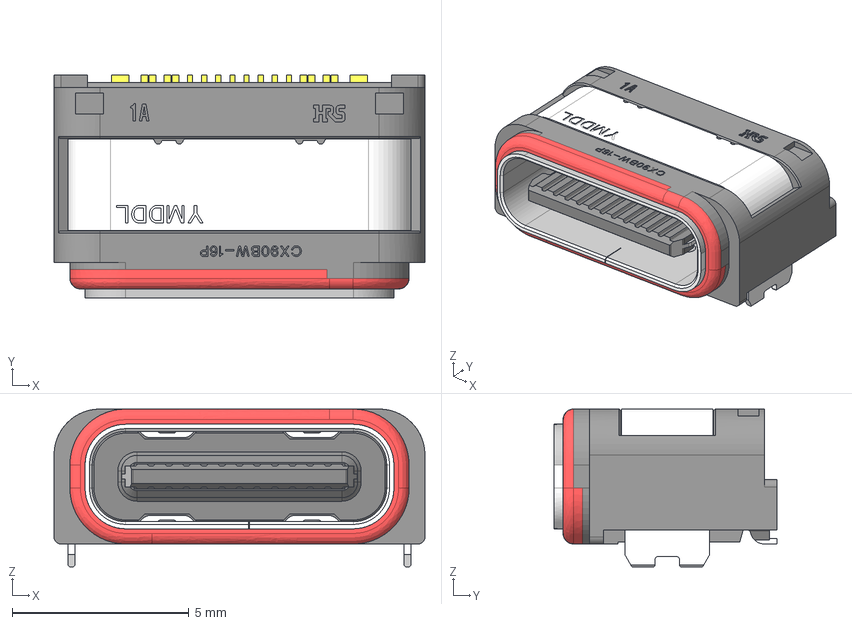
[picture p137: CAD file, 2025-08-14]
3dmodels/CX90BW-16P_001_.step
10.5 x 6.30 x 4.47 mm
