Kageni-wq/kicad/3dmodels/LDK120PU33R.step

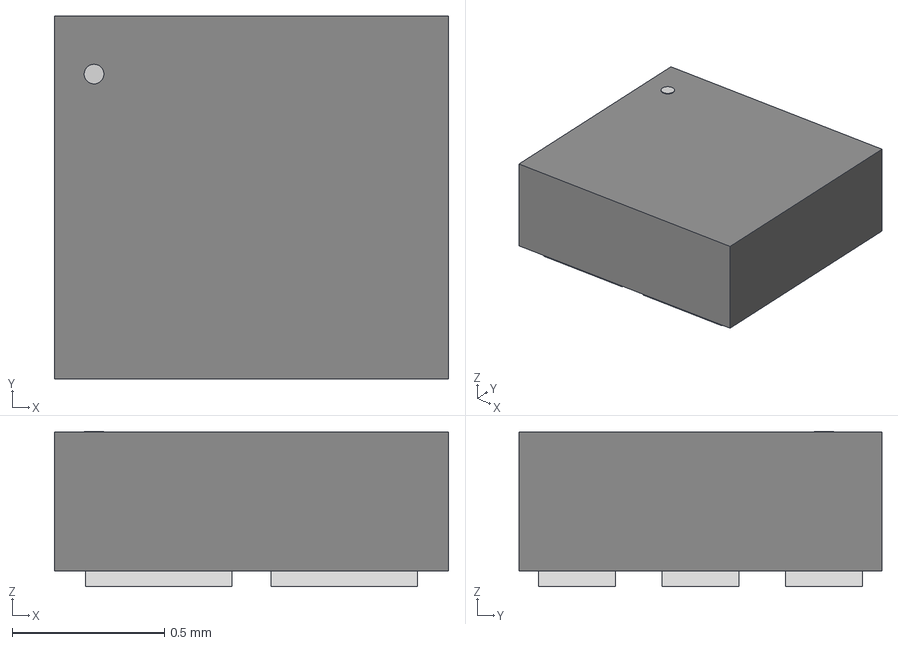
[picture p138: CAD file, 2025-08-14]
3dmodels/LDK120PU33R.step
1.30 x 1.19 x 0.511 mm
