Kageni-wq/kicad/3dmodels/HMC536LP2.step

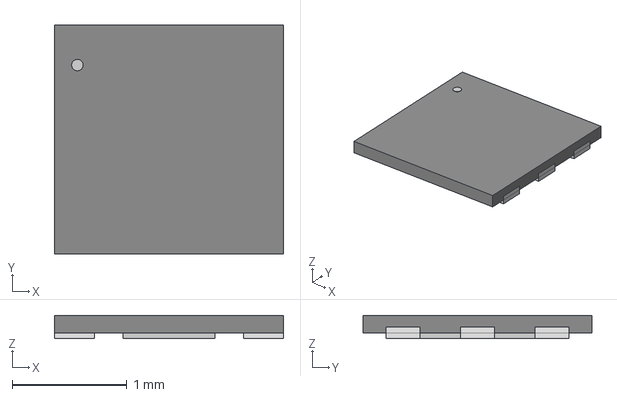
[picture p139: CAD file, 2025-08-14]
3dmodels/HMC536LP2.step
2.00 x 2.00 x 0.203 mm
