Kageni-wq/kicad/3dmodels/SSW-102-22-G-D-VS.step

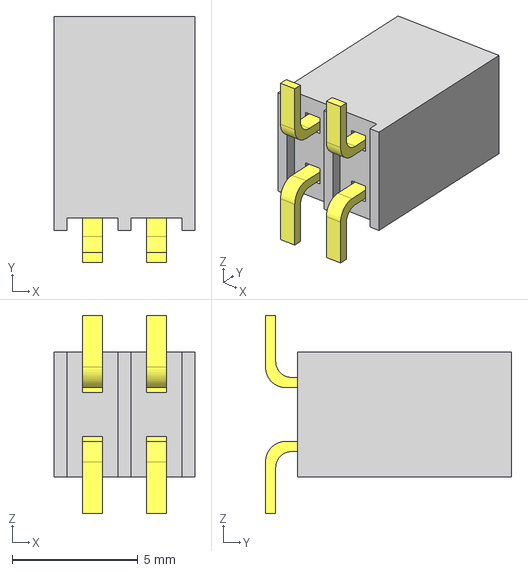
[picture p140: CAD file, 2025-03-01]
3dmodels/SSW-102-22-G-D-VS.step
5.59 x 9.78 x 7.87 mm
T1SSW-102-22-G-D-VS-TR
P2SSW-102-22-G-D-VS
