Kageni-wq/kicad/3dmodels/NLCV32T-100K-PFR.step

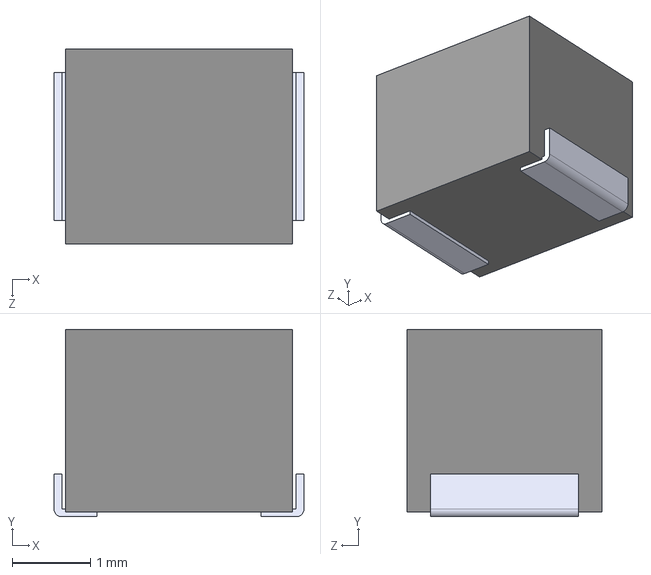
[picture p141: CAD file, 2025-03-01]
3dmodels/NLCV32T-100K-PFR.step
3.20 x 2.40 x 2.50 mm
