Kageni-wq/kicad/3dmodels/CLT-106-02-F-D-A.step

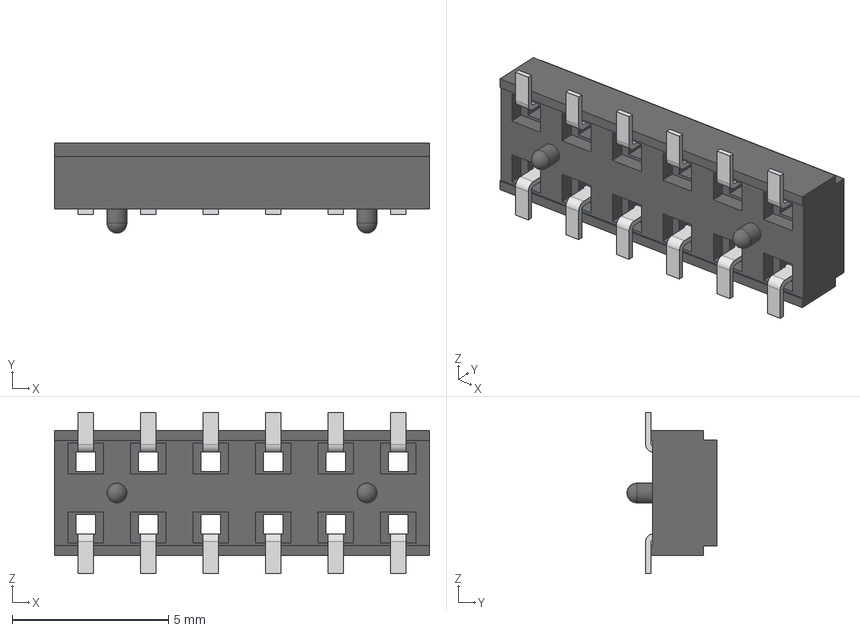
[picture p142: CAD file, 2025-03-01]
3dmodels/CLT-106-02-F-D-A.step
12.0 x 2.88 x 5.16 mm
CLT-106-02-F-D_socket
C-0602-F-_pins
CLT_alignment_pins x 2
