Kageni-wq/kicad/3dmodels/NDC7002N.step

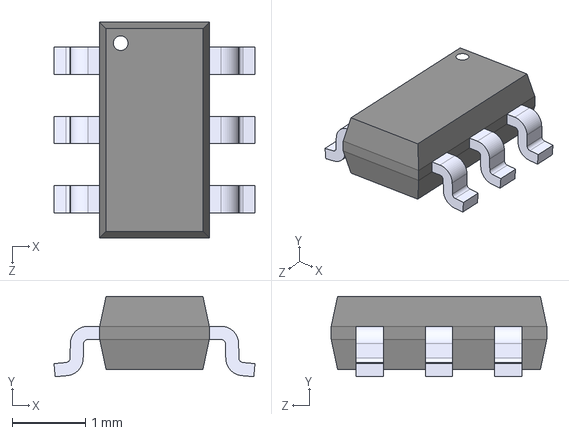
[picture p143: CAD file, 2025-03-01]
3dmodels/NDC7002N.step
2.75 x 1.10 x 2.95 mm
