Kageni-wq/kicad/3dmodels/ECS-160-8-37-CWY-TR3.step

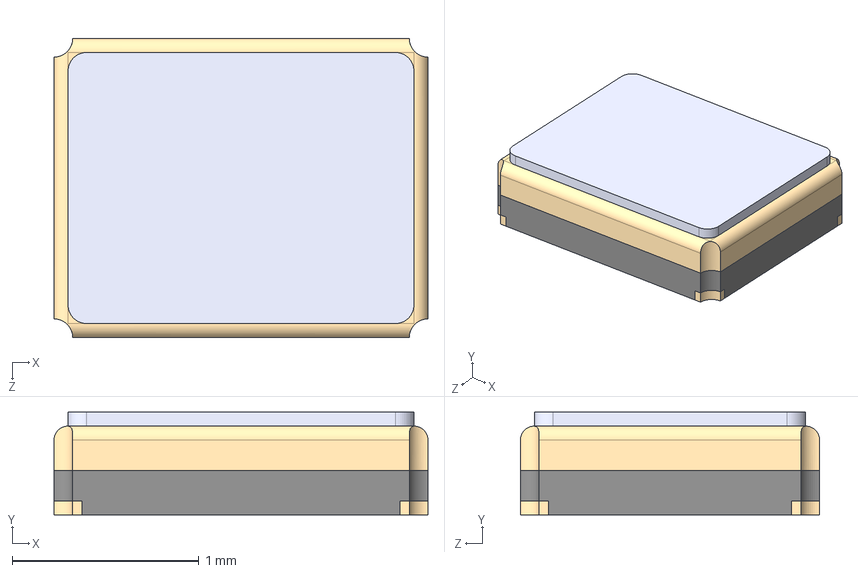
[picture p144: CAD file, 2025-03-01]
3dmodels/ECS-160-8-37-CWY-TR3.step
2.00 x 0.55 x 1.60 mm
