Kageni-wq/kicad/3dmodels/SL-108-G-11.step

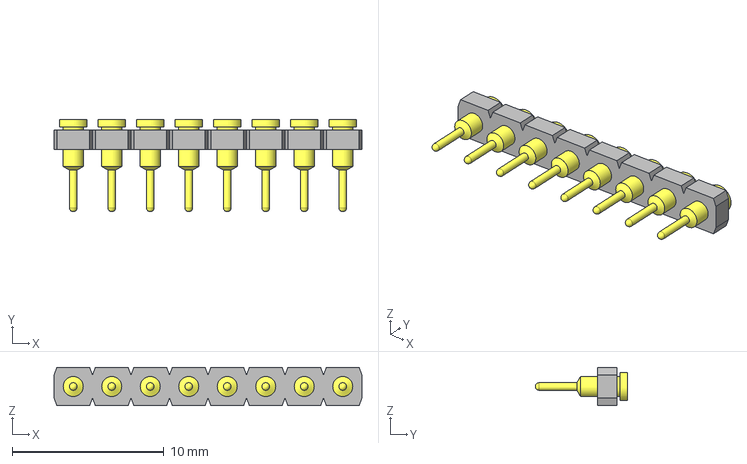
[picture p145: CAD file, 2025-03-01]
3dmodels/SL-108-G-11.step
20.3 x 6.10 x 2.54 mm
SL-108_socket
SC-4P1_pins x 8
