Kageni-wq/kicad/3dmodels/RT9193-33GB.step

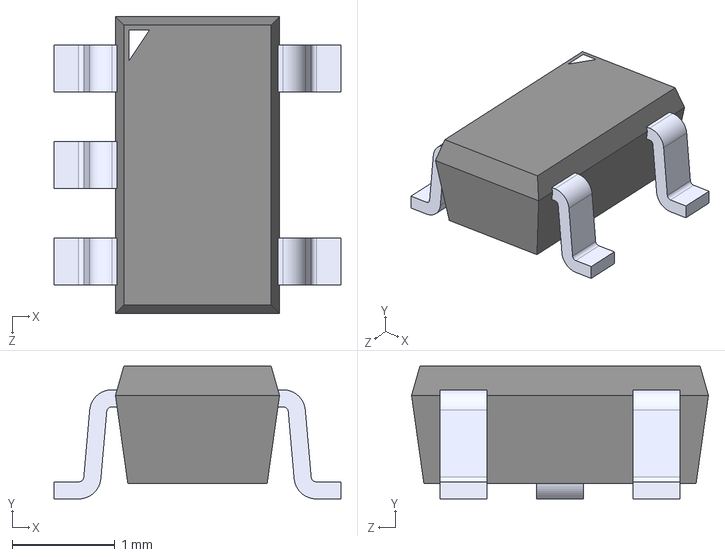
[picture p146: CAD file, 2025-03-01]
3dmodels/RT9193-33GB.step
2.79 x 1.30 x 2.90 mm
