Kageni-wq/kicad/3dmodels/XRCHA16M000F0A01R0.step

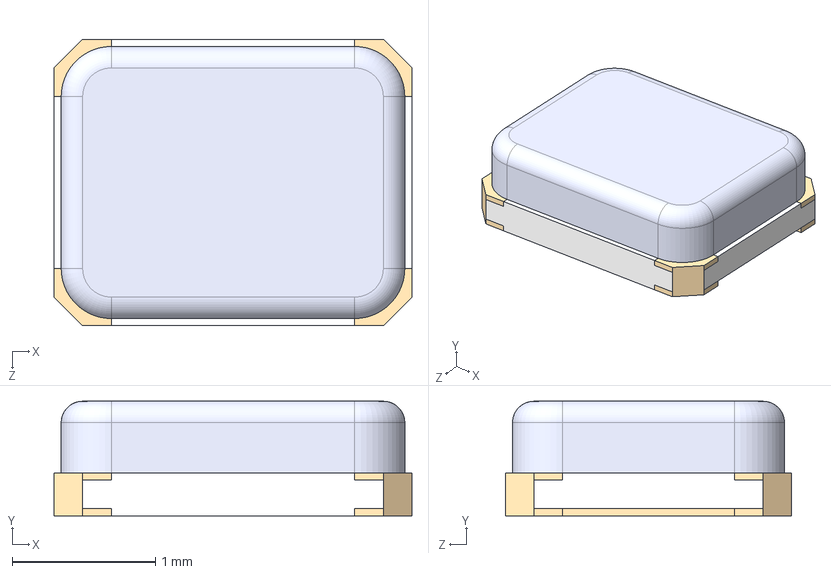
[picture p147: CAD file, 2025-03-01]
3dmodels/XRCHA16M000F0A01R0.step
2.50 x 0.8 x 2.00 mm
