Kageni-wq/kicad/3dmodels/MIC2250-2YD5-TR.step

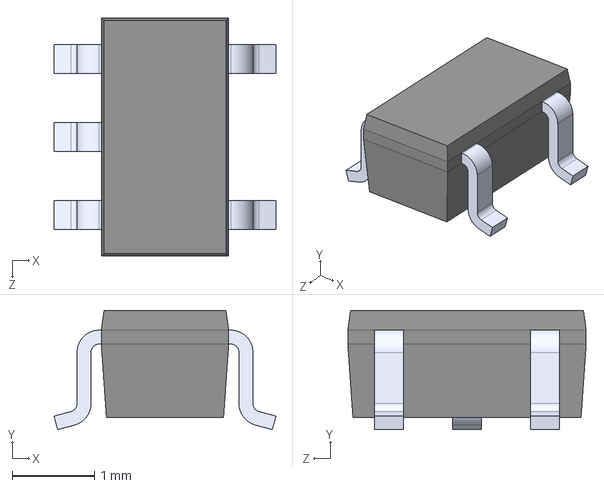
[picture p148: CAD file, 2025-03-01]
3dmodels/MIC2250-2YD5-TR.step
2.70 x 1.45 x 2.90 mm
