Kageni-wq/kicad/3dmodels/SSW-104-22-X-D-VS.step

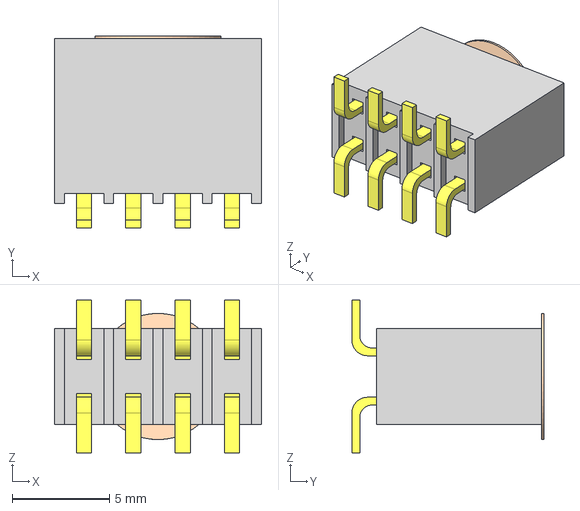
[picture p149: CAD file, 2025-03-01]
3dmodels/SSW-104-22-X-D-VS.step
10.7 x 9.91 x 7.87 mm
T1SSW-104-22-S-D-VS-K-TR
P2SSW-104-22-S-D-VS
