Kageni-wq/kicad/3dmodels/FH35C-31S-0.3SHW_50_.step

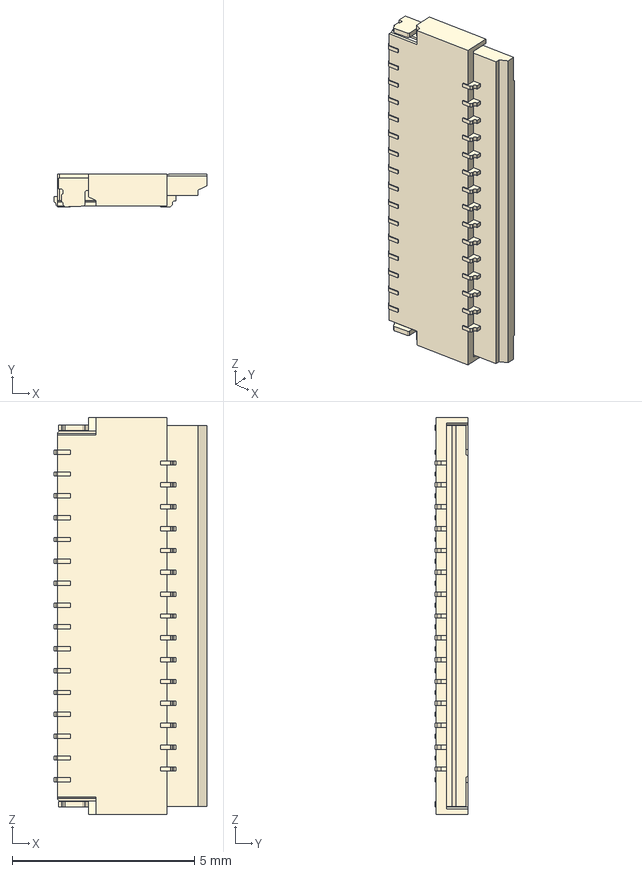
[picture p150: CAD file, 2025-03-01]
3dmodels/FH35C-31S-0.3SHW_50_.step
4.20 x 0.9 x 10.9 mm
