Kageni-wq/kicad/3dmodels/TMM-106-04-X-D.step

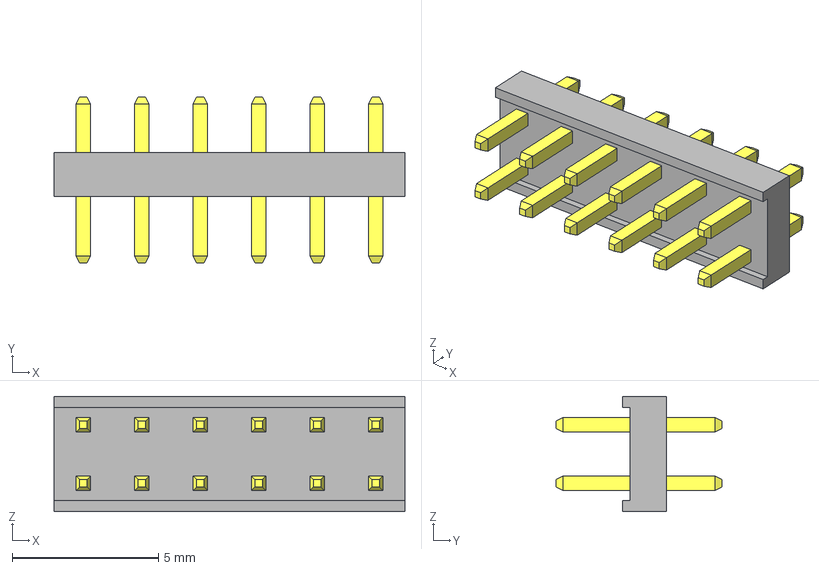
[picture p151: CAD file, 2025-03-01]
3dmodels/TMM-106-04-X-D.step
12.0 x 5.69 x 3.94 mm
TMM-106-04-G-D_body
TMM-106-04-G-D_pins1
TMM-106-04-G-D_pins2
