Kageni-wq/kicad/3dmodels/STDCRA2-16M.step

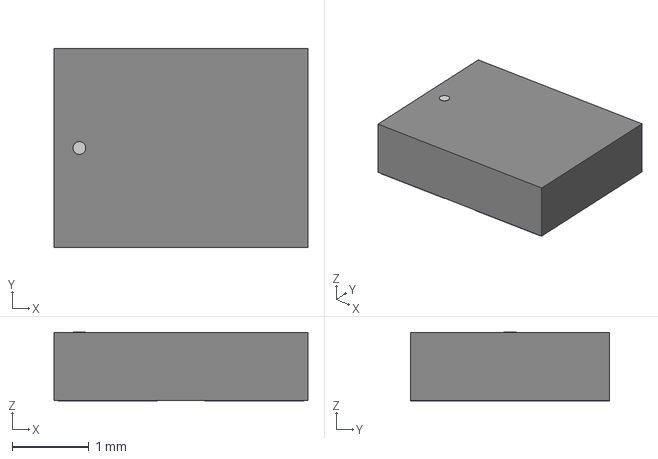
[picture p152: CAD file, 2025-03-01]
3dmodels/STDCRA2-16M.step
3.30 x 2.59 x 0.892 mm
