Kageni-wq/kicad/3dmodels/USBLC6-2P6.step

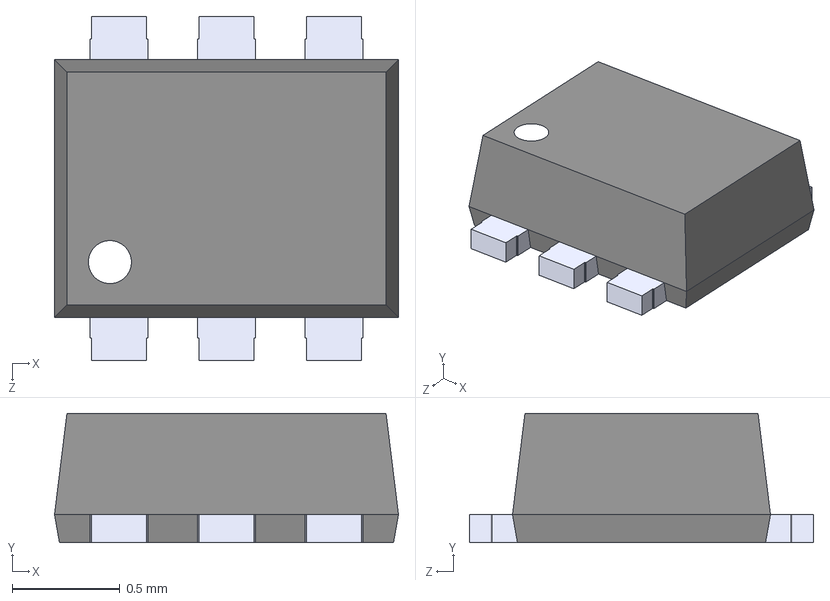
[picture p153: CAD file, 2025-02-25]
3dmodels/USBLC6-2P6.step
1.60 x 0.6 x 1.60 mm
