Kageni-wq/kicad/(list of files, cad)

Other CAD files:
3dmodels/AD8232ACPZ-WP.step
3dmodels/006284007001.stp
3dmodels/009155003852006.stp
3dmodels/009158028030061.stp
3dmodels/046284005001846.step
3dmodels/046284008001846+.stp
3dmodels/0787324001.STEP
3dmodels/0985-0-15-20-71-14-11-0.step
3dmodels/1-1734839-2.stp
3dmodels/1-2307725-0.step
3dmodels/10120045-401LF.step
3dmodels/10129383-910001ALF.step
3dmodels/10132797-011100LF.step
3dmodels/10132798-011100LF.step
3dmodels/10132798-012100LF.step
3dmodels/10144041-04011LF.step
3dmodels/10144041-06011LF.step
3dmodels/1040310811.stp
3dmodels/107129002001.stp
3dmodels/1612898-1.step
3dmodels/1735042-6-3d.stp
3dmodels/1825232-1.step
3dmodels/20021121-00008C4LF.step
3dmodels/20021321-00014C4LF.step
3dmodels/20021321-00014T4LF.step
3dmodels/2036150003.stp
3dmodels/2053380002.step
3dmodels/207129002001.stp
3dmodels/2074190081.stp
3dmodels/2074200081.stp
3dmodels/2171790001.step
3dmodels/21992304.step
3dmodels/2307727-3.STEP
3dmodels/2425578-1.stp
3dmodels/2450AT18B100E.step
3dmodels/2450AT18D0100001E.step
3dmodels/2450AT42B0100001E.step
3dmodels/472861001.stp
3dmodels/500ASSP1SM6QE.step
3dmodels/5024261430.stp
3dmodels/5024262030.stp
3dmodels/5024301430.stp
3dmodels/5035481222.stp
3dmodels/5037630591.step
3dmodels/5040500291.step
3dmodels/5040500491.stp
3dmodels/5047540700.stp
3dmodels/522070633.stp
3dmodels/54-00304.step
3dmodels/59453-051110EDHLF.step
3dmodels/5ESH935.stp
3dmodels/60168 Rev1 WB0035 Optic Customer.STEP
3dmodels/612901-1.stp
3dmodels/686106189122.step
3dmodels/800BWSP9SM6RE.step
3dmodels/800SP9B6M6RE.step
3dmodels/811-22-004-30-000101.STEP
3dmodels/830081609.step
3dmodels/84981-5.stp
3dmodels/966210-2000-AR-PR.stp
3dmodels/AA3528.STEP
3dmodels/ABM10-16.000MHZ-E20-T.step
3dmodels/ABM11-16.000MHZ-D2X-T3.step
3dmodels/ABM11W-24.0000MHZ-7-B1U-T3.step
3dmodels/ABM12W-24.0000MHZ-6-D1X-T3.step
3dmodels/ABM8G-12.288MHZ-4Y-T3.step
3dmodels/ADA4945-1ACPZ-RL.step
3dmodels/ADAU1462WBCPZ300.step
3dmodels/ADAU1466WBCPZ300.stp
3dmodels/ADAU1701JSTZ-RL.step
3dmodels/ADAU1761BCPZ-R7.step
3dmodels/ADAU1772BCPZ-RL.step
3dmodels/ADAU1850BCBZRL.step
3dmodels/AL8861Y-13.step
3dmodels/AOM-4546P-R.step
3dmodels/AOTA-B141208SR47MT.stp
3dmodels/APA2107.STEP
3dmodels/AS1170.step
3dmodels/ATSAMD21E15B_MUT.step
3dmodels/AYF530635.STEP
3dmodels/AZ1117IH-3.3TRG1.step
3dmodels/B2B-ZR-SM4-TF.step
3dmodels/B3U_1000P[].step
3dmodels/BC847BDW1T1G.step
3dmodels/BD125-10-A-0305-0580-L-B.STEP
3dmodels/BG300-03-X-X-A_REVC.step
3dmodels/BK22C07-4DP2-0.4V_3D_STP_4800815000.stp
3dmodels/BK22C07-4DS_2-0.4V_800_.stp
3dmodels/BM03B-SRSS-TB_LF__SN_.step
3dmodels/BM23PF0.8-14DP-0.35V_895_.stp
3dmodels/BM23PF0.8-14DS-0.35V_895_.stp
3dmodels/BM29B-4DP_2-0.35V_51_.step
3dmodels/BM29B0.6-2DS_2-0.35V.stp
3dmodels/BM29B0.6-2DS_2-0.35V_51_.step
3dmodels/BM29B0.6-4DS_2-0.35V_51_.step
3dmodels/BQ24195RGER.step
3dmodels/BQ24296.stp
3dmodels/BQ25100YFPT.step
3dmodels/BQ25180YBGR.step
3dmodels/BQ25798RQMR.stp
3dmodels/BQ25896RTWR.step
3dmodels/BQ27220YZFR.step
3dmodels/BQ27320YZFR.step
3dmodels/BQ27441DRZR-G1A.step
3dmodels/BT6038A.step
3dmodels/CAP_GRM0805_2X1P25_MUR.step
3dmodels/CAT24C256HU4IGT3.step
3dmodels/CES-104-01-T-D.step
3dmodels/CFAL12832C-0091B-W.STEP
3dmodels/CG04874-8M.step
3dmodels/CL-SB-12B-12T.stp
3dmodels/CLT-104-02-F-D-BE-A-K-TR.step
3dmodels/CLT-105-02-F-D-BE-A-K-TR.step
3dmodels/CP2102N-A02-GQFN20.step
3dmodels/CP2102N-A02-GQFN28R.step
3dmodels/CP2102N_A02_GQFN24.step
3dmodels/CP2112-F03-GMR.step
3dmodels/CP2615-A02-GM.stp
3dmodels/CS09166-32M.step
3dmodels/CS47L63-CWZR_CIR.step
3dmodels/CUI_DEVICES_CMC-9745-44P.step
3dmodels/CUI_DEVICES_CMEJ-0415-42-LP.step
3dmodels/CVS-01TB.stp
3dmodels/C_1210.step
3dmodels/D6C90F2LFS.stp
3dmodels/DF40HB(2.5)-10DS-0.4V.stp
3dmodels/DFE201610P-1R0M_P2.step
3dmodels/DMM-3526-4-B.step
3dmodels/DMM-4026-B-I2S-R.step
3dmodels/DS04-254-2-01BK-SMT.step
3dmodels/DSC6001HI1A-004.0000.step
3dmodels/ECS-1633-240-BN-TR.step
3dmodels/ESD122DMXR.step
3dmodels/ESP32-D0WD-V3_EXP.step
3dmodels/ESP32-D0WDQ6.step
3dmodels/ESP32-PICO-V3-02.stp
3dmodels/ESP32-PICO-V3.step
3dmodels/ESP32-S3.step
3dmodels/EVQ-Q2Y03W.step
3dmodels/FFC2B28-08-G.step
3dmodels/FH34SRJ-10S-0.5SH_50_.step
3dmodels/FH34SRJ-12S-0.5SH.stp
3dmodels/FH34SRJ-18S-0.5SH_50_.step
3dmodels/FP11055_LISA2-RS-PIN.step
3dmodels/FTSH-107-01-L-DV-K-P-TR.step
3dmodels/Fuse_0603.STP
3dmodels/GRPB051VWTC-RC.STEP
3dmodels/HFW6R-2STE1H1LF.stp
3dmodels/HFW8R-2STE1H1LF.stp
3dmodels/HRO TYPE-C-31-M-12.step
3dmodels/HTSS-110-01-T-DV.step
3dmodels/ICS-41351.step
3dmodels/ICS-43432.step
3dmodels/ICS-43434.step
3dmodels/IM69D130V01XTSA1.step
3dmodels/IND_0402.step
3dmodels/IND_TAIYO_NRH2410_TAY.step
3dmodels/ISP2053-AX-RS.stp
3dmodels/JS102011JAQN.step
3dmodels/JS1400BFQ.stp
3dmodels/LC709203FXE_04MH.step
3dmodels/LDI1117-3.3H.step
3dmodels/LM3281YFQR.step
3dmodels/LM358DR.step
3dmodels/LQH3NPN4R7MMEL.step
3dmodels/LQH44PN330MPRL.step
3dmodels/LS39G5F-T.step
3dmodels/M20-7810445.step
3dmodels/M20-9740442.step
3dmodels/M22-7131242.step
3dmodels/M24C32-FMC6TG.step
3dmodels/M50-3031042.step
3dmodels/M50-3531042.step
3dmodels/M50-3930242.IGS
3dmodels/M50-3930242.STL
3dmodels/M50-3930442.STEP
3dmodels/M52-040023V1045.step
3dmodels/M52-5001245.step
3dmodels/MAX17048G_T10.step
3dmodels/MAX17048X+T10.step
3dmodels/MAX4063ETE_.step
3dmodels/MAX98091ETM+T.step
3dmodels/MAX9814ETD_T.step
3dmodels/MCP73830L.step
3dmodels/MCP73830T.step
3dmodels/MCP73833-FCIMF.step
3dmodels/MF-FSML1258-2.STP
3dmodels/MIC23050-SYML-TR.step
3dmodels/MIC5317-3.3YMT-TZ.step
3dmodels/MIC826SYMT-TR.step
3dmodels/MLP2016V2R2MT0S1.step
3dmodels/MM8030-2610RJ3.step
3dmodels/MM8030-2610RK0.step
3dmodels/MP2637GR.step
3dmodels/MP3412EJ-LF-Z.step
3dmodels/MPM38222GR.step
3dmodels/NPM1100-CAAB-R7.stp
3dmodels/NPM1100-QDAA-R7.step
3dmodels/NPM1300-QEAA-R.stp
3dmodels/NRF5340-QKAA-R7.step
3dmodels/NTE4153NT1G.STEP
3dmodels/OPA1637DGKR.stp
3dmodels/OPA1671IDCKT.stp
3dmodels/OPA335AIDBVR.step
3dmodels/OS102011MS2QN1.step
3dmodels/Omron-B3SE-1002P.step
3dmodels/PB400EEQR1BLK.step
3dmodels/PCA9554ARGTR.step
3dmodels/PCA9554ARGTR.stl
3dmodels/PCM1821.stp
3dmodels/PEC11S-929K.STP
3dmodels/PI3USB221EZUAEX.step
3dmodels/PMEG4010CEJ_115.step
3dmodels/QFN 24.STEP
3dmodels/RP2040.step
3dmodels/RT4533GJ6.step
3dmodels/RT8010-33GQW.step
3dmodels/RT9527GQW.STEP
3dmodels/S2B-PH-SM4-TB.step
3dmodels/S2B-ZR-SM4A-TF.step
3dmodels/SIP32431DNP3-T1GE4.step
3dmodels/SKSUAAE010.step
3dmodels/SL-106-TT-19.step
3dmodels/SL-112-T-39.step
3dmodels/SN74AHCT1G125DCKR.step
3dmodels/SN74AHCT1G125DRLR.stp
3dmodels/SN74AUP1G14DRLR.step
3dmodels/SOD323F.STEP
3dmodels/SOT-323-3_2P2X1P35_ONS.step
3dmodels/SPH0645LM4H-B.step
3dmodels/SR4W035_3D.step
3dmodels/SST-08-UV-A40-D365-00.step
3dmodels/SSW-110-02-F-S-RA.step
3dmodels/STC3100IQT.stp
3dmodels/STM32F411CEY6TR.step
3dmodels/STM32G0B1KEU6.step
3dmodels/STM32L433CCU6.step
3dmodels/STM32LO31G6U7.step
3dmodels/STM32U083KCU6.stp
3dmodels/STM32U535CBU6.stp
3dmodels/STM32U545CET6Q.step
3dmodels/STM32WBA50KGU6.stp
3dmodels/STM32WBA55CGU6.step
3dmodels/TE_84953-6.stp
3dmodels/TL3305BF260QG.step
3dmodels/TLV320ADC3120.stp
3dmodels/TLV320AIC3204IRHBR.step
3dmodels/TLV75101PDSQT.stp
3dmodels/TMM-104-01-X-D-SM.step
3dmodels/TMM-104-01-X-D.step
3dmodels/TMM-105-01-X-D-SM.step
3dmodels/TPS22919DCKR.step
3dmodels/TPS25750.stp
3dmodels/TPS25750DRJKR.step
3dmodels/TPS25814.stp
3dmodels/TPS61230ARNSR.step
3dmodels/TPS62082DSGR.step
3dmodels/TPS63030DSKR.step
3dmodels/TPS7A2025PDQNR.step
3dmodels/TPS7A2033PDBVR.stp
3dmodels/TPS7A2033PYCJR.step
3dmodels/TPS92201DDRVR.step
3dmodels/TPSM828303ARDSR.stp
3dmodels/TUSB2046BIRHBR.step
3dmodels/TUSB422IYFPR.step
3dmodels/TYPE-C-31-M-12.step
3dmodels/USB1015-15-L-A.stp
3dmodels/USB2244-AEZG-06.step
3dmodels/USB2422_MJ.stp
3dmodels/USB2513B-AEZC.step
3dmodels/USB4120-03-C_REVA.step
3dmodels/USBLC6-2SC6.step
3dmodels/VLS201612HBX-2R2M-1.step
3dmodels/VLS252012HBX-1R0M-1.step
3dmodels/VLS3012HBX-220M.step
3dmodels/VREG_MIC2877-AYFT-TR.step
3dmodels/W25Q16JVSSIQ_TR.stp
3dmodels/W25Q32JVZPIQ.step
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
