Kageni-wq/kicad/(notices)

Notices in the files:
3dmodels/CLT-106-02-F-D-A.step:
author */ ('License CC BY-ND 4.0'),
